cryoTUD/optobot/README.md

# optobot

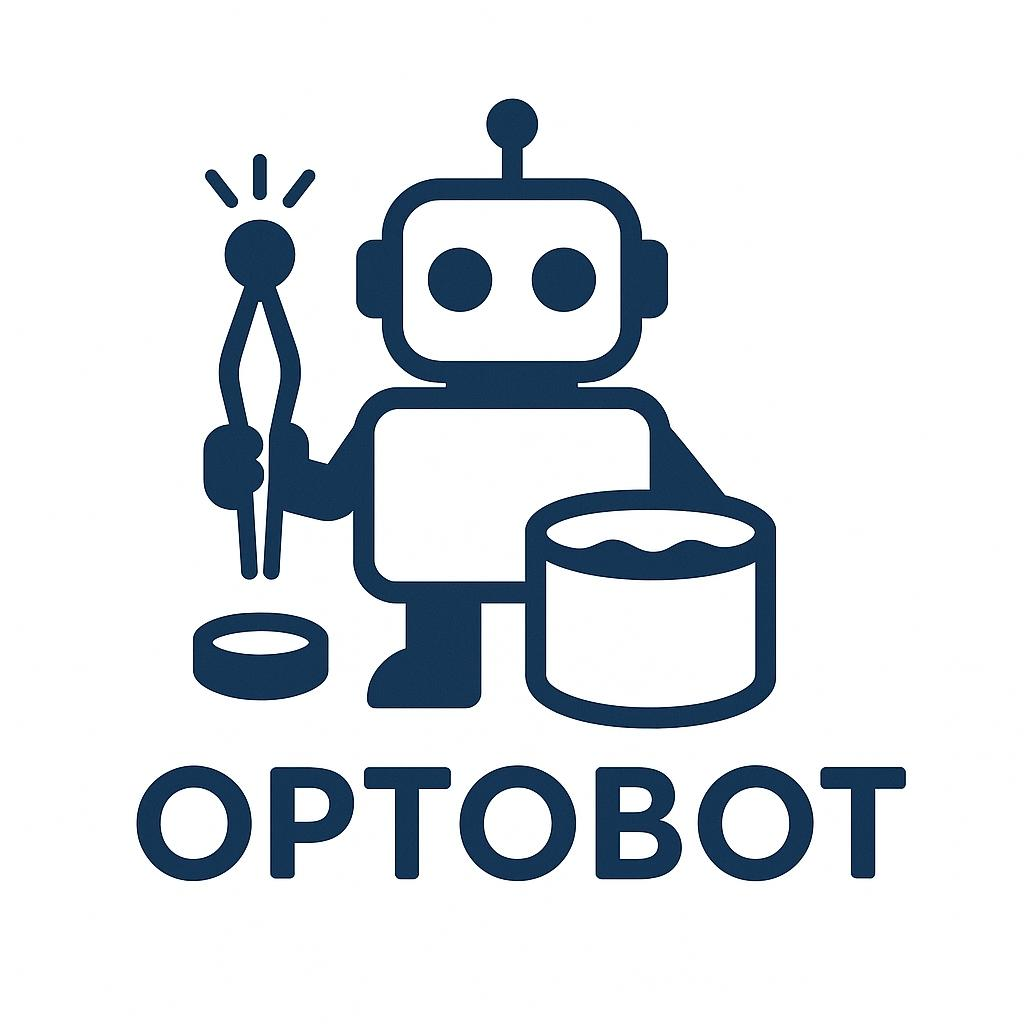
[picture p1: docs/optobot_logo.jpg]
