cryoTUD/optobot/modules/00_Electronics/images/Control Box/Control box Bottom lid with Electronics.png

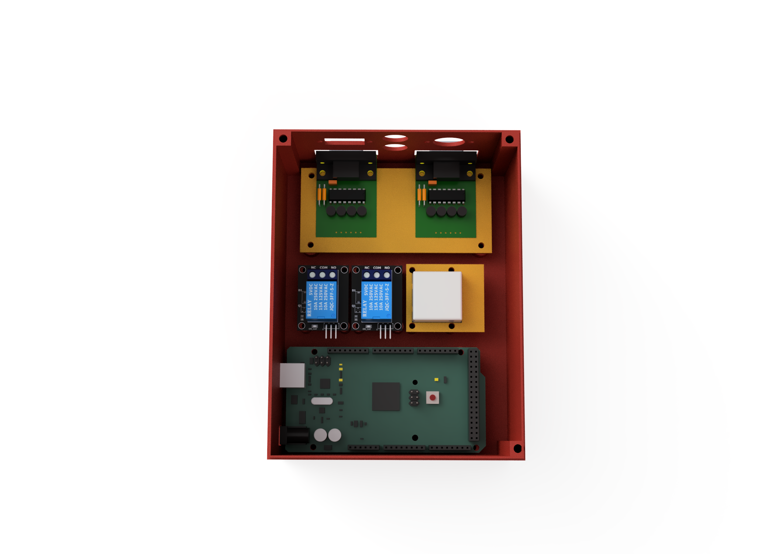
modules/00_Electronics/images/Control Box/Control box Bottom lid with Electronics.png
