cryoTUD/optobot/modules/00_Electronics/images/Control Box/Control Box Isometric Left.png

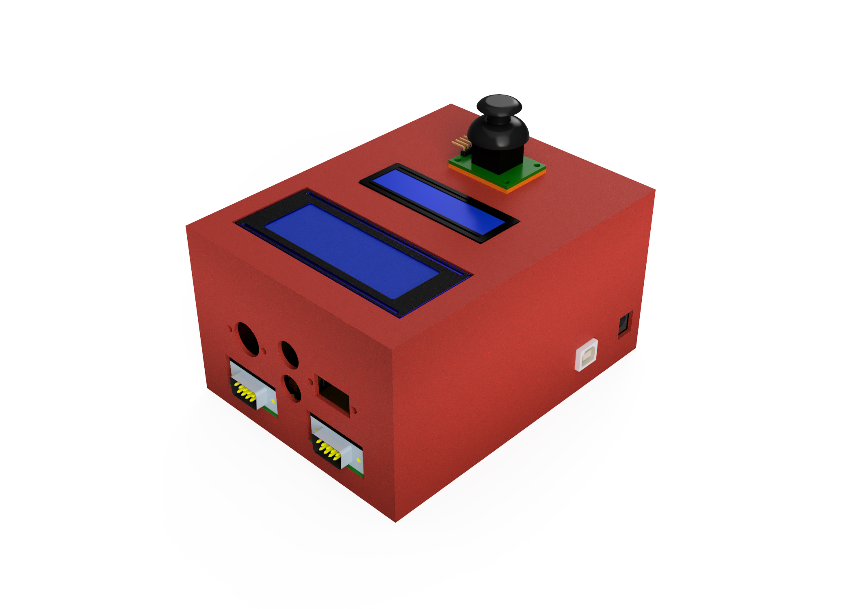
modules/00_Electronics/images/Control Box/Control Box Isometric Left.png
