cryoTUD/optobot/modules/00_Electronics/images/Control Box/Control Box Isometric right.png

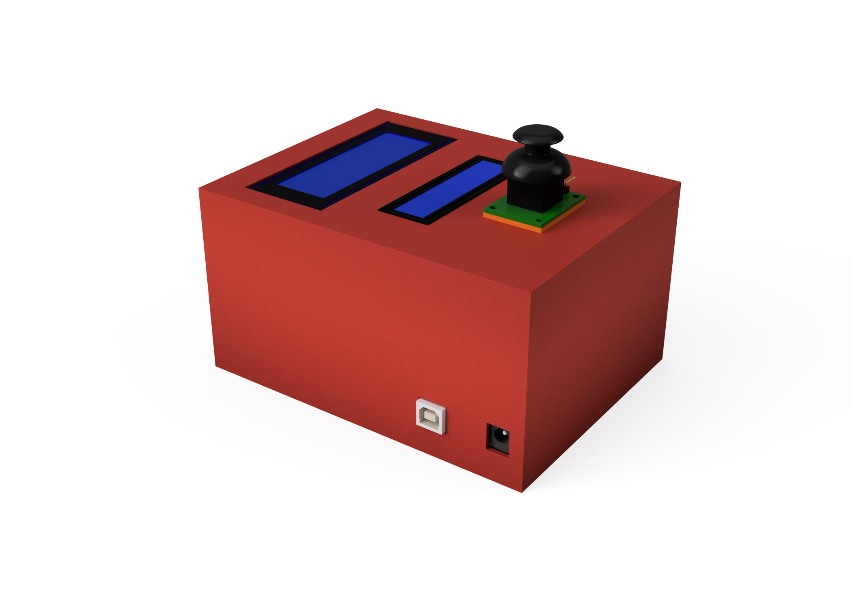
modules/00_Electronics/images/Control Box/Control Box Isometric right.png
