cryoTUD/optobot/modules/00_Electronics/images/Control Box/Control box Top lid with electronics.png

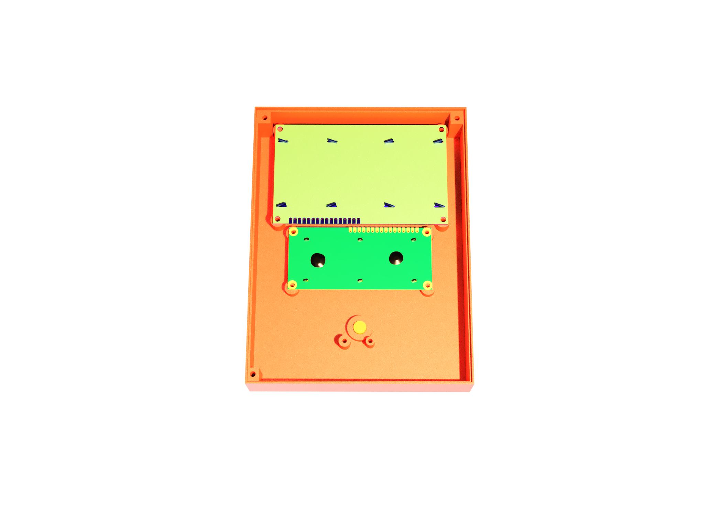
modules/00_Electronics/images/Control Box/Control box Top lid with electronics.png
