cryoTUD/optobot/modules/00_Electronics/images/PID Box/PID box bottom lid with electronics.png

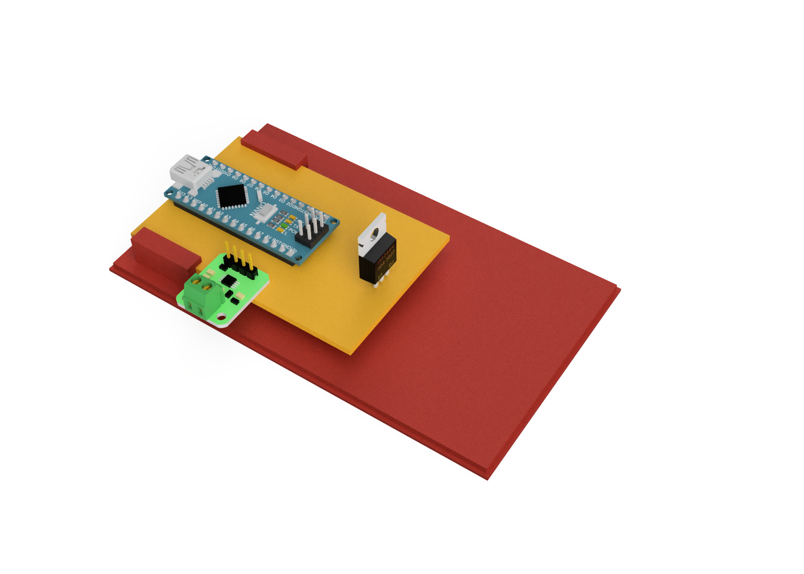
modules/00_Electronics/images/PID Box/PID box bottom lid with electronics.png
