cryoTUD/optobot/modules/00_Electronics/images/PID Box/PID Box Isometric Front.png

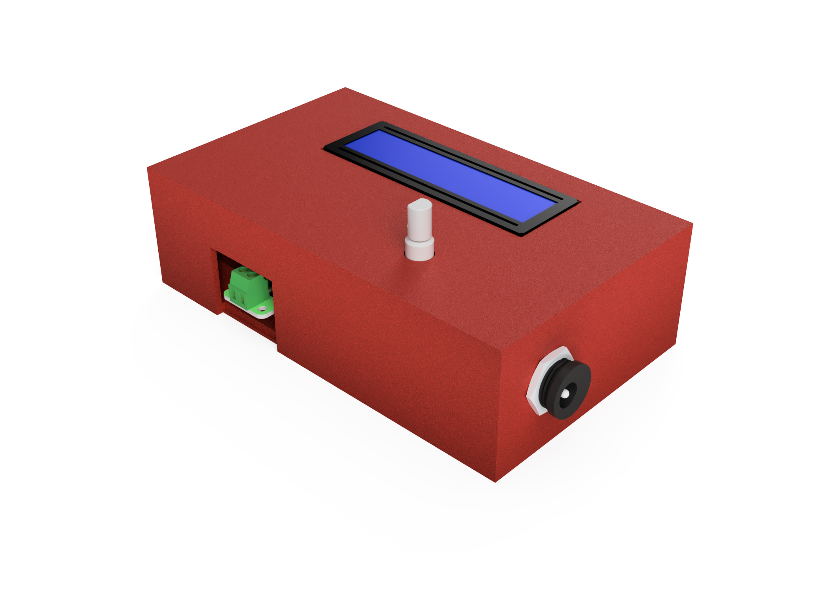
modules/00_Electronics/images/PID Box/PID Box Isometric Front.png
