cryoTUD/optobot/modules/00_Electronics/images/PID Box/PID box isometric rear.png

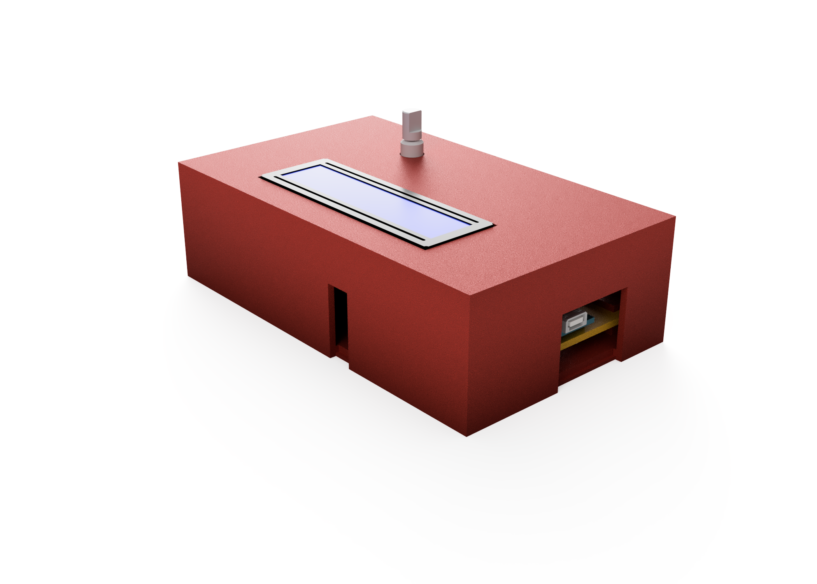
modules/00_Electronics/images/PID Box/PID box isometric rear.png
