cryoTUD/optobot/modules/02_Climate_chamber/images/02.1_Humidifier_Chamber/Humidifier chamber Isometric.png

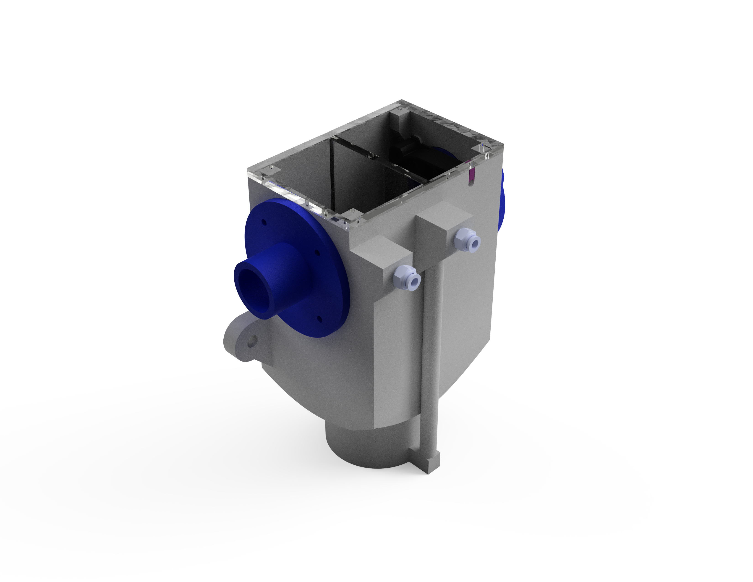
modules/02_Climate_chamber/images/02.1_Humidifier_Chamber/Humidifier chamber Isometric.png
