cryoTUD/optobot/modules/02_Climate_chamber/images/02.2_Reservoir/Reservoir Isometric Front left.png

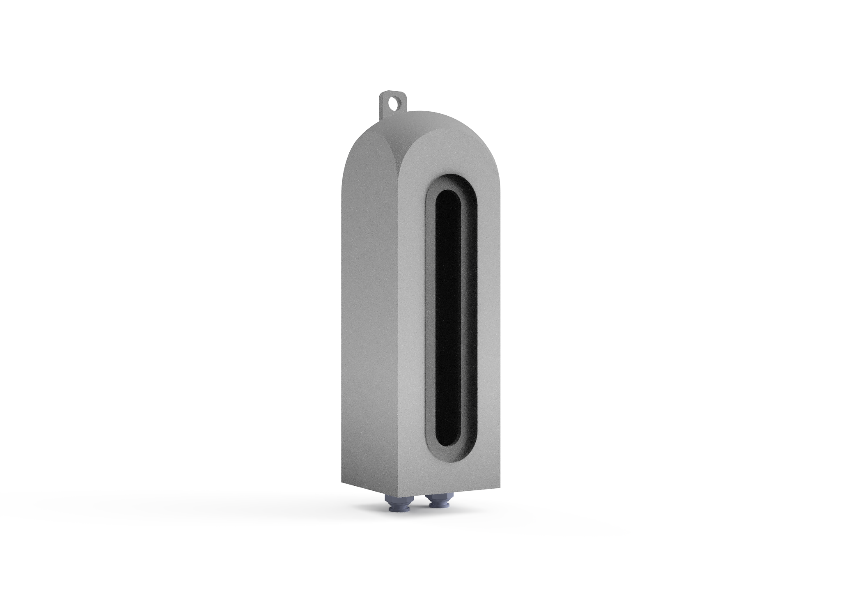
modules/02_Climate_chamber/images/02.2_Reservoir/Reservoir Isometric Front left.png
