cryoTUD/optobot/modules/02_Climate_chamber/images/02_Climate_Chamber/Left front Isometric.PNG

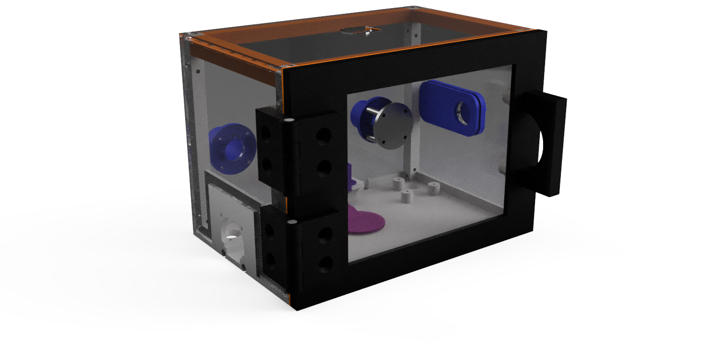
modules/02_Climate_chamber/images/02_Climate_Chamber/Left front Isometric.PNG
