cryoTUD/optobot/modules/02_Climate_chamber/images/02_Climate_Chamber/Left rear Isometric.png

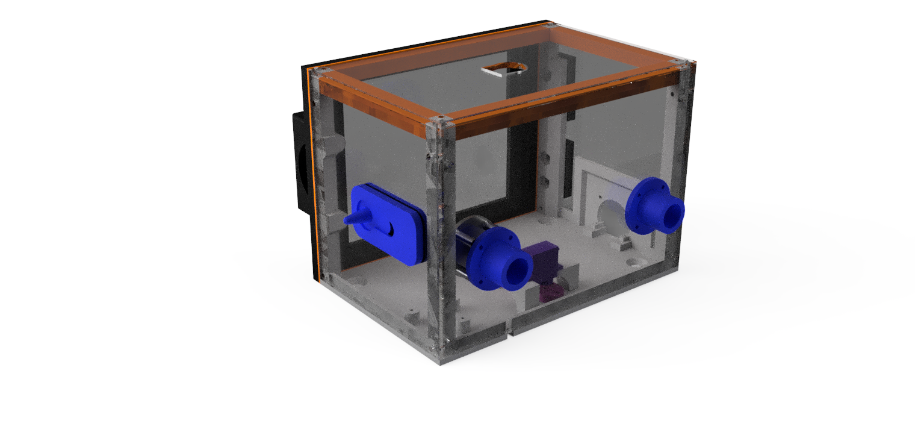
modules/02_Climate_chamber/images/02_Climate_Chamber/Left rear Isometric.png
