cryoTUD/optobot/modules/02_Climate_chamber/images/02_Climate_Chamber/Right front Isometric.png

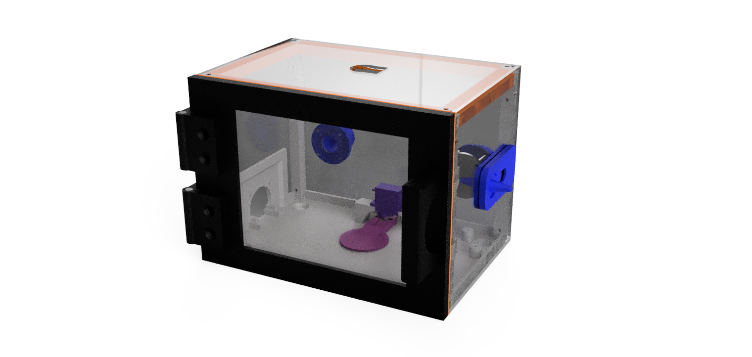
modules/02_Climate_chamber/images/02_Climate_Chamber/Right front Isometric.png
