cryoTUD/optobot/modules/02_Climate_chamber/images/02_Climate_Chamber/Right rear isometric Fine.png

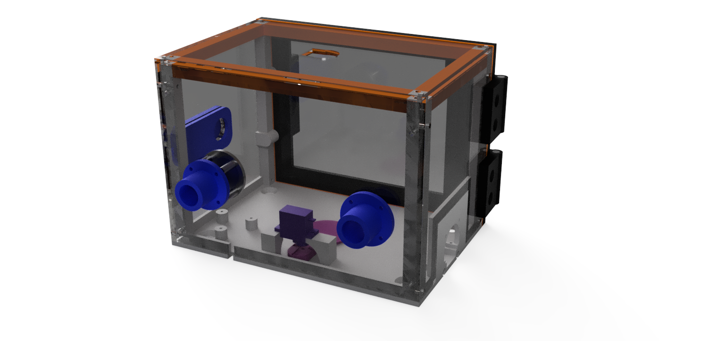
modules/02_Climate_chamber/images/02_Climate_Chamber/Right rear isometric Fine.png
