cryoTUD/optobot/modules/03_Led/images/Lens mount Isometric.png

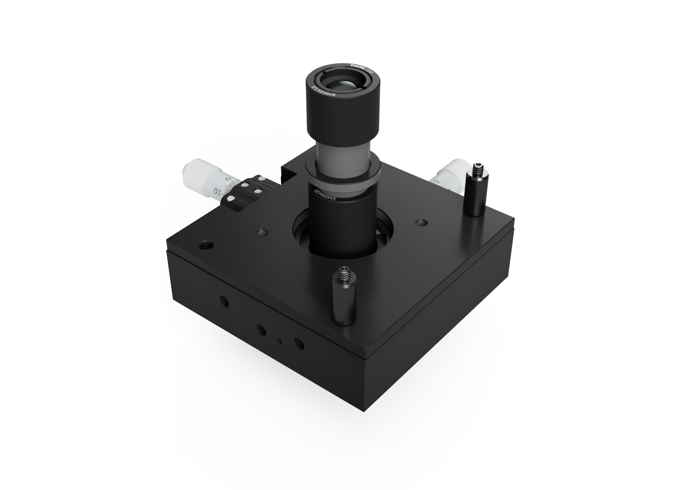
modules/03_Led/images/Lens mount Isometric.png
