cryoTUD/optobot/modules/03_Led/images/Lens mount top.png

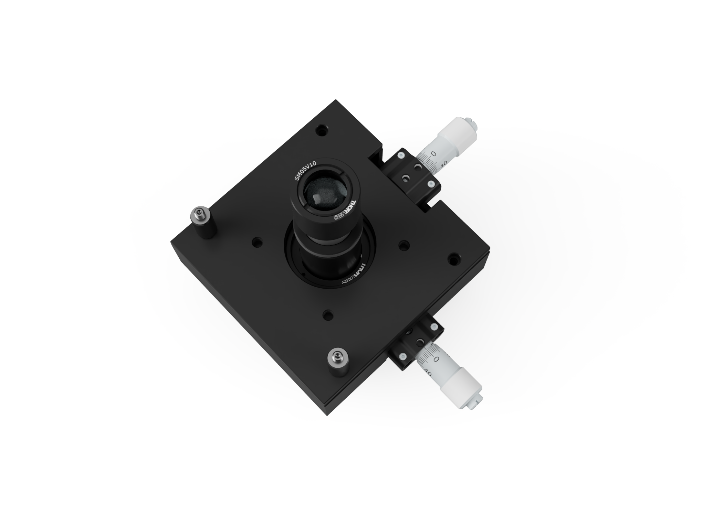
modules/03_Led/images/Lens mount top.png
