cryoTUD/optobot/modules/05_Temperature_controlled_cup/images/Isometric.png

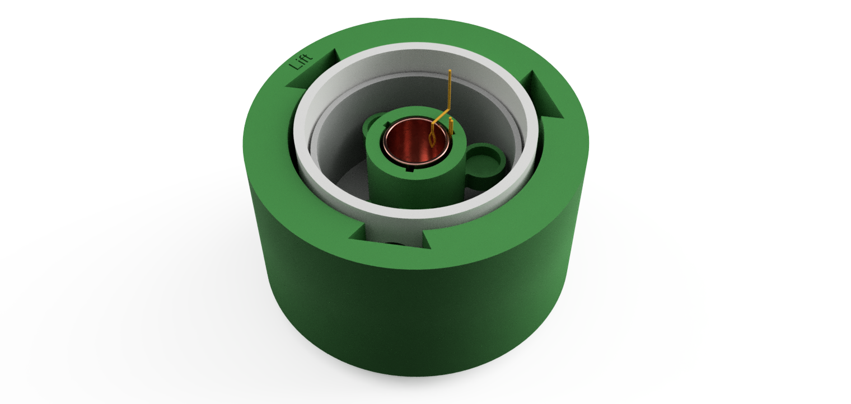
modules/05_Temperature_controlled_cup/images/Isometric.png
