cryoTUD/optobot/modules/05_Temperature_controlled_cup/images/Top.png

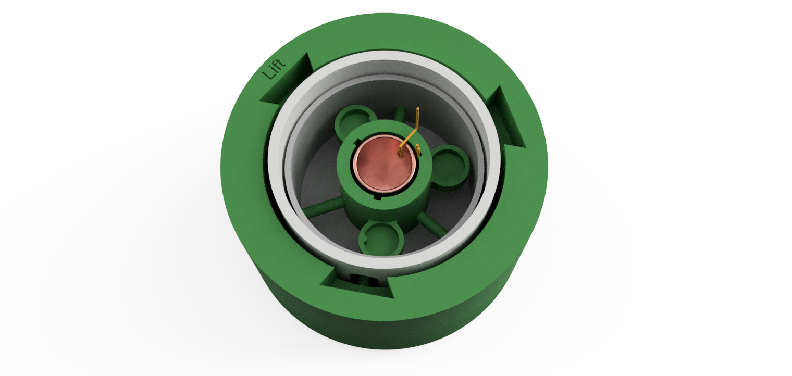
modules/05_Temperature_controlled_cup/images/Top.png
