cryoTUD/optobot/modules/02_Climate_chamber/CAD/Assembly/02.2 Reservoir assembly.step

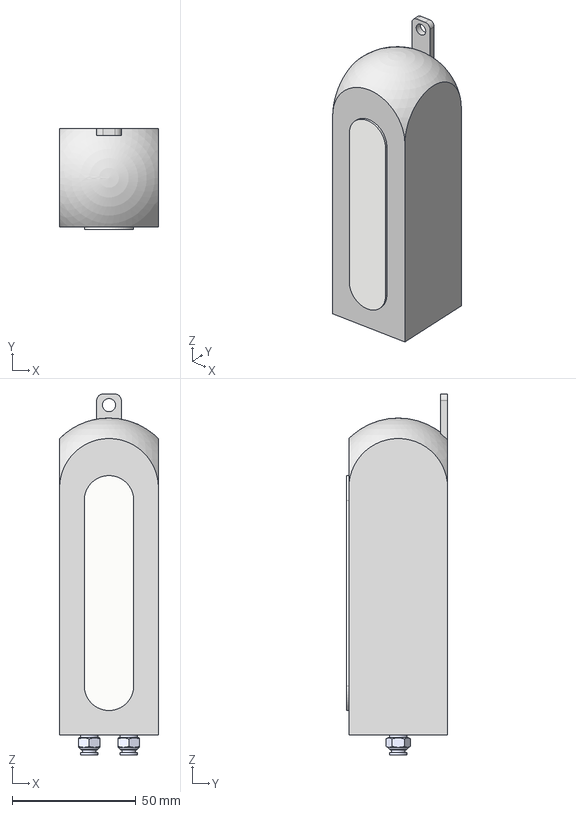
[picture p21: CAD file, 2026-11-11]
modules/02_Climate_chamber/CAD/Assembly/02.2 Reservoir assembly.step
40.0 x 41.0 x 146.0 mm
02-23 Reservoir
02-24 Reservoir window
02-34 Pneumatic fitting 6mm, M5, Placeholder x 2
