cryoTUD/optobot/modules/04_Plunger_motor/CAD/Assembly/04 - Plunger motor Assembly.step

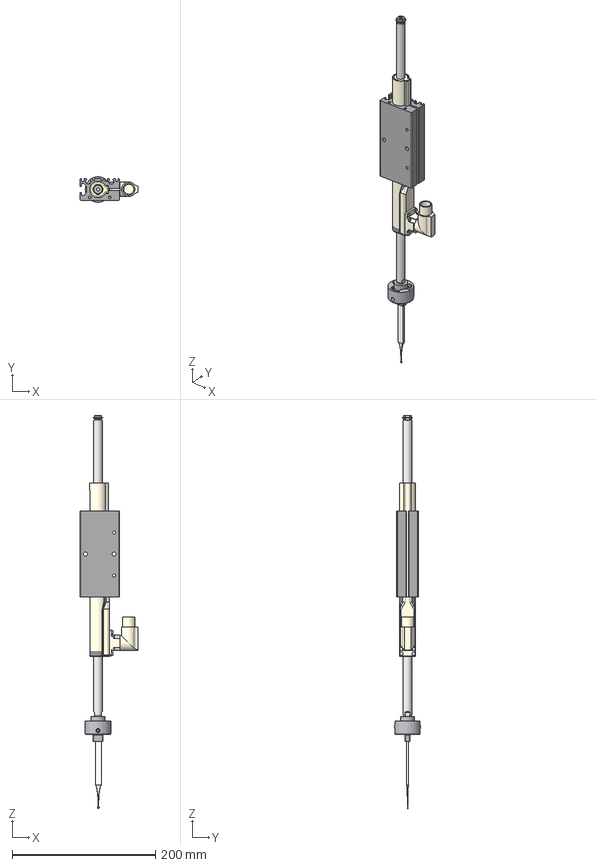
[picture p23: CAD file, 2026-11-11]
modules/04_Plunger_motor/CAD/Assembly/04 - Plunger motor Assembly.step
80.7 x 35.7 x 548.1 mm
04-03 Plunger motor linear slider
04-17 12mm Circlip Placeholder
04-15 Tweezer snaplock Male
04-16 Tweezer snaplock Female
Tweezer Placeholder
04-01 Plunger Connection Flange
PS01-23-R_PS01-23x160-R_Stator
PS01-23-R_PS01-23x160-R_Connector
