cryoTUD/optobot/modules/02_Climate_chamber/CAD/Assembly/02.3 Valve assembly.step

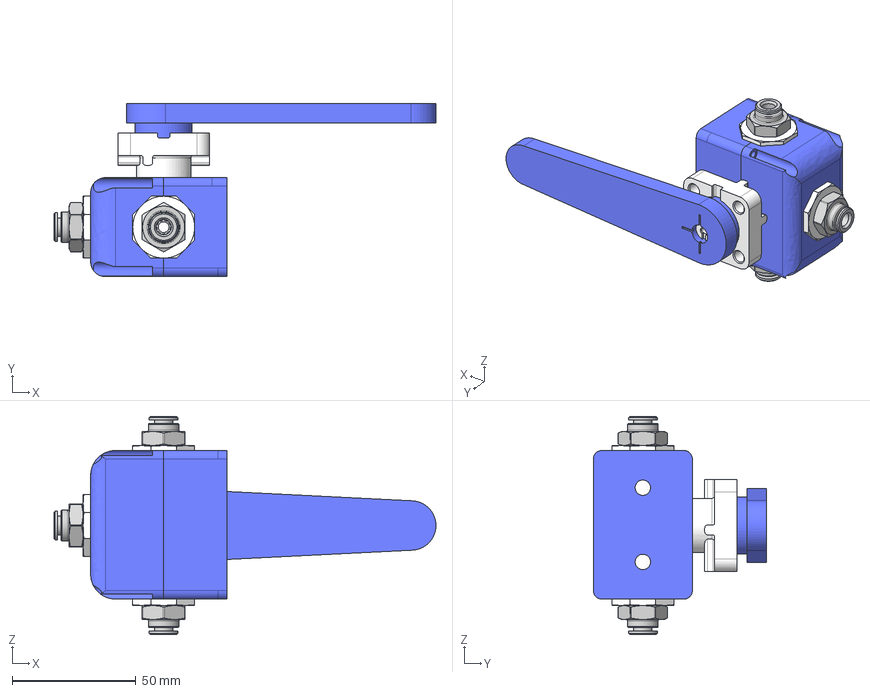
[picture p24: CAD file, 2026-11-11]
modules/02_Climate_chamber/CAD/Assembly/02.3 Valve assembly.step
154.3 x 70.0 x 88.1 mm
02-40 Valve support box
02-41 Valve support box lid
02-37 3-way Valve Placeholder
02-33 Pneumatic fitting 6mm, 1/4 In, Placeholder x 3
02-38 Valve lever
