cryoTUD/optobot/modules/00_Electronics/CAD/Assembly/00 - Control Box.step

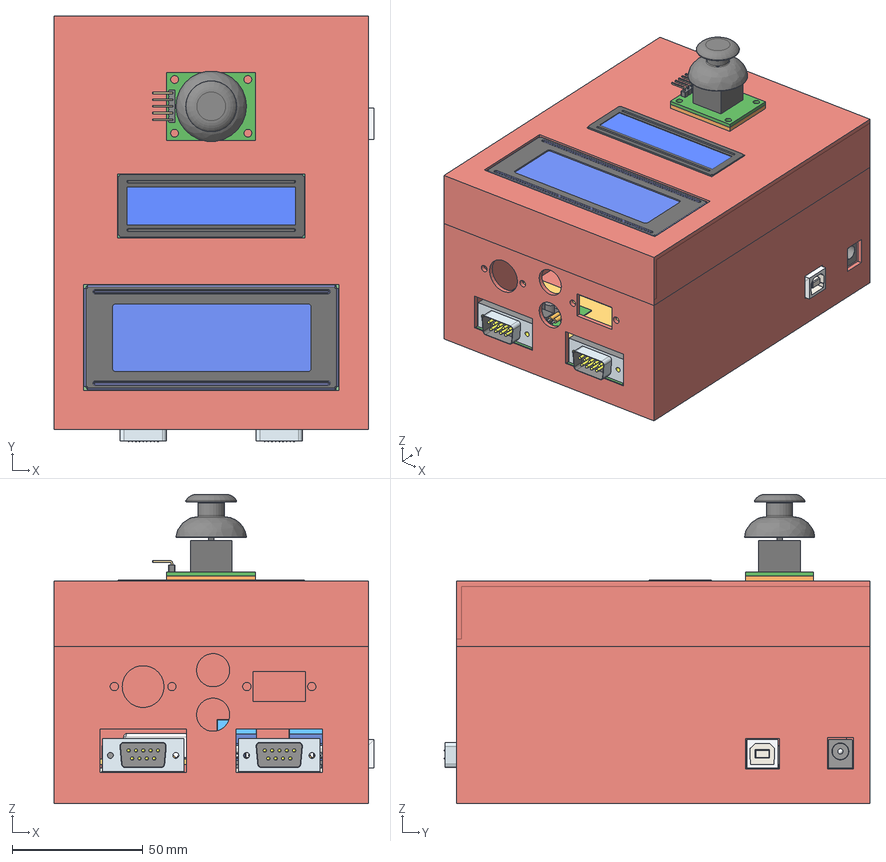
[picture p25: CAD file, 2026-11-11]
modules/00_Electronics/CAD/Assembly/00 - Control Box.step
122.1 x 162.7 x 118.2 mm
00-01 Control Box Bottom
00-02 Control Box Top
00-05 Arduino Mega Placeholder
00-06 Board relay Placeholder x 2
00-14 Perfboard Max232 support Placeholder
00-19 Perfboard DC/DC converter support Placeholder
00-10 DC/DC converter Placeholder
00-09 Joystick mount
00-12 LDC 16x2 Placeholder
00-11 LCD 20x4 Placeholder
