cryoTUD/optobot/modules/00_Electronics/CAD/STEP/00-19 Perfboard DC-DC converter support Placeholder.step

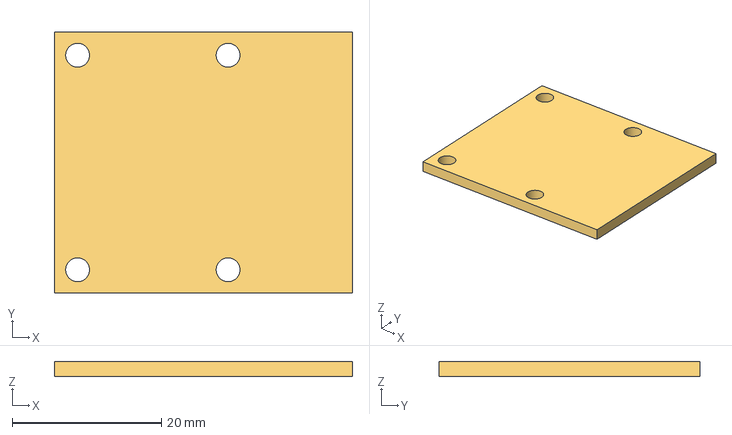
[picture p26: CAD file, 2026-11-11]
modules/00_Electronics/CAD/STEP/00-19 Perfboard DC-DC converter support Placeholder.step
40.0 x 35.0 x 2.00 mm
