cryoTUD/optobot/modules/00_Electronics/CAD/STL/00-01 Control Box Bottom.stl

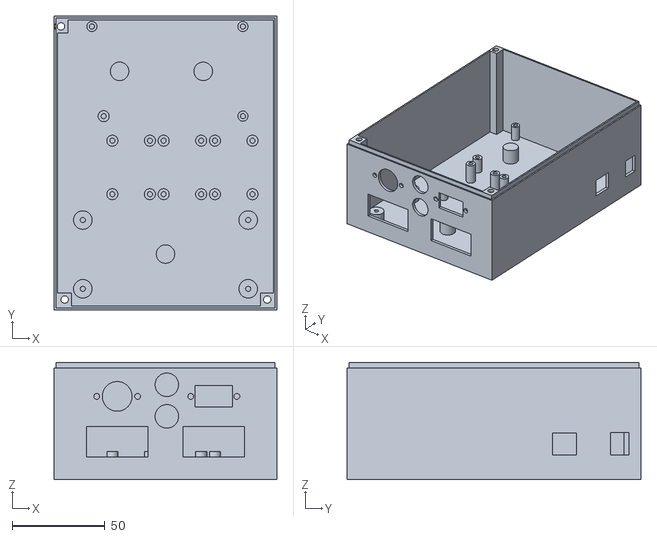
[picture p27: CAD file, 2026-11-11]
modules/00_Electronics/CAD/STL/00-01 Control Box Bottom.stl
120.0 x 158.0 x 63.0
