cryoTUD/optobot/modules/01_Blotting/CAD/Assembly/01 Blotting.step

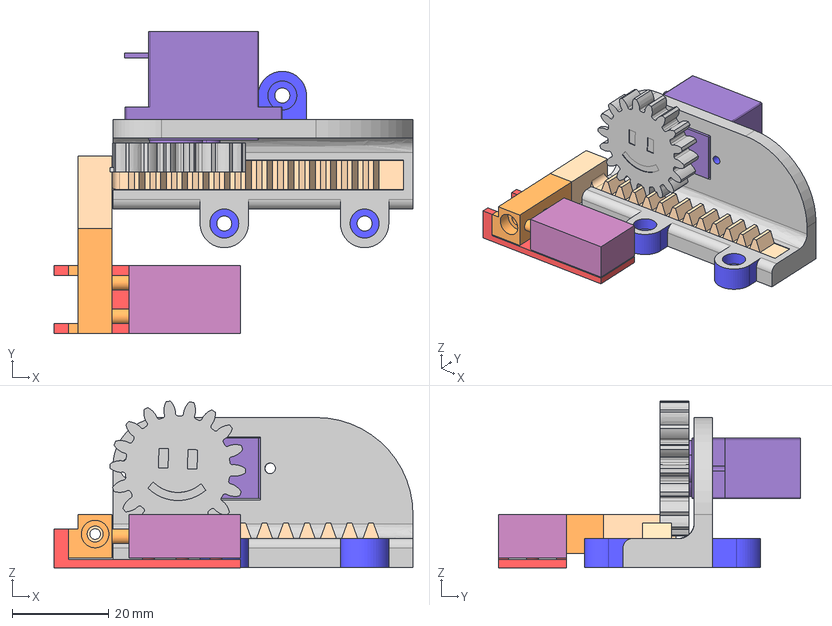
[picture p28: CAD file, 2026-11-11]
modules/01_Blotting/CAD/Assembly/01 Blotting.step
74.2 x 62.4 x 34.5 mm
01-01 Blotter Servo
01-02 Blotter mount
01-03 Gear rack
01-04 Slider connecter
01-06 Guide block
01-05 Slider
01-01 Blotter Servo add-on
01-07 Servo Gear
