cryoTUD/optobot/modules/01_Blotting/CAD/STEP/01-07 Servo Gear.step

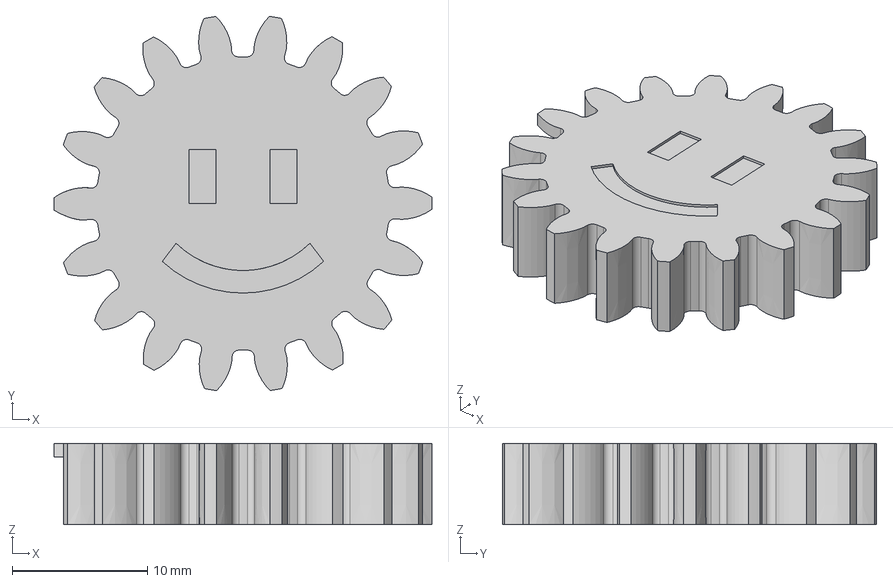
[picture p29: CAD file, 2026-11-11]
modules/01_Blotting/CAD/STEP/01-07 Servo Gear.step
28.0 x 27.7 x 6.00 mm
