cryoTUD/optobot/modules/02_Climate_chamber/CAD/DXF/02-20 Chamber divider horizontal.dxf

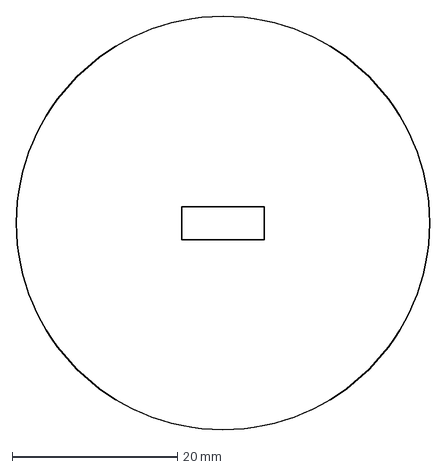
[picture p30: CAD file, 2026-11-11]
modules/02_Climate_chamber/CAD/DXF/02-20 Chamber divider horizontal.dxf
50.0 x 50.0 mm
