cryoTUD/optobot/modules/02_Climate_chamber/CAD/STEP/02-07 Door v2.step

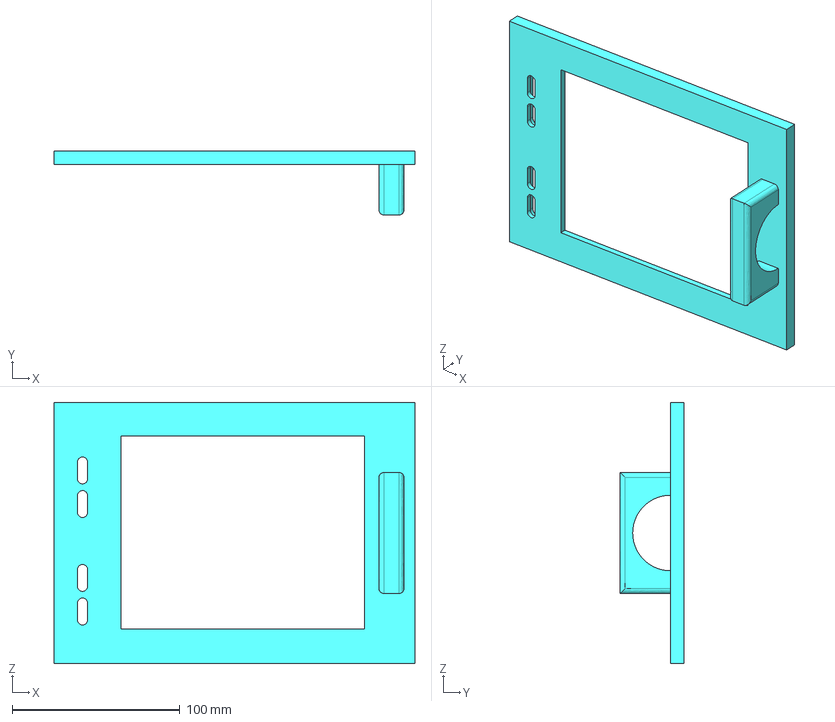
[picture p31: CAD file, 2026-11-11]
modules/02_Climate_chamber/CAD/STEP/02-07 Door v2.step
215.0 x 38.0 x 155.5 mm
