cryoTUD/optobot/modules/02_Climate_chamber/CAD/STL/02-08 Door hinge 1 side.stl

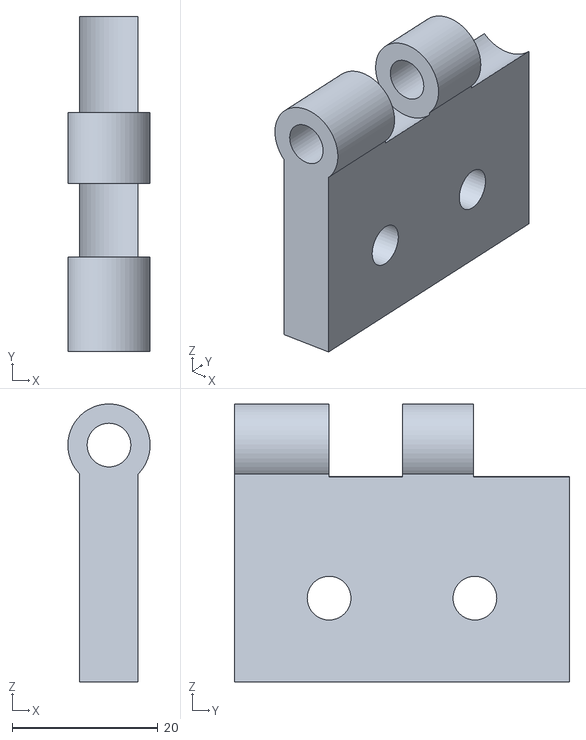
[picture p32: CAD file, 2026-11-11]
modules/02_Climate_chamber/CAD/STL/02-08 Door hinge 1 side.stl
11.3 x 46.0 x 38.1
