cryoTUD/optobot/modules/03_Led/CAD/Assembly/03 Lens Mount.step

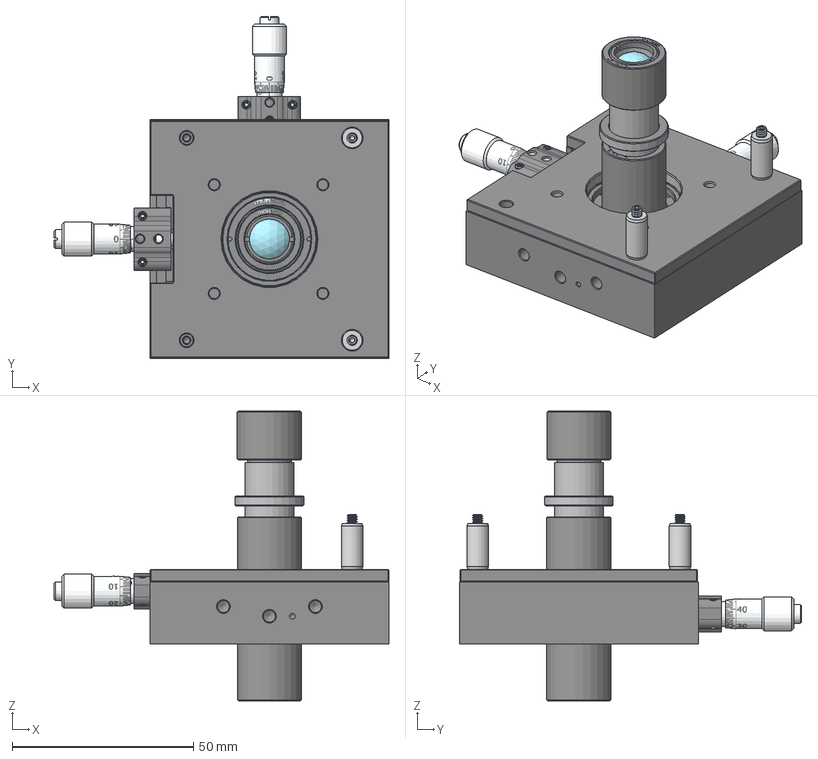
[picture p33: CAD file, 2026-11-11]
modules/03_Led/CAD/Assembly/03 Lens Mount.step
92.5 x 94.5 x 80.0 mm
SM05V10
SM1A60
ST1XY-S/M
ER05-P4 x 2
SM05M20
ACL25416U-A
LA1951-A
