cryoTUD/optobot/modules/03_Led/CAD/STEP/03-07 Green Fiber-Coupled LED.step

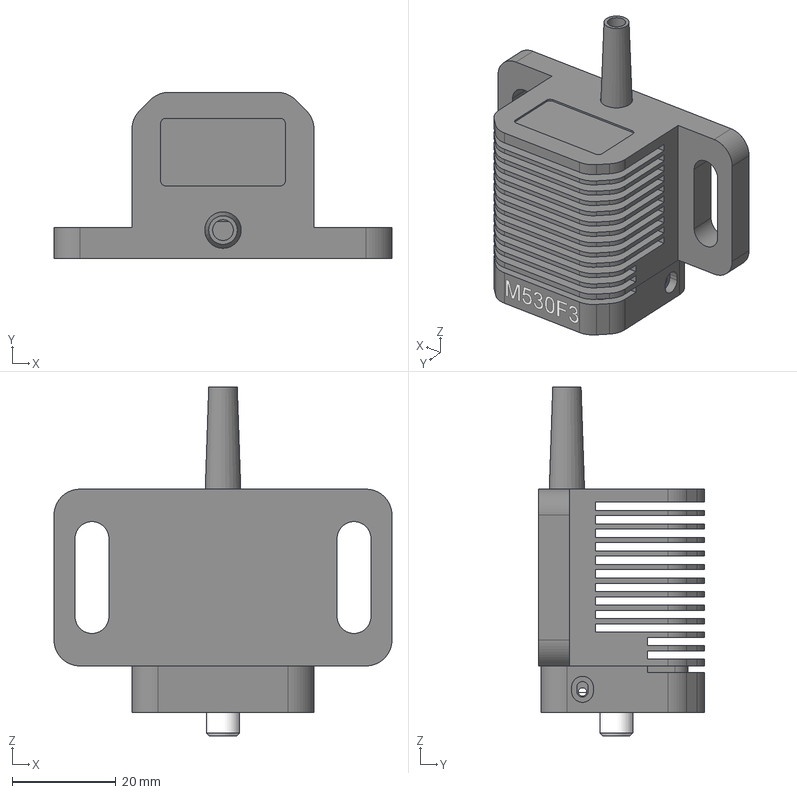
[picture p34: CAD file, 2026-11-11]
modules/03_Led/CAD/STEP/03-07 Green Fiber-Coupled LED.step
65.0 x 32.0 x 67.0 mm
