cryoTUD/optobot/modules/04_Plunger_motor/CAD/STEP/04-19 Lift unit clamping fixture.step

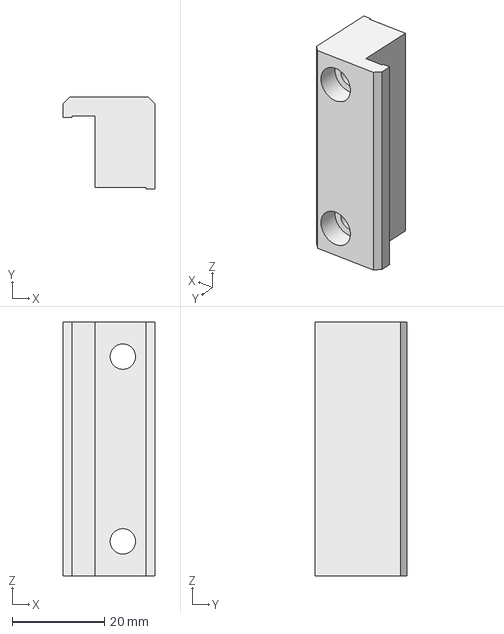
[picture p35: CAD file, 2026-11-11]
modules/04_Plunger_motor/CAD/STEP/04-19 Lift unit clamping fixture.step
20.0 x 20.0 x 55.0 mm
