cryoTUD/optobot/modules/05_Temperature_controlled_cup/CAD/Assembly/05 Temperature-controlled cup.step

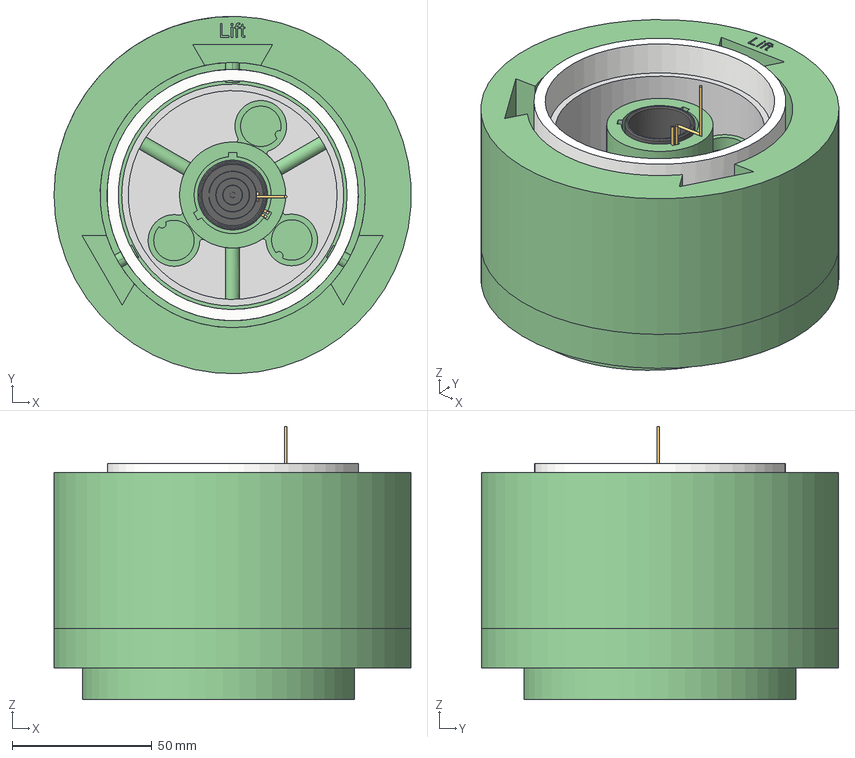
[picture p36: CAD file, 2026-11-11]
modules/05_Temperature_controlled_cup/CAD/Assembly/05 Temperature-controlled cup.step
127.9 x 128.0 x 97.9 mm
05-03 Middle cup
05-02 Base cup top
05-04 Holder Ethane cup & Sample
05-01 Base cup bottom
05-06 Floating ring
05-05 Brass cup Placeholder
05-07 Heater element Placeholder
05-08 Thermocouple Placeholder
