cryoTUD/optobot/modules/05_Temperature_controlled_cup/CAD/STEP/05-02 Base cup top v3.step

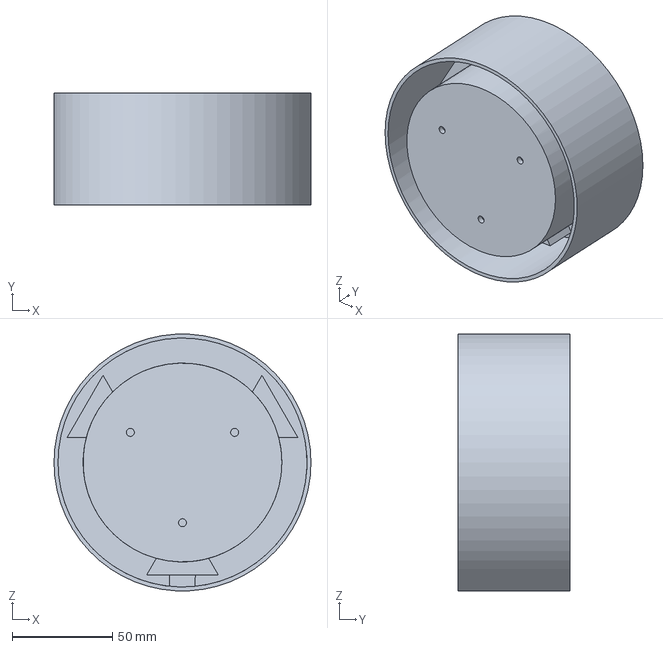
[picture p37: CAD file, 2026-11-11]
modules/05_Temperature_controlled_cup/CAD/STEP/05-02 Base cup top v3.step
128.0 x 56.0 x 127.8 mm
