cryoTUD/optobot/modules/06_Support_structure/CAD/Assembly/06 Support structure.step

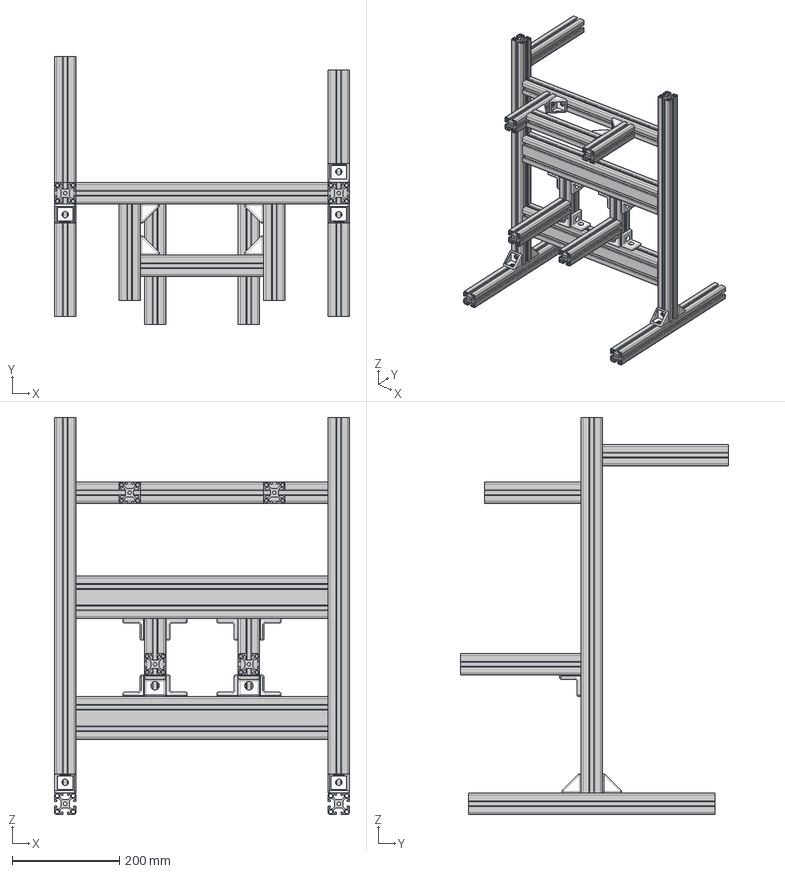
[picture p38: CAD file, 2026-11-11]
modules/06_Support_structure/CAD/Assembly/06 Support structure.step
550.0 x 500.0 x 740.0 mm
06-04 Alu Profile 40x40 L225 x 2
06-03 Alu Profile 40x40 L700 x 2
06-08 Alu Profile 80x40 L470 x 2
06-06 Alu Profile 40x40 L145 x 2
06-05 Alu Profile 40x40 L225 x 2
06-02 Alu Profile 40x40 L470
06-08 Alu Profile 40x40 L235
06-01 Alu Profile 40x40 L180 x 2
06-07 Alu Profile 40x40 L230
Angle bracket Placeholder x 10
Angle Bracket set placeholder x 8
