cryoTUD/optobot/modules/06_Support_structure/CAD/STEP/06-01 Alu Profile 40x40 L180.step

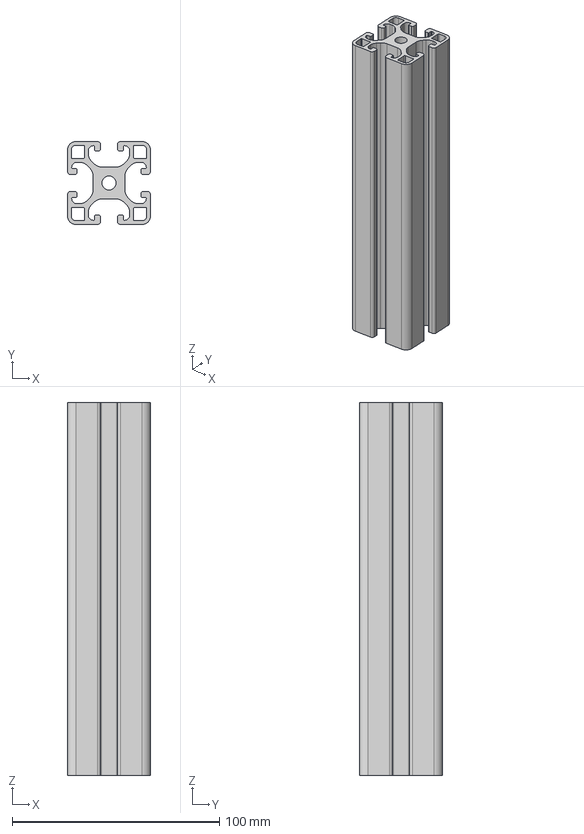
[picture p39: CAD file, 2026-11-11]
modules/06_Support_structure/CAD/STEP/06-01 Alu Profile 40x40 L180.step
40.0 x 40.0 x 180.0 mm
