cryoTUD/optobot/modules/00_Electronics/CAD/Assembly/00.1 PID Box.step

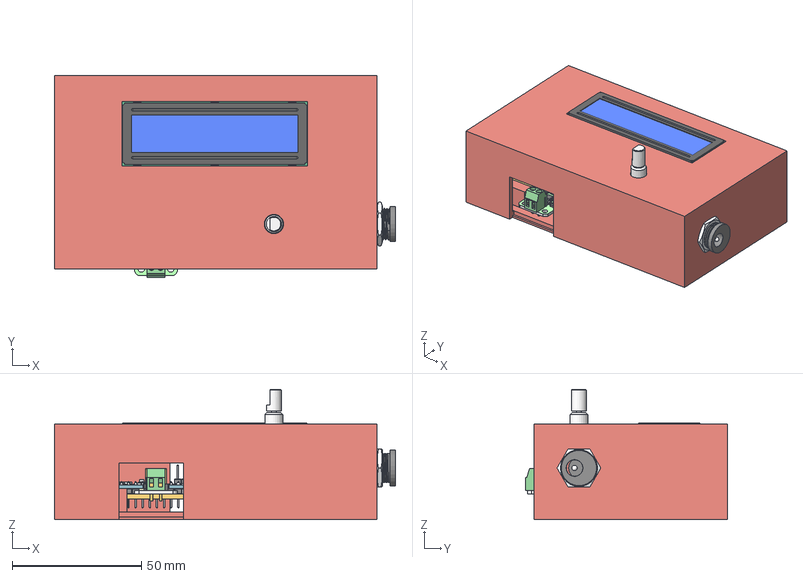
[picture p40: CAD file, 2026-11-11]
modules/00_Electronics/CAD/Assembly/00.1 PID Box.step
132.1 x 78.2 x 50.5 mm
00-03 PID Box top
00-04 PID Box bottom
00-27 Perfboard Arduino Nano support Placeholder
00-22 N-Channel Mosfet Placeholder
00-21 Thermocouple amplifier Placeholder
00-12 LDC 16x2 Placeholder
