cryoTUD/optobot/modules/00_Electronics/CAD/STEP/00-10 DC-DC converter Placeholder.step

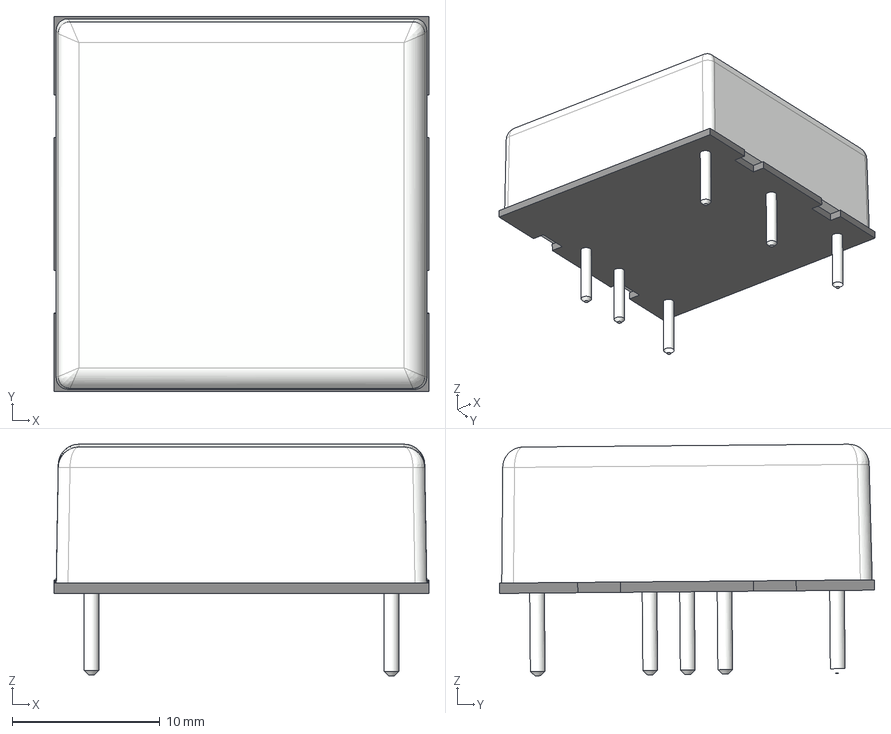
[picture p41: CAD file, 2026-11-11]
modules/00_Electronics/CAD/STEP/00-10 DC-DC converter Placeholder.step
25.4 x 25.4 x 15.7 mm
