cryoTUD/optobot/modules/01_Blotting/CAD/STEP/01-05 Slider v2.step

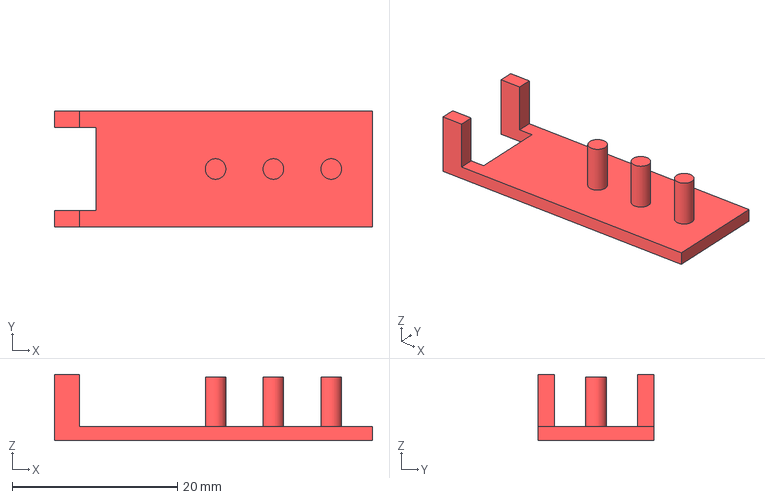
[picture p42: CAD file, 2026-11-11]
modules/01_Blotting/CAD/STEP/01-05 Slider v2.step
38.5 x 14.0 x 8.00 mm
