cryoTUD/optobot/modules/02_Climate_chamber/CAD/Assembly/02 Climate Chamber.step

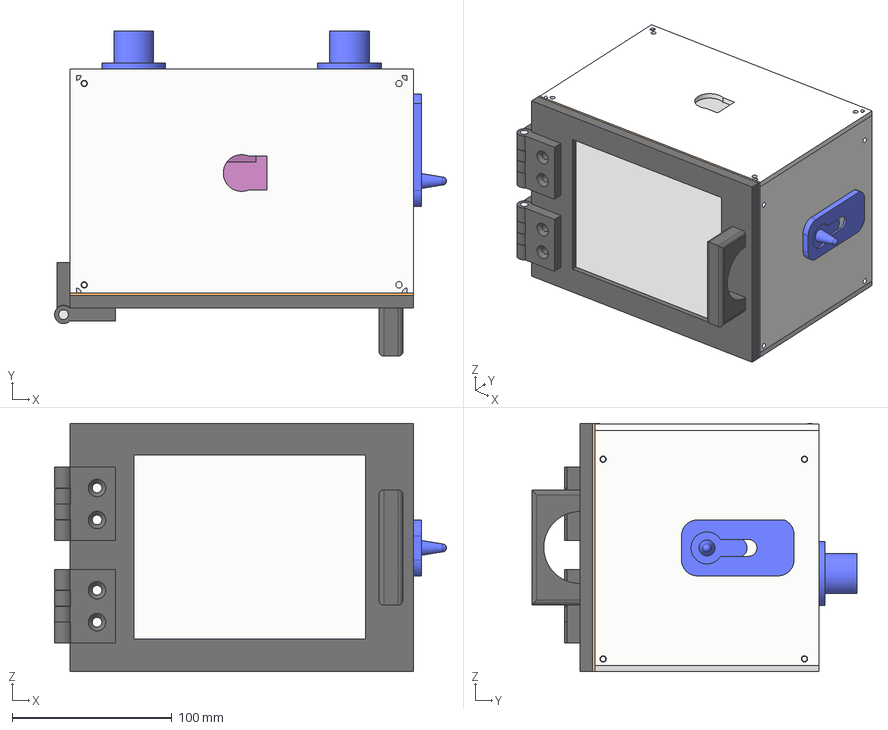
[picture p43: CAD file, 2026-11-11]
modules/02_Climate_chamber/CAD/Assembly/02 Climate Chamber.step
245.4 x 203.7 x 155.5 mm
02-02 Right Wall
02-01 Base Plate
02-03 Left Wall
02-04 Back Wall
02-06 Door Lid
02-07 Door
02-08/1 Door Hinge Side 1 x 2
02-08/2 Door Hinge Side 2 x 2
02-28 Door Hinge Pin x 2
02-05 Top Plate
02-09 Humidity Tube Inlet x 2
02-10 Sample Inlet Housing Inside
02-11 Sample Inlet Housing Outside
02-12 Sample Inlet Slider
02-13 Shutter Servo
02-14 Shutter Plate
02-15 Roof Beam X x 2
02-16 Roof Beam Y x 2
02-17 Door Window
02-29 Door magnet x 2
02-31 Humidity inlet cap
