cryoTUD/optobot/modules/02_Climate_chamber/CAD/DXF/02-05 Top Plate.dxf

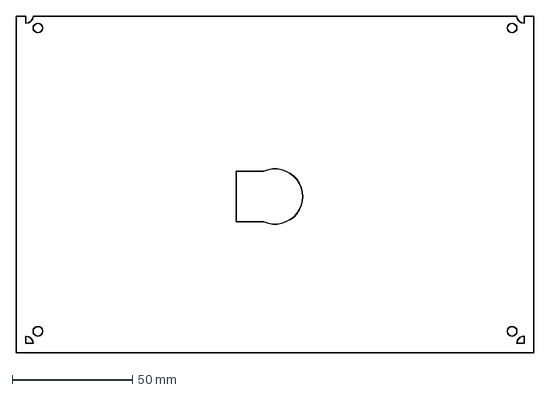
[picture p44: CAD file, 2026-11-11]
modules/02_Climate_chamber/CAD/DXF/02-05 Top Plate.dxf
215.0 x 140.0 mm
