cryoTUD/optobot/modules/02_Climate_chamber/CAD/STEP/02-22 Humidifier cable clamp v2.step

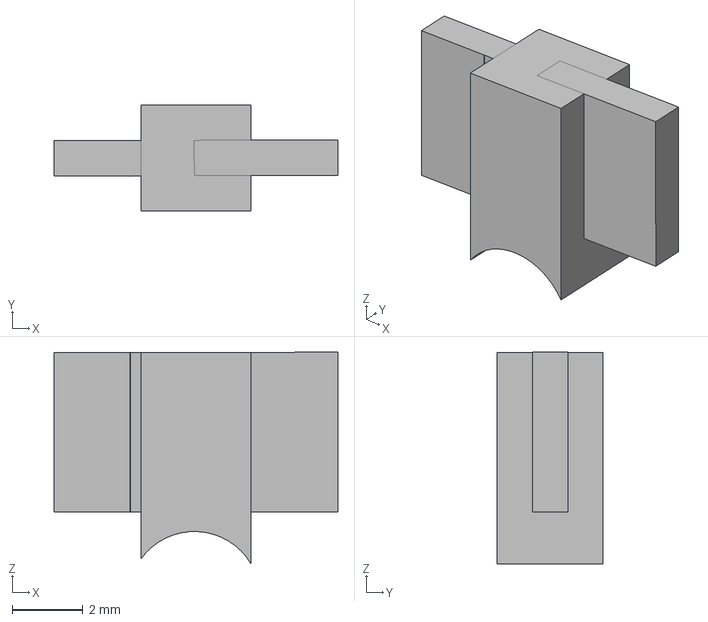
[picture p45: CAD file, 2026-11-11]
modules/02_Climate_chamber/CAD/STEP/02-22 Humidifier cable clamp v2.step
8.00 x 3.00 x 5.96 mm
