cryoTUD/optobot/modules/03_Led/CAD/STEP/03-09 Lens tube adapter mount.step

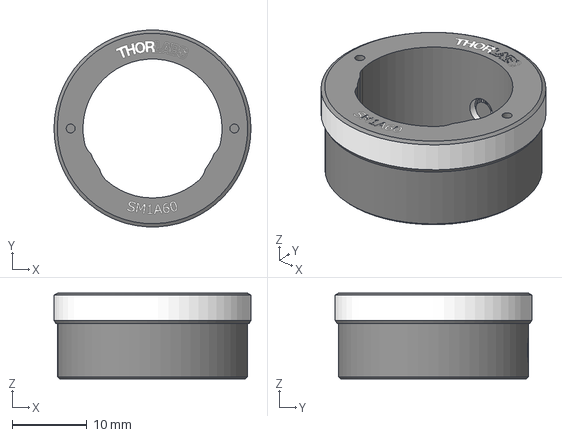
[picture p46: CAD file, 2026-11-11]
modules/03_Led/CAD/STEP/03-09 Lens tube adapter mount.step
26.3 x 26.3 x 11.4 mm
