cryoTUD/optobot/modules/04_Plunger_motor/CAD/STEP/04-02 Plunger linear motor Stator.step

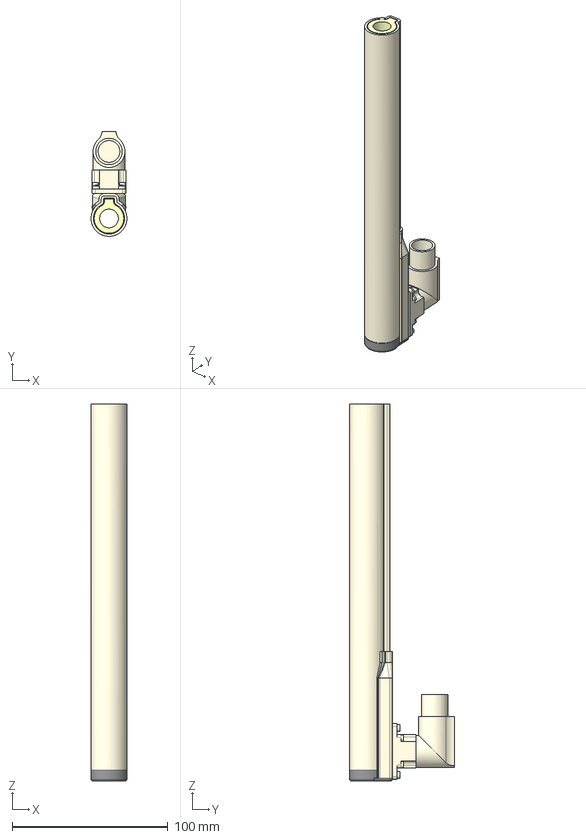
[picture p47: CAD file, 2026-11-11]
modules/04_Plunger_motor/CAD/STEP/04-02 Plunger linear motor Stator.step
23.0 x 67.2 x 242.0 mm
PS01-23-R_PS01-23x160-R_Stator
PS01-23-R_PS01-23x160-R_Connector
