cryoTUD/optobot/modules/05_Temperature_controlled_cup/CAD/STEP/05-06 Floating ring.step

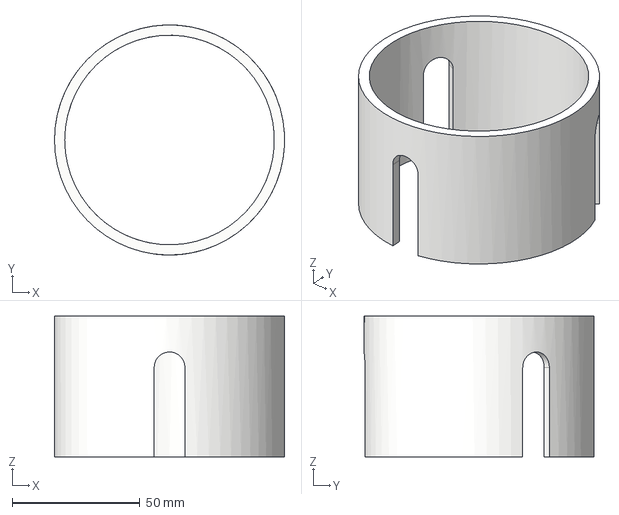
[picture p48: CAD file, 2026-11-11]
modules/05_Temperature_controlled_cup/CAD/STEP/05-06 Floating ring.step
90.0 x 90.0 x 55.0 mm
