cryoTUD/optobot/modules/06_Support_structure/CAD/STEP/06-12 Angle bracket Placeholder.step

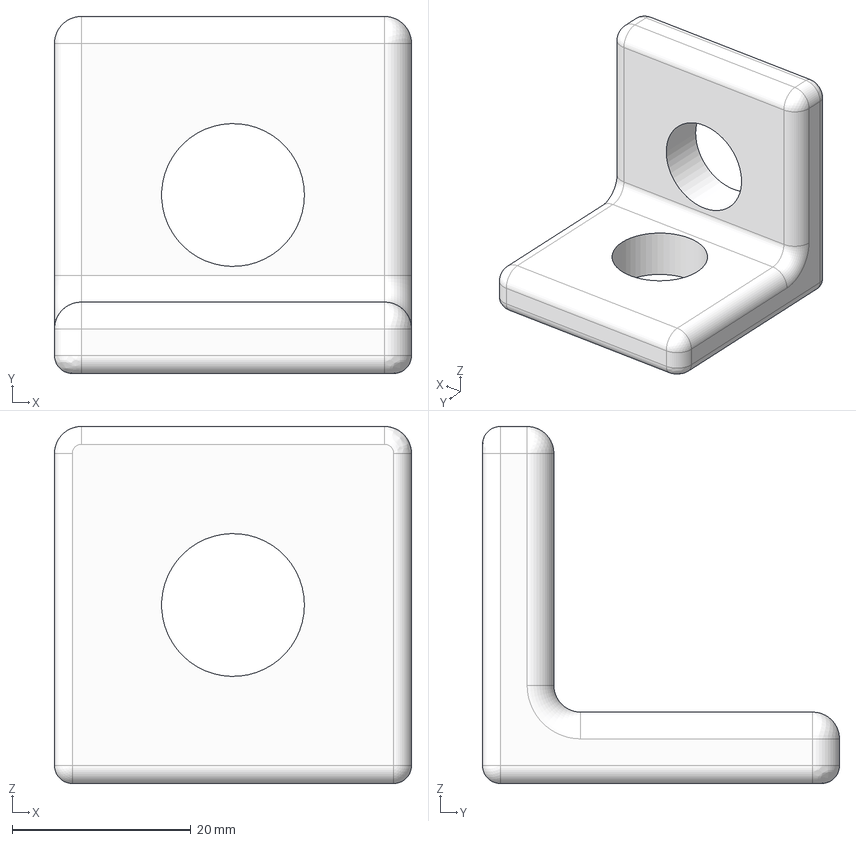
[picture p49: CAD file, 2026-11-11]
modules/06_Support_structure/CAD/STEP/06-12 Angle bracket Placeholder.step
40.0 x 40.0 x 40.0 mm
