cryoTUD/optobot/modules/00_Electronics/CAD/STEP/00-25 DC Jack Female Placehodler.step

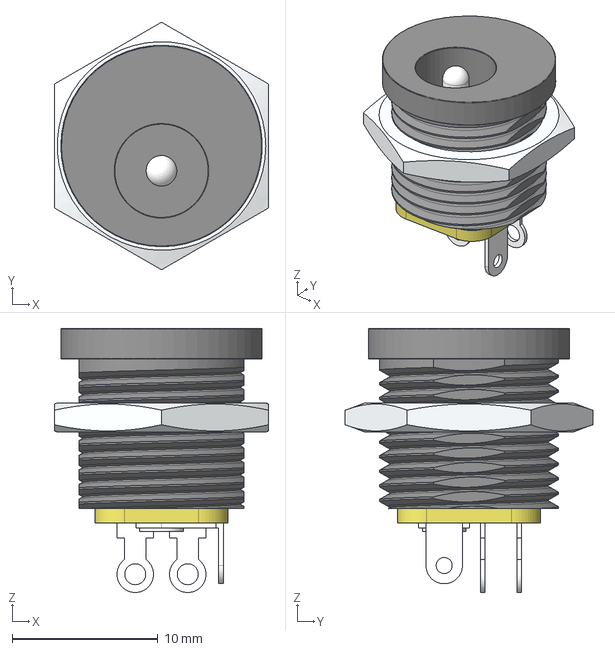
[picture p50: CAD file, 2026-11-11]
modules/00_Electronics/CAD/STEP/00-25 DC Jack Female Placehodler.step
14.7 x 17.0 x 18.1 mm
