cryoTUD/optobot/modules/01_Blotting/CAD/STEP/01-02 Blotter mount v4.step

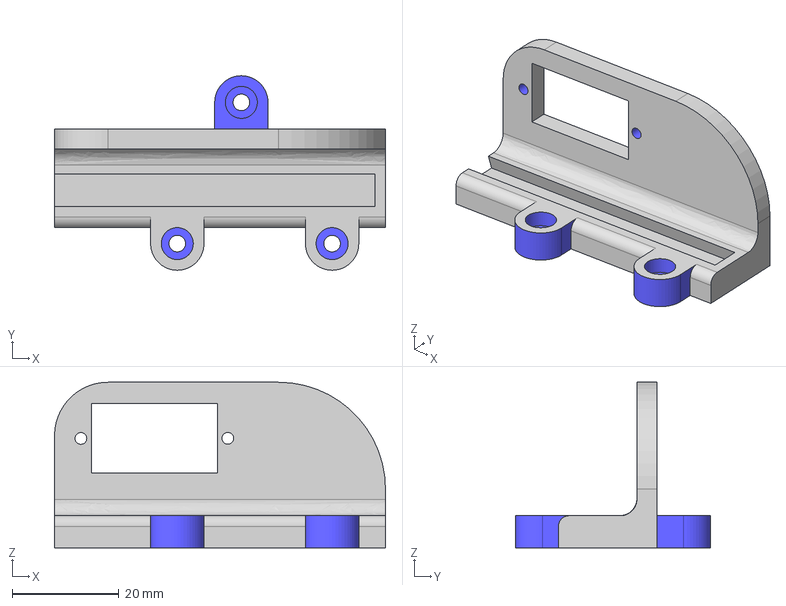
[picture p51: CAD file, 2026-11-11]
modules/01_Blotting/CAD/STEP/01-02 Blotter mount v4.step
62.0 x 36.4 x 31.0 mm
