cryoTUD/optobot/modules/02_Climate_chamber/CAD/Assembly/02.1 Humidifier.step

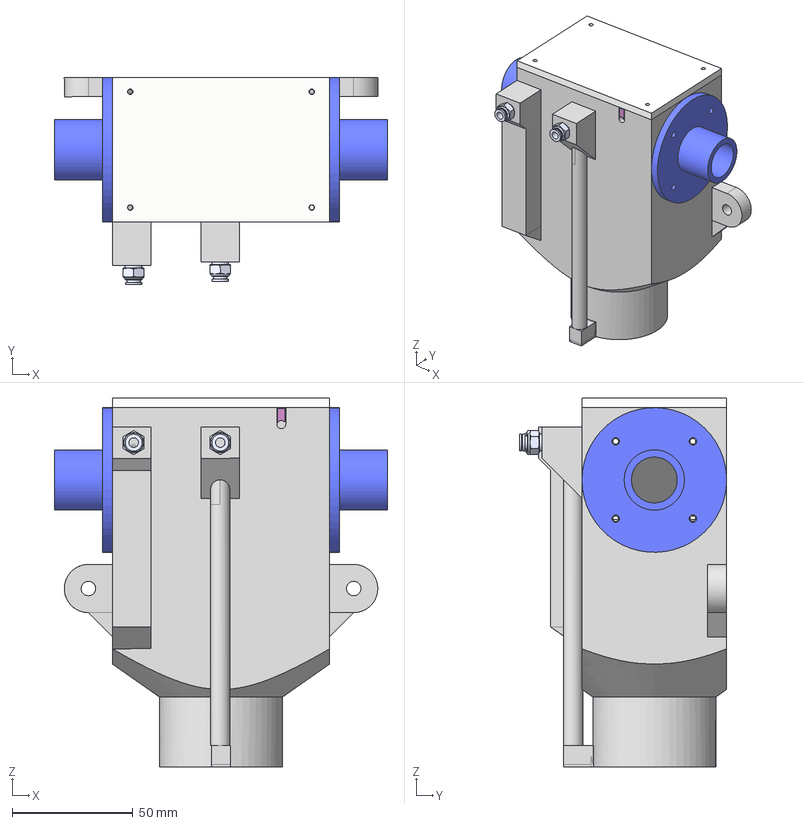
[picture p52: CAD file, 2026-11-11]
modules/02_Climate_chamber/CAD/Assembly/02.1 Humidifier.step
138.1 x 86.0 x 153.0 mm
02-18 Humidifier Chamber
02-19 Chamber divider vertical
02-20 Chamber divider horizontal
02-21 Humidifier chamber Inlet x 2
02-22 Humidifier cable clamp
02-25 Humidifier chamber top lid
02-26 Humidifier Placeholder
02-27 Humidifier Fan placeholder
02-34 Pneumatic fitting 6mm, M5, Placeholder x 2
