cryoTUD/optobot/modules/02_Climate_chamber/CAD/DXF/02-17 Door Window.dxf

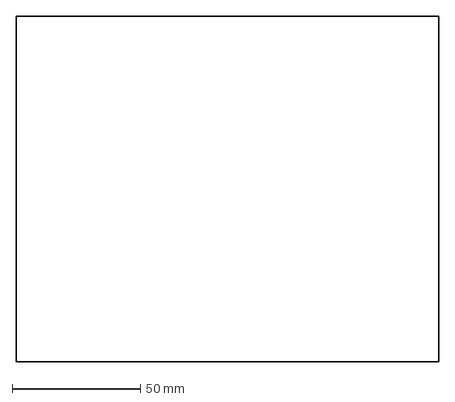
[picture p53: CAD file, 2026-11-11]
modules/02_Climate_chamber/CAD/DXF/02-17 Door Window.dxf
164.8 x 134.8 mm
