cryoTUD/optobot/modules/02_Climate_chamber/CAD/STEP/02-31 Humidity inlet cap.step

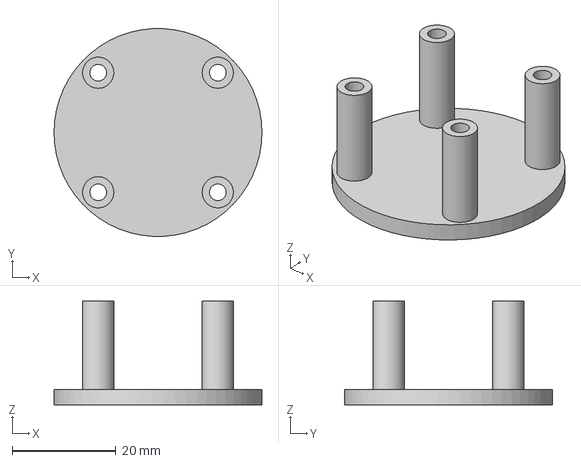
[picture p54: CAD file, 2026-11-11]
modules/02_Climate_chamber/CAD/STEP/02-31 Humidity inlet cap.step
40.0 x 39.9 x 20.0 mm
