cryoTUD/optobot/modules/03_Led/CAD/STEP/03-03 Adjustable Lens tube.step

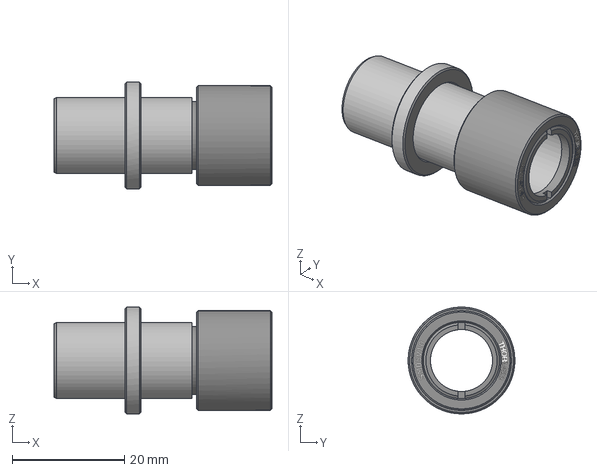
[picture p55: CAD file, 2026-11-11]
modules/03_Led/CAD/STEP/03-03 Adjustable Lens tube.step
38.9 x 19.1 x 19.1 mm
