cryoTUD/optobot/modules/04_Plunger_motor/CAD/STEP/04-03 Plunger motor linear slider.step

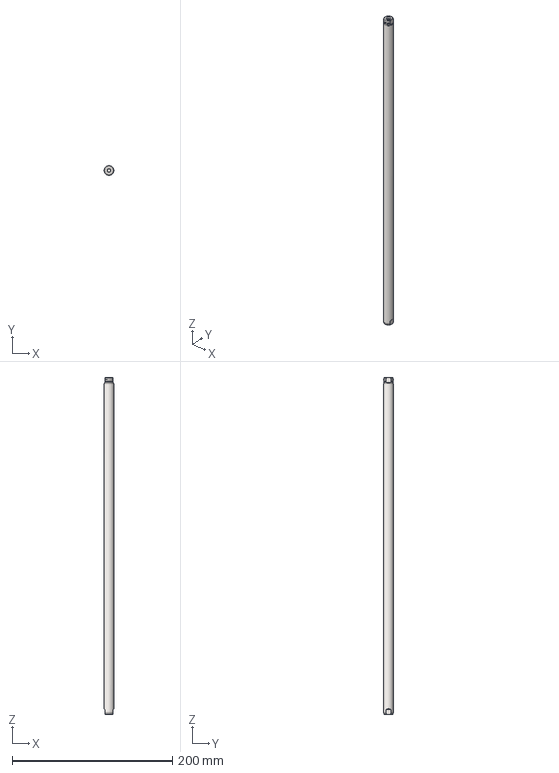
[picture p56: CAD file, 2026-11-11]
modules/04_Plunger_motor/CAD/STEP/04-03 Plunger motor linear slider.step
12.0 x 12.0 x 420.0 mm
