cryoTUD/optobot/modules/05_Temperature_controlled_cup/CAD/STEP/05-07 Heater element Placeholder.step

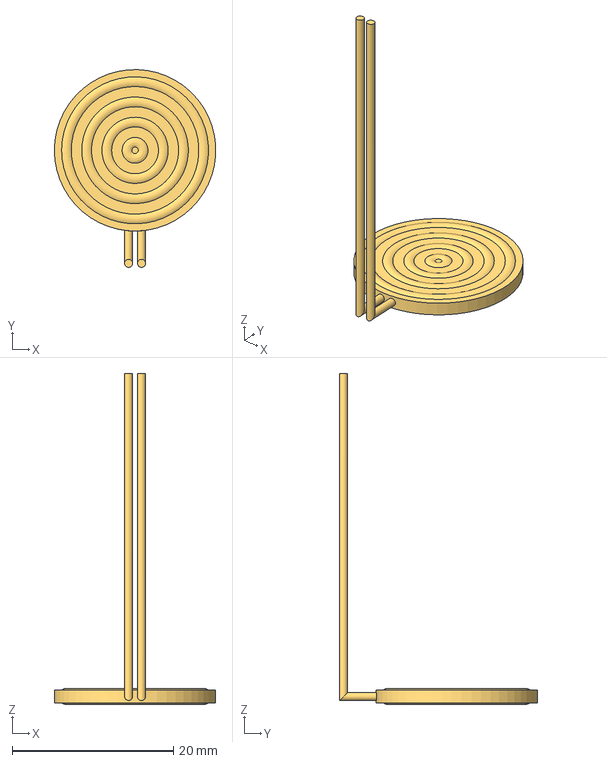
[picture p57: CAD file, 2026-11-11]
modules/05_Temperature_controlled_cup/CAD/STEP/05-07 Heater element Placeholder.step
20.0 x 24.5 x 41.0 mm
