cryoTUD/optobot/modules/06_Support_structure/CAD/STEP/06-02 Alu Profile 40x40 L470.step

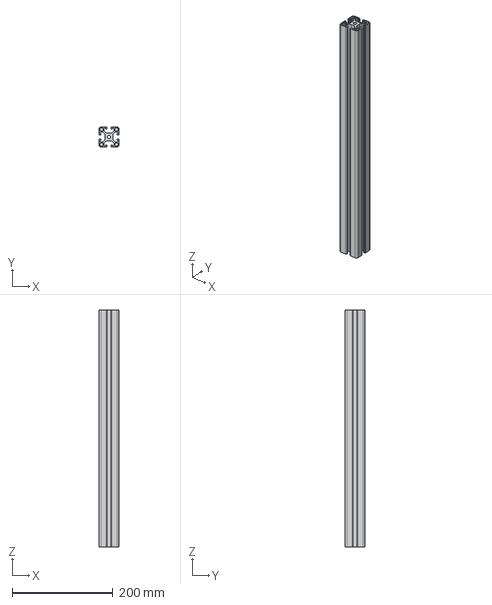
[picture p58: CAD file, 2026-11-11]
modules/06_Support_structure/CAD/STEP/06-02 Alu Profile 40x40 L470.step
40.0 x 40.0 x 470.0 mm
