cryoTUD/optobot/modules/00_Electronics/CAD/STEP/00-14 Perfboard Max232 support Placeholder.step

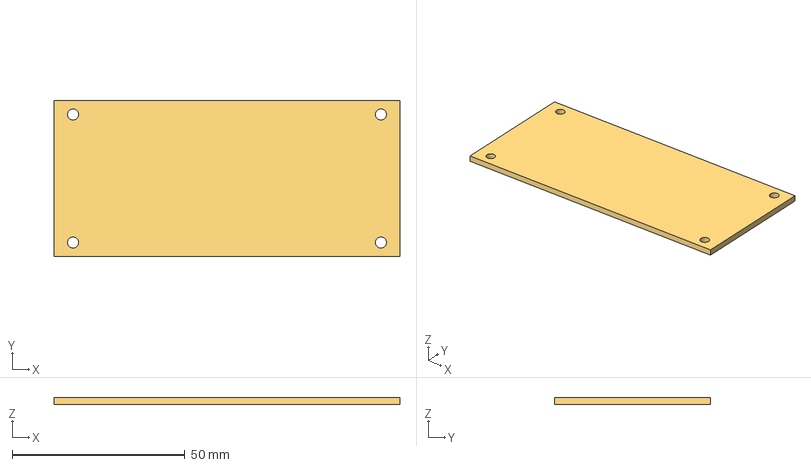
[picture p59: CAD file, 2026-11-11]
modules/00_Electronics/CAD/STEP/00-14 Perfboard Max232 support Placeholder.step
100.0 x 45.0 x 2.00 mm
