cryoTUD/optobot/modules/01_Blotting/CAD/STEP/01-01 Blotter Servo.step

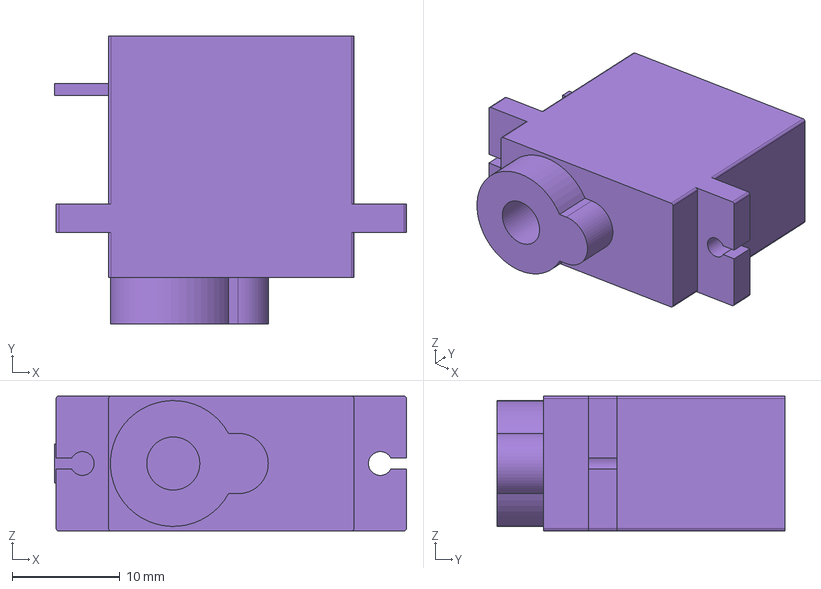
[picture p60: CAD file, 2026-11-11]
modules/01_Blotting/CAD/STEP/01-01 Blotter Servo.step
32.6 x 26.6 x 12.5 mm
