cryoTUD/optobot/modules/02_Climate_chamber/CAD/DXF/02-19 Chamber divider vertical.dxf

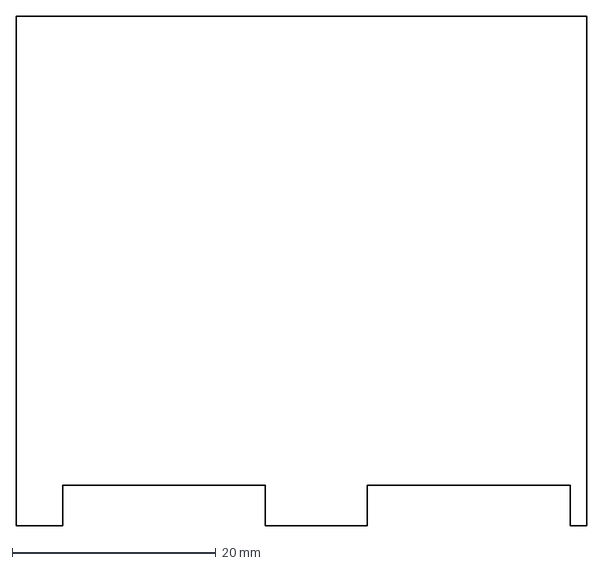
[picture p61: CAD file, 2026-11-11]
modules/02_Climate_chamber/CAD/DXF/02-19 Chamber divider vertical.dxf
56.0 x 50.0 mm
