cryoTUD/optobot/modules/02_Climate_chamber/CAD/STEP/02-17 Door Window v2.step

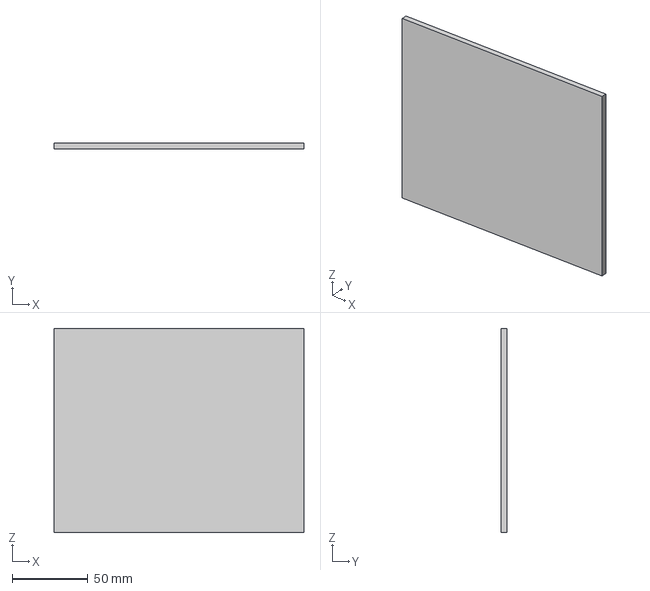
[picture p62: CAD file, 2026-11-11]
modules/02_Climate_chamber/CAD/STEP/02-17 Door Window v2.step
164.8 x 4.00 x 134.8 mm
