cryoTUD/optobot/modules/03_Led/CAD/STEP/03-01 LED driver.step

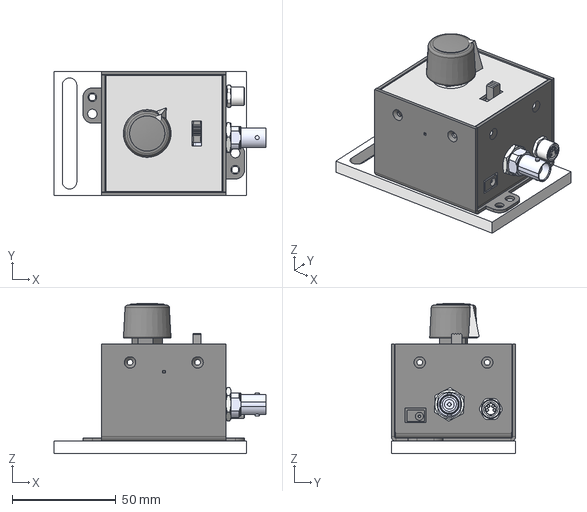
[picture p63: CAD file, 2026-11-11]
modules/03_Led/CAD/STEP/03-01 LED driver.step
102.3 x 60.0 x 72.5 mm
