cryoTUD/optobot/modules/04_Plunger_motor/CAD/STEP/04-12 Din Rail power supply.step

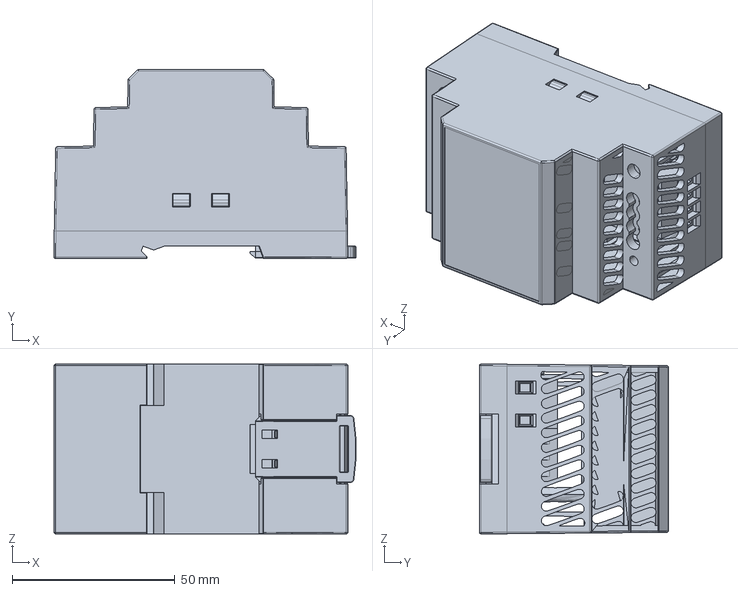
[picture p64: CAD file, 2026-11-11]
modules/04_Plunger_motor/CAD/STEP/04-12 Din Rail power supply.step
92.6 x 58.0 x 52.1 mm
