cryoTUD/optobot/modules/05_Temperature_controlled_cup/CAD/STEP/05-03 Middle cup v2.step

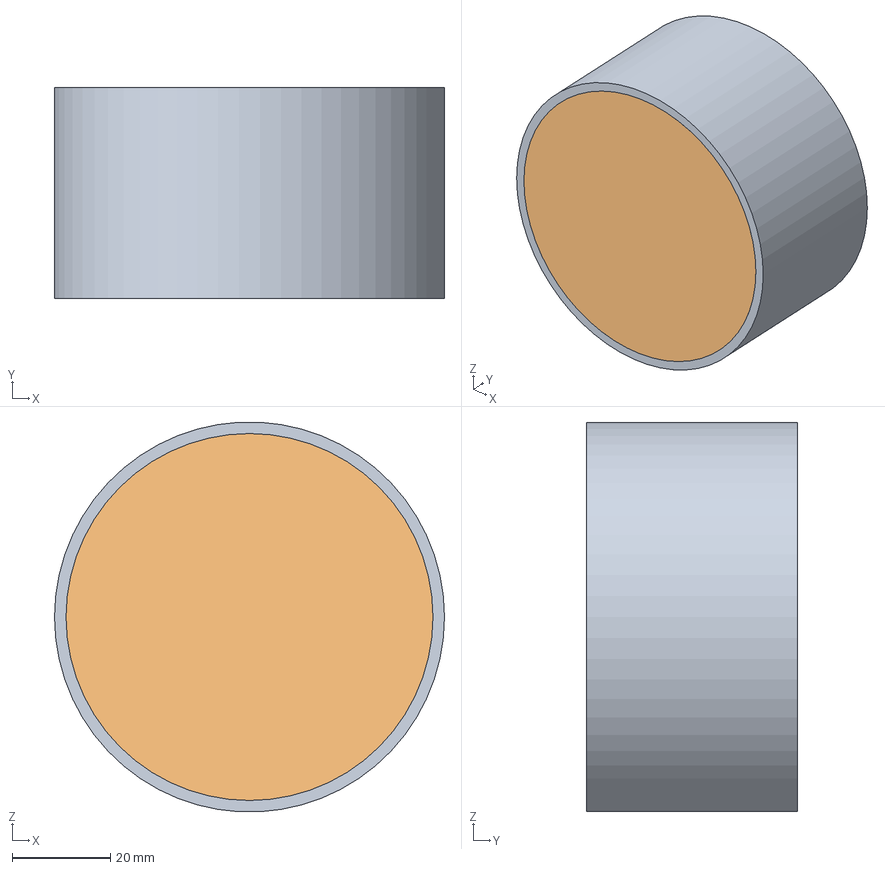
[picture p65: CAD file, 2026-11-11]
modules/05_Temperature_controlled_cup/CAD/STEP/05-03 Middle cup v2.step
79.5 x 43.0 x 79.4 mm
