cryoTUD/optobot/modules/06_Support_structure/CAD/STEP/06-11 Angle Bracket set placeholder.step

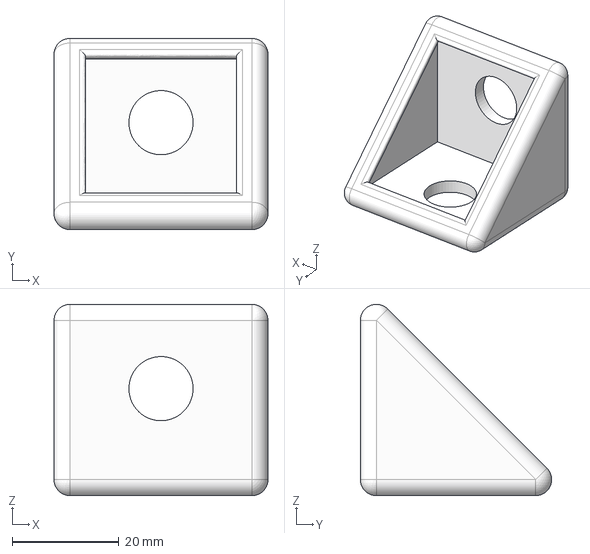
[picture p66: CAD file, 2026-11-11]
modules/06_Support_structure/CAD/STEP/06-11 Angle Bracket set placeholder.step
40.0 x 35.8 x 35.8 mm
