cryoTUD/optobot/modules/00_Electronics/CAD/STEP/00-09 Joystick mount.step

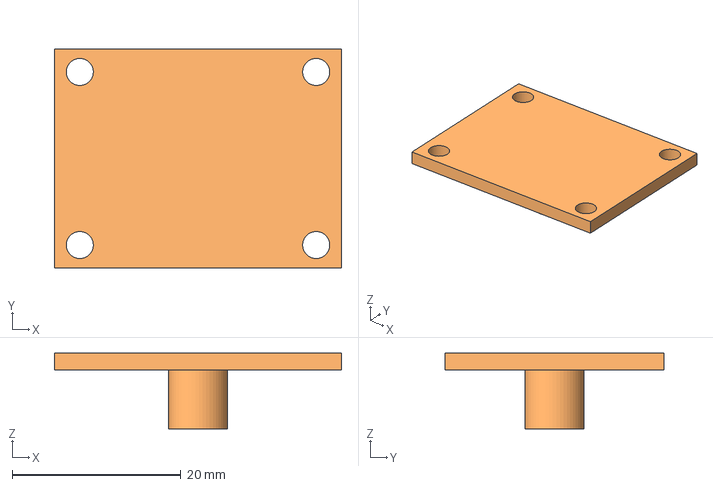
[picture p67: CAD file, 2026-11-11]
modules/00_Electronics/CAD/STEP/00-09 Joystick mount.step
34.0 x 26.0 x 9.00 mm
