cryoTUD/optobot/modules/01_Blotting/CAD/STEP/01-03 Gear rack v2.step

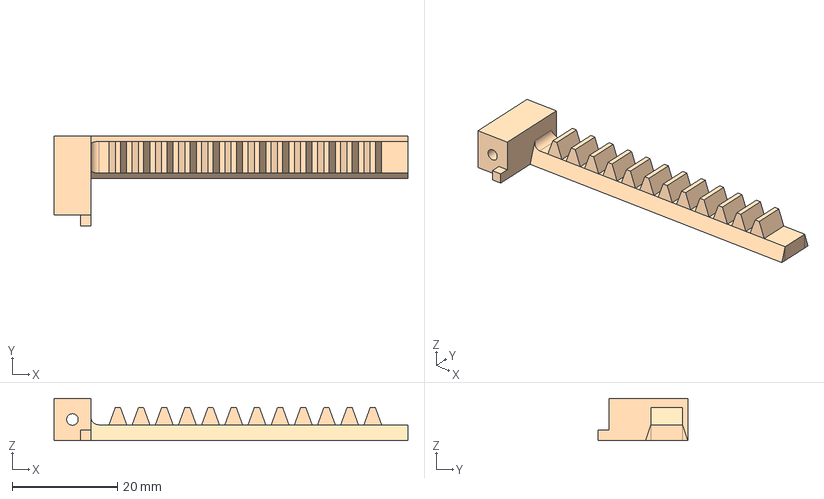
[picture p68: CAD file, 2026-11-11]
modules/01_Blotting/CAD/STEP/01-03 Gear rack v2.step
67.2 x 17.0 x 8.00 mm
