cryoTUD/optobot/modules/02_Climate_chamber/CAD/DXF/02-03 Left Wall.dxf

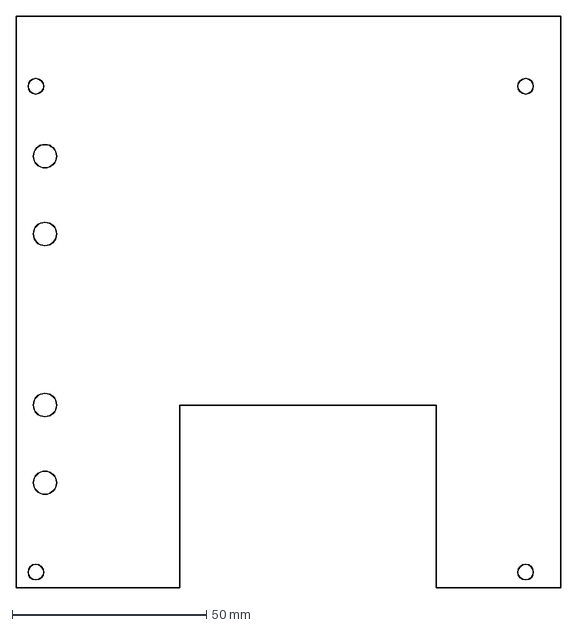
[picture p69: CAD file, 2026-11-11]
modules/02_Climate_chamber/CAD/DXF/02-03 Left Wall.dxf
140.0 x 147.0 mm
