cryoTUD/optobot/modules/02_Climate_chamber/CAD/STEP/02-25 Humidifier chamber top lid v2.step

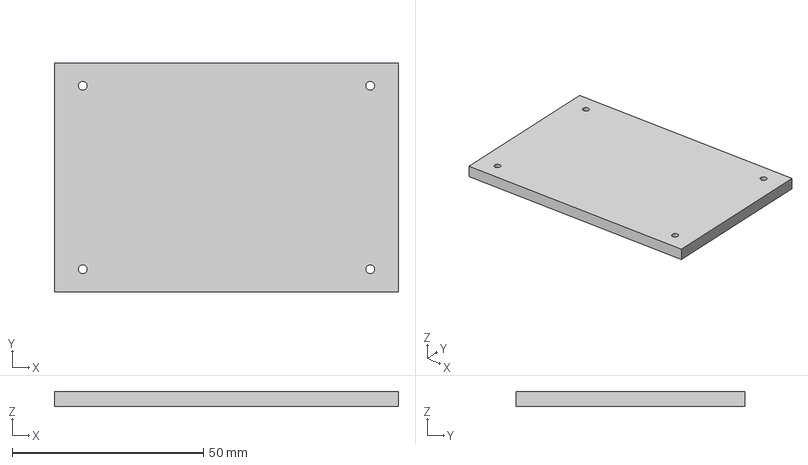
[picture p70: CAD file, 2026-11-11]
modules/02_Climate_chamber/CAD/STEP/02-25 Humidifier chamber top lid v2.step
90.0 x 60.0 x 4.00 mm
