cryoTUD/optobot/modules/03_Led/CAD/STEP/03-12 Long Lens tube.step

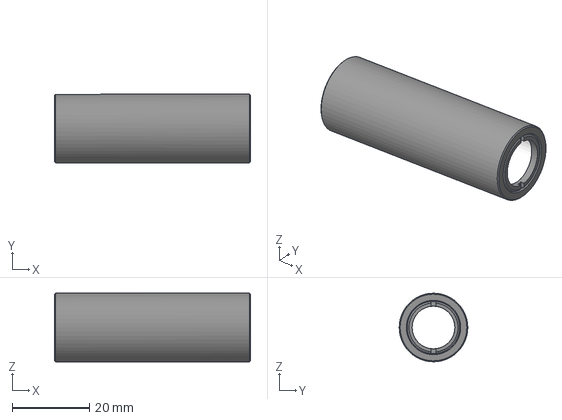
[picture p71: CAD file, 2026-11-11]
modules/03_Led/CAD/STEP/03-12 Long Lens tube.step
50.8 x 17.8 x 17.8 mm
