cryoTUD/optobot/modules/04_Plunger_motor/CAD/STEP/04-08 Motor driver.step

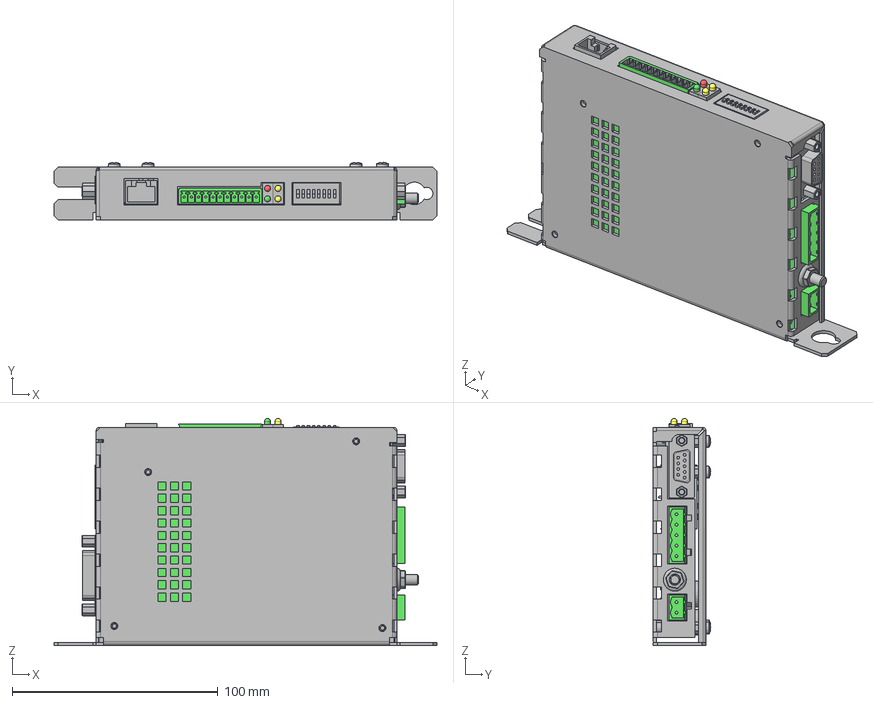
[picture p72: CAD file, 2026-11-11]
modules/04_Plunger_motor/CAD/STEP/04-08 Motor driver.step
186.0 x 27.9 x 110.3 mm
