cryoTUD/optobot/modules/05_Temperature_controlled_cup/CAD/STEP/05-01 Base cup bottom.step

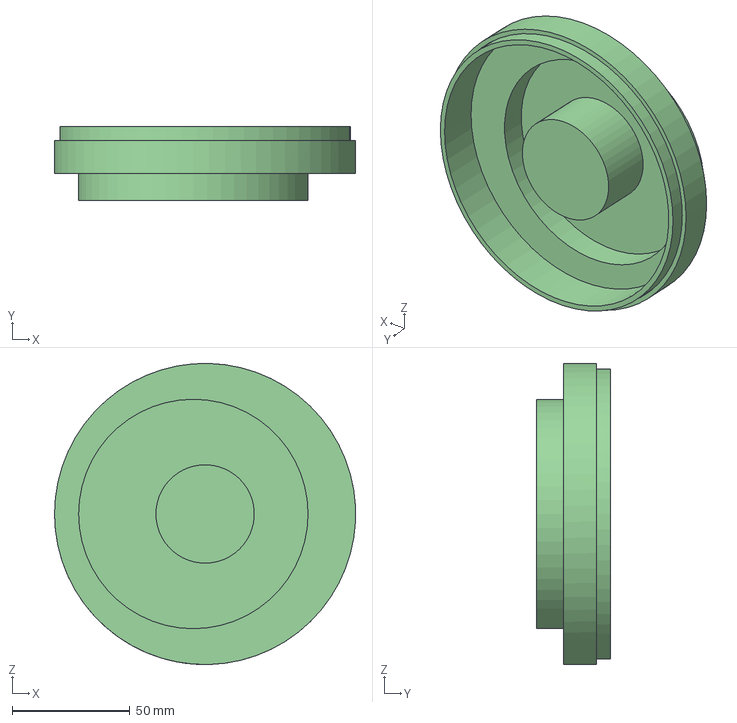
[picture p73: CAD file, 2026-11-11]
modules/05_Temperature_controlled_cup/CAD/STEP/05-01 Base cup bottom.step
127.9 x 31.4 x 128.0 mm
