cryoTUD/optobot/modules/06_Support_structure/CAD/STEP/06-05 Alu Profile 40x40 L225.step

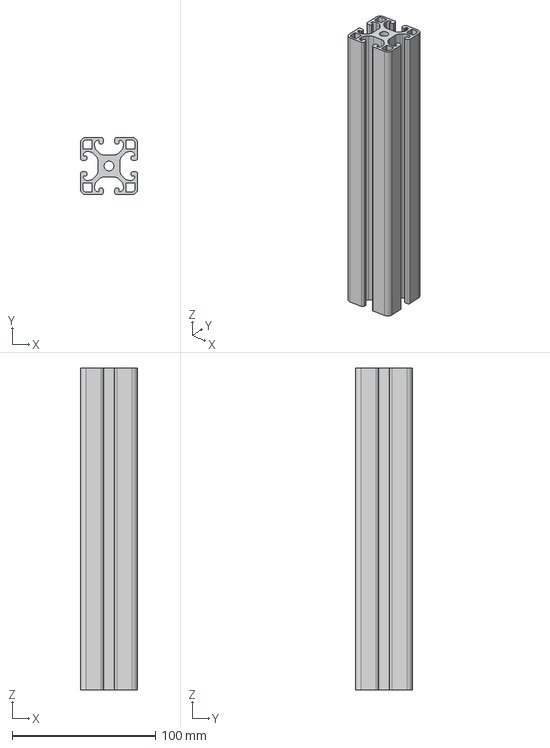
[picture p74: CAD file, 2026-11-11]
modules/06_Support_structure/CAD/STEP/06-05 Alu Profile 40x40 L225.step
40.0 x 40.0 x 225.0 mm
