cryoTUD/optobot/modules/00_Electronics/CAD/STEP/00-06 Board relay Placeholder.step

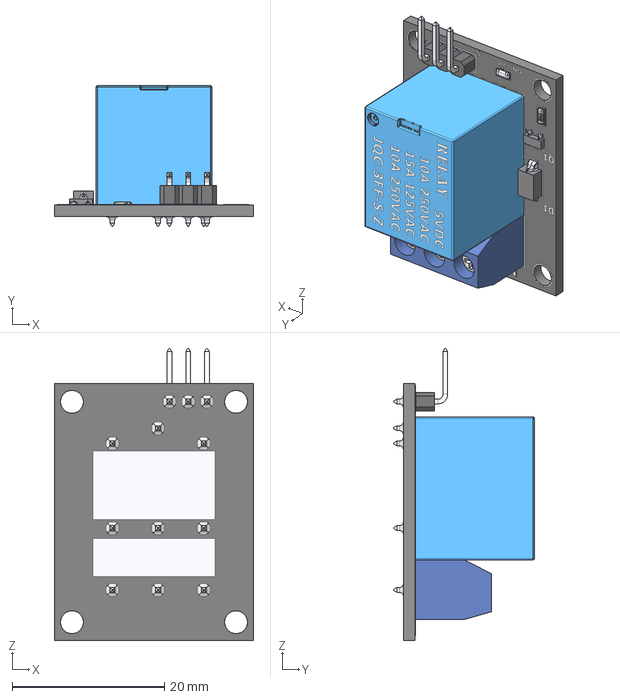
[picture p75: CAD file, 2026-11-11]
modules/00_Electronics/CAD/STEP/00-06 Board relay Placeholder.step
26.1 x 18.5 x 38.3 mm
