cryoTUD/optobot/modules/01_Blotting/CAD/STEP/01-06 Guide block v2.step

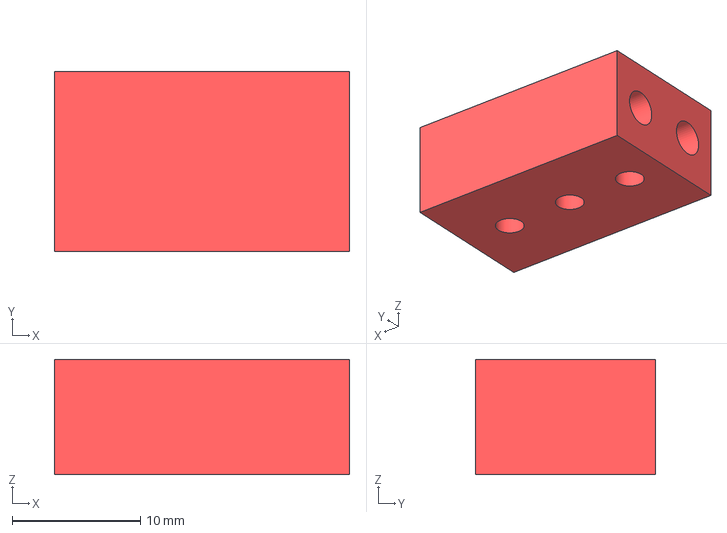
[picture p76: CAD file, 2026-11-11]
modules/01_Blotting/CAD/STEP/01-06 Guide block v2.step
23.0 x 14.0 x 9.00 mm
