cryoTUD/optobot/modules/02_Climate_chamber/CAD/DXF/02-02 Right Wall.dxf

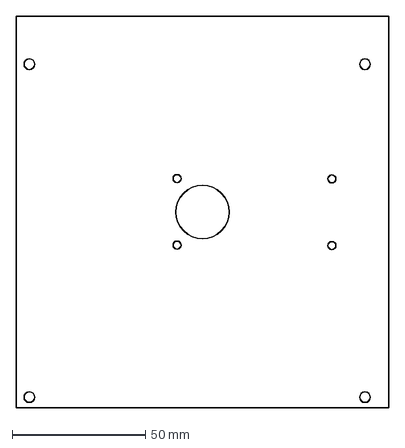
[picture p77: CAD file, 2026-11-11]
modules/02_Climate_chamber/CAD/DXF/02-02 Right Wall.dxf
140.0 x 147.0 mm
