cryoTUD/optobot/modules/02_Climate_chamber/CAD/STEP/02-05 Top Plate v2.step

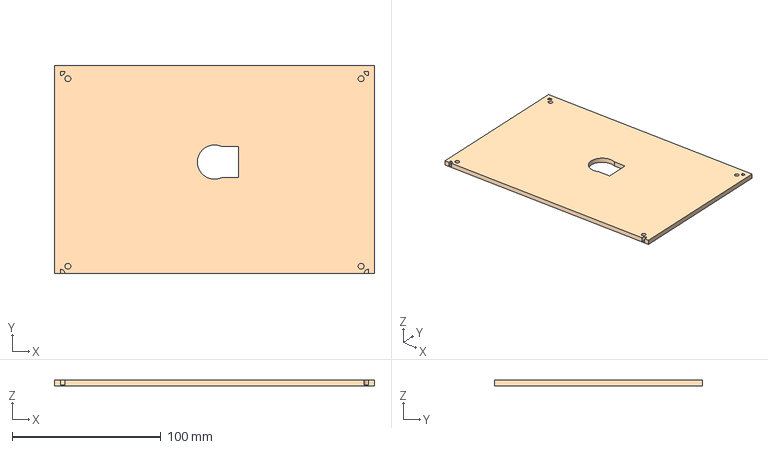
[picture p78: CAD file, 2026-11-11]
modules/02_Climate_chamber/CAD/STEP/02-05 Top Plate v2.step
215.0 x 140.0 x 4.00 mm
