cryoTUD/optobot/modules/03_Led/CAD/STEP/03-10 Lens XY translational stage.step

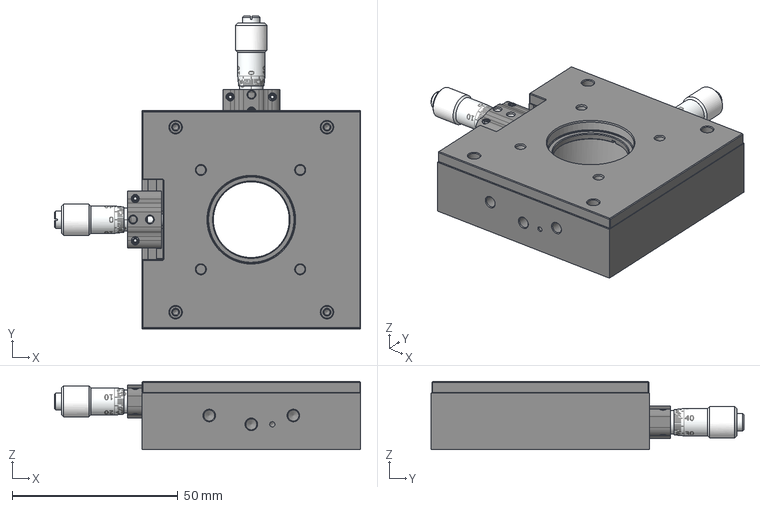
[picture p79: CAD file, 2026-11-11]
modules/03_Led/CAD/STEP/03-10 Lens XY translational stage.step
92.5 x 94.5 x 20.6 mm
