cryoTUD/optobot/modules/04_Plunger_motor/CAD/STEP/04-15 Tweezer snaplock Male v2.step

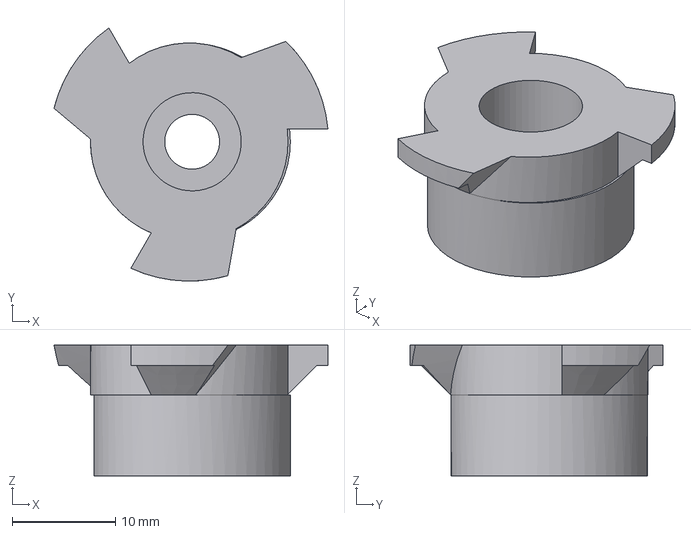
[picture p80: CAD file, 2026-11-11]
modules/04_Plunger_motor/CAD/STEP/04-15 Tweezer snaplock Male v2.step
26.5 x 24.5 x 12.6 mm
