cryoTUD/optobot/modules/05_Temperature_controlled_cup/CAD/STEP/05-08 Thermocouple Placeholder.step

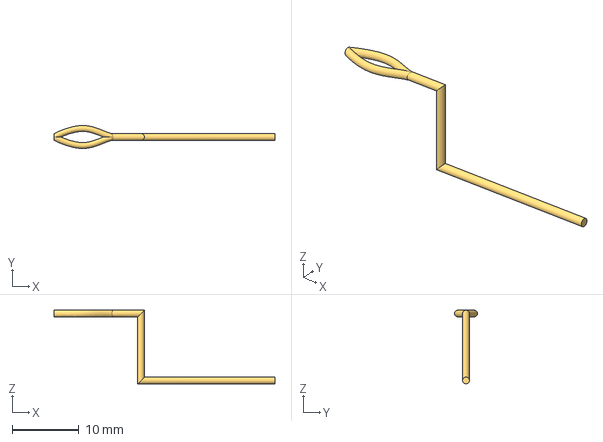
[picture p81: CAD file, 2026-11-11]
modules/05_Temperature_controlled_cup/CAD/STEP/05-08 Thermocouple Placeholder.step
33.0 x 3.43 x 11.0 mm
