cryoTUD/optobot/modules/06_Support_structure/CAD/STEP/06-07 Alu Profile 40x40 L230.step

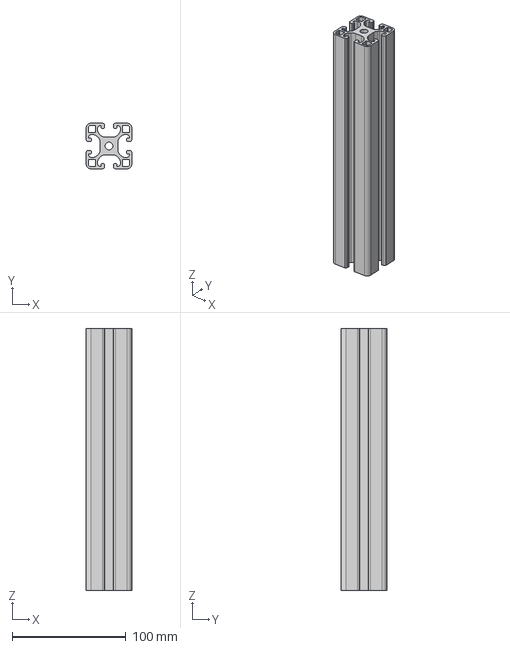
[picture p82: CAD file, 2026-11-11]
modules/06_Support_structure/CAD/STEP/06-07 Alu Profile 40x40 L230.step
40.0 x 40.0 x 230.0 mm
