cryoTUD/optobot/modules/00_Electronics/CAD/STEP/00-08 Joystick Placeholder.step

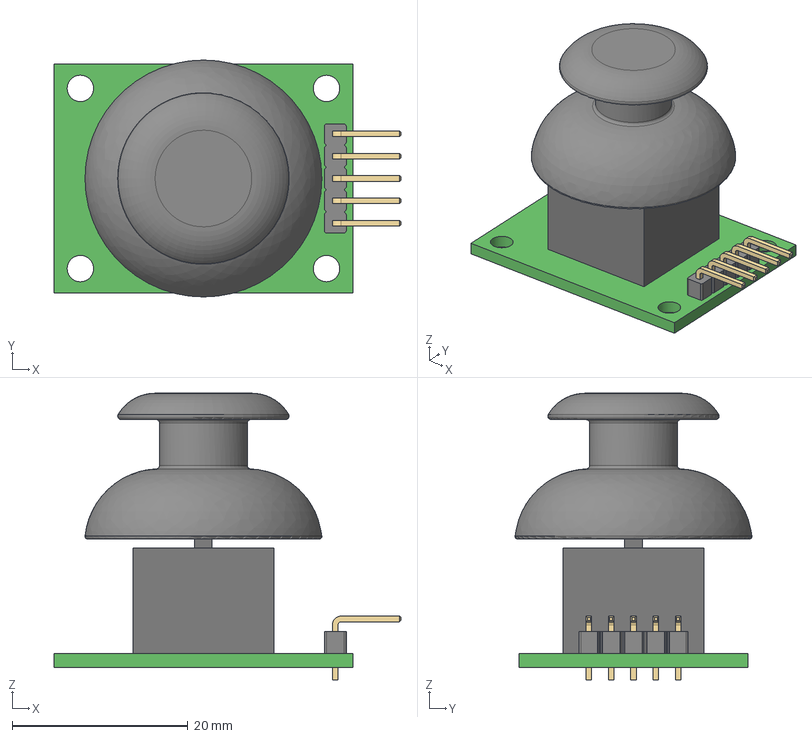
[picture p83: CAD file, 2026-11-11]
modules/00_Electronics/CAD/STEP/00-08 Joystick Placeholder.step
39.5 x 26.9 x 32.6 mm
