cryoTUD/optobot/modules/01_Blotting/CAD/STEP/01-04 Slider connecter v2.step

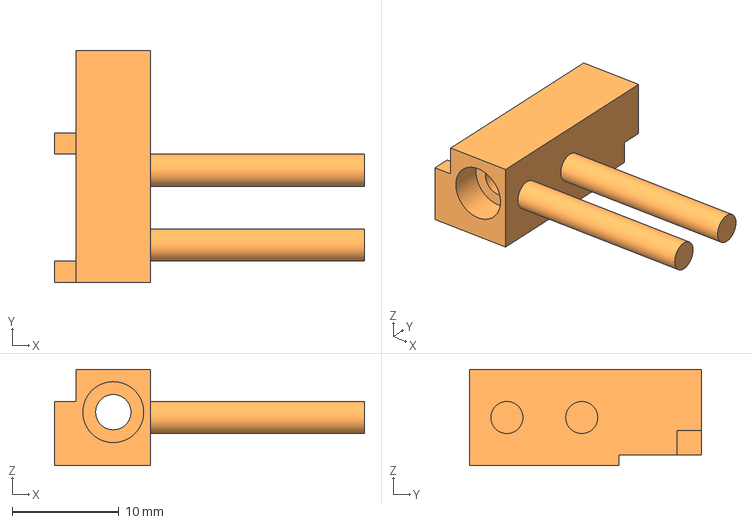
[picture p84: CAD file, 2026-11-11]
modules/01_Blotting/CAD/STEP/01-04 Slider connecter v2.step
29.0 x 21.7 x 9.00 mm
