cryoTUD/optobot/modules/02_Climate_chamber/CAD/DXF/02-25 Humidifier chamber top lid.dxf

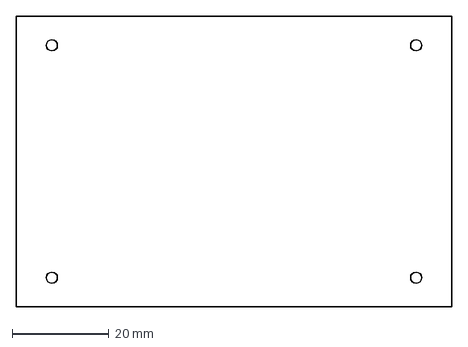
[picture p85: CAD file, 2026-11-11]
modules/02_Climate_chamber/CAD/DXF/02-25 Humidifier chamber top lid.dxf
90.0 x 60.0 mm
