cryoTUD/optobot/modules/02_Climate_chamber/CAD/STEP/02-37 3-way Valve Placeholder.step

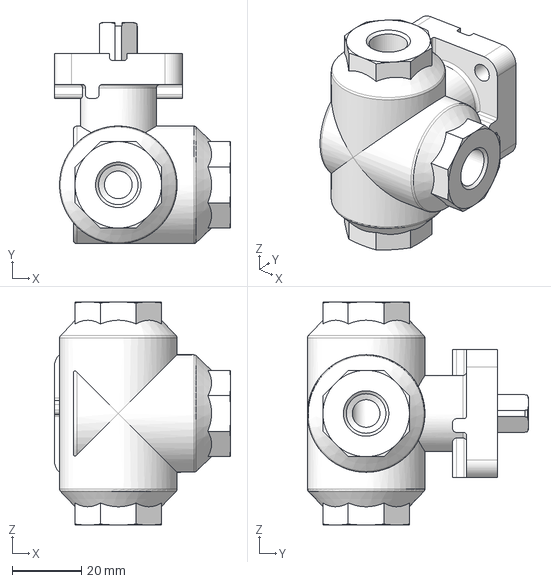
[picture p86: CAD file, 2026-11-11]
modules/02_Climate_chamber/CAD/STEP/02-37 3-way Valve Placeholder.step
51.0 x 64.0 x 64.5 mm
