cryoTUD/optobot/modules/03_Led/CAD/STEP/03-13 Aspheric condensor.step

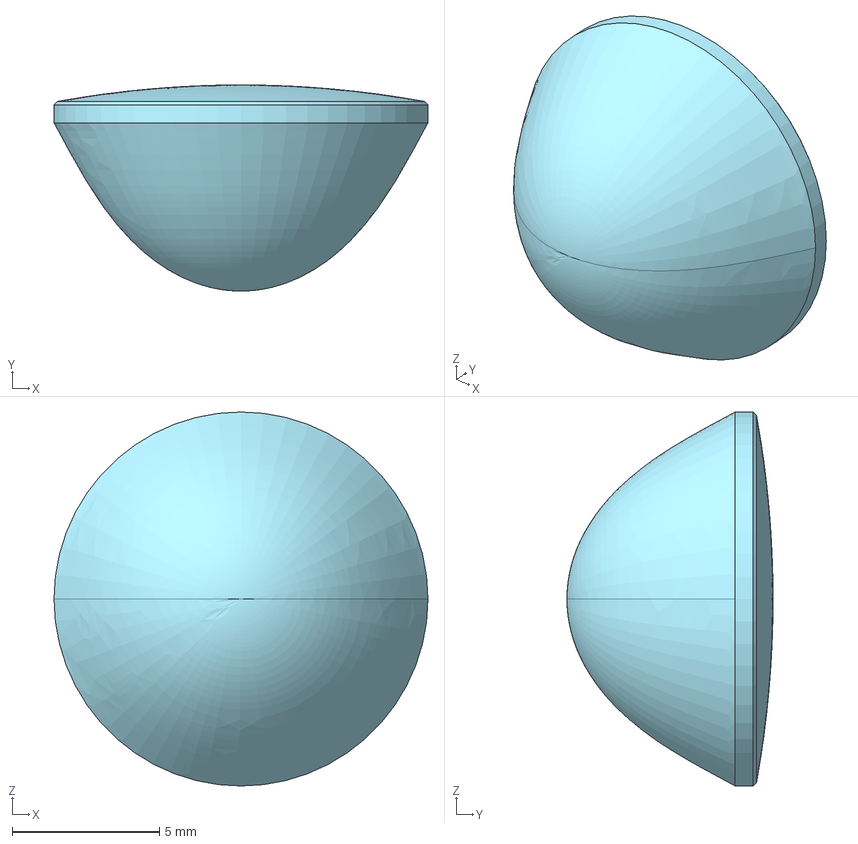
[picture p87: CAD file, 2026-11-11]
modules/03_Led/CAD/STEP/03-13 Aspheric condensor.step
12.7 x 7.00 x 12.7 mm
