cryoTUD/optobot/modules/04_Plunger_motor/CAD/STEP/04-16 Tweezer snaplock Female v1.step

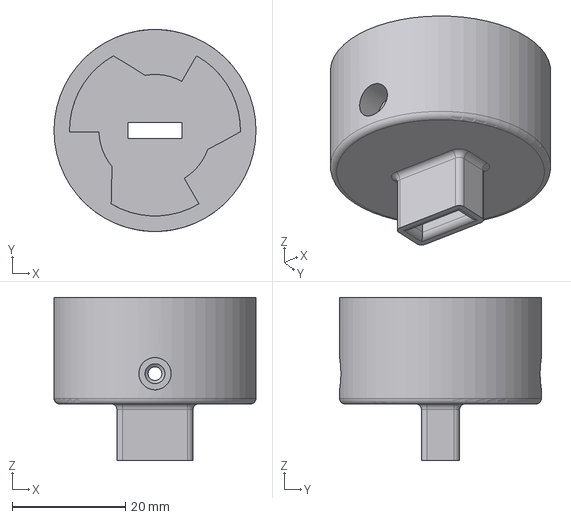
[picture p88: CAD file, 2026-11-11]
modules/04_Plunger_motor/CAD/STEP/04-16 Tweezer snaplock Female v1.step
35.7 x 35.7 x 28.8 mm
