cryoTUD/optobot/modules/05_Temperature_controlled_cup/CAD/STEP/05-05 Brass cup Placeholder.step

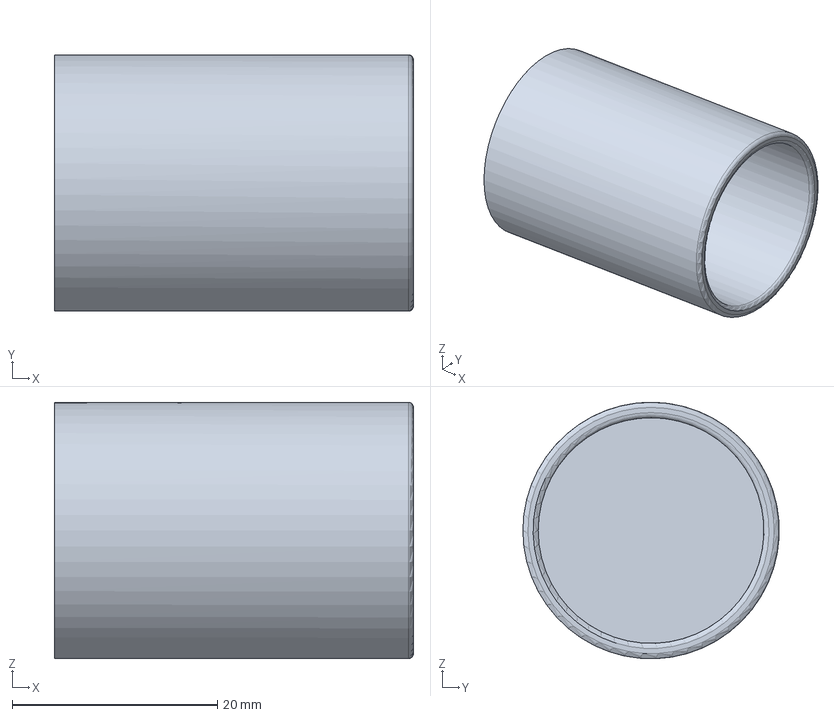
[picture p89: CAD file, 2026-11-11]
modules/05_Temperature_controlled_cup/CAD/STEP/05-05 Brass cup Placeholder.step
35.0 x 25.0 x 25.0 mm
