cryoTUD/optobot/modules/06_Support_structure/CAD/STEP/06-08 Alu Profile 40x40 L235.step

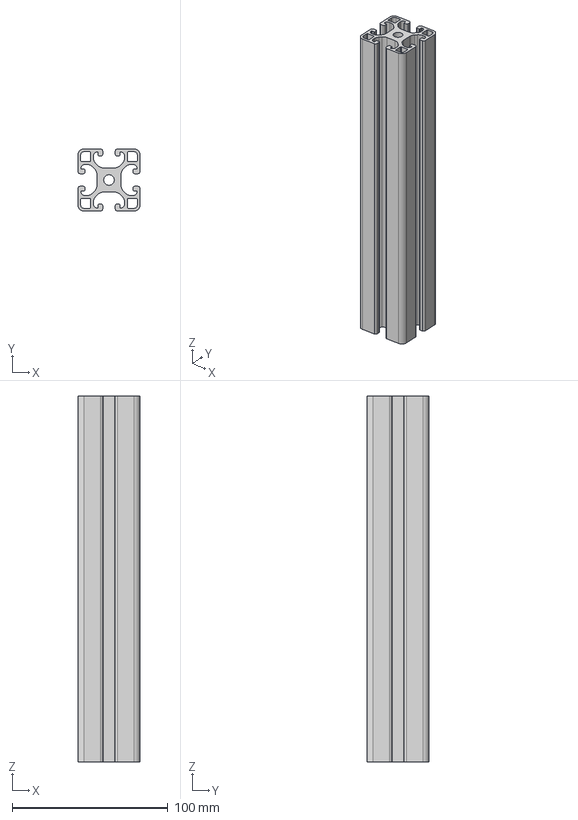
[picture p90: CAD file, 2026-11-11]
modules/06_Support_structure/CAD/STEP/06-08 Alu Profile 40x40 L235.step
40.0 x 40.0 x 235.0 mm
