cryoTUD/optobot/modules/00_Electronics/CAD/STEP/00-11 LCD 20x4 Placeholder.step

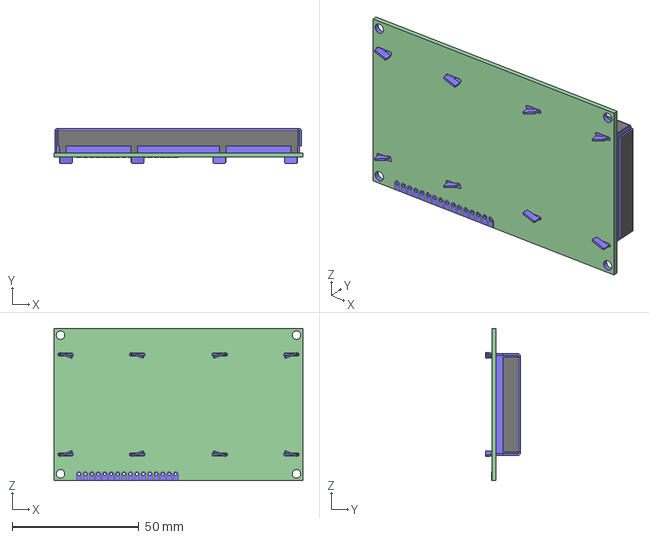
[picture p91: CAD file, 2026-11-11]
modules/00_Electronics/CAD/STEP/00-11 LCD 20x4 Placeholder.step
98.1 x 13.7 x 59.9 mm
