cryoTUD/optobot/modules/02_Climate_chamber/CAD/DXF/02-24 Reservoir Window.dxf

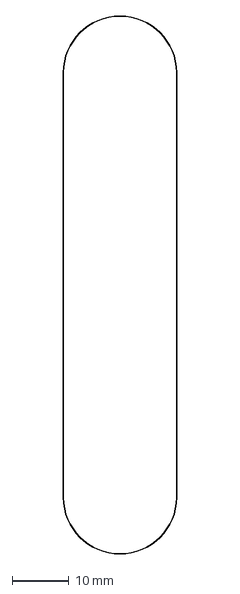
[picture p92: CAD file, 2026-11-11]
modules/02_Climate_chamber/CAD/DXF/02-24 Reservoir Window.dxf
20.0 x 95.0 mm
