cryoTUD/optobot/modules/02_Climate_chamber/CAD/STEP/02-11 Sample Inlet Housing Outside v7.step

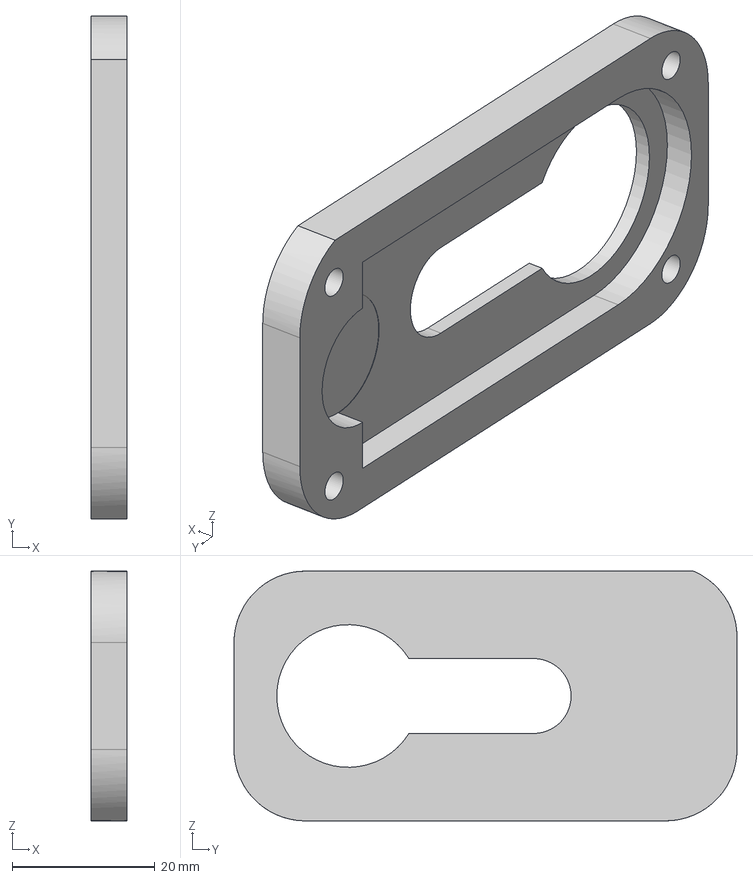
[picture p93: CAD file, 2026-11-11]
modules/02_Climate_chamber/CAD/STEP/02-11 Sample Inlet Housing Outside v7.step
5.00 x 70.5 x 35.0 mm
