cryoTUD/optobot/modules/03_Led/CAD/STEP/03-06 UV Fiber-Couled LED.step

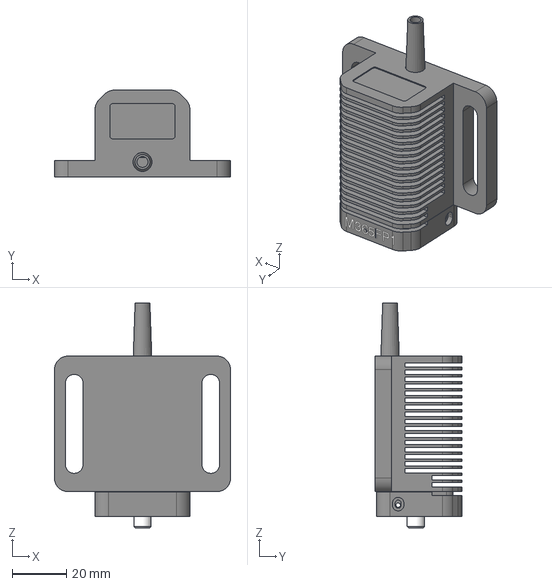
[picture p94: CAD file, 2026-11-11]
modules/03_Led/CAD/STEP/03-06 UV Fiber-Couled LED.step
65.0 x 32.0 x 83.0 mm
