cryoTUD/optobot/modules/04_Plunger_motor/CAD/STEP/04-18 Lift motor coupling.step

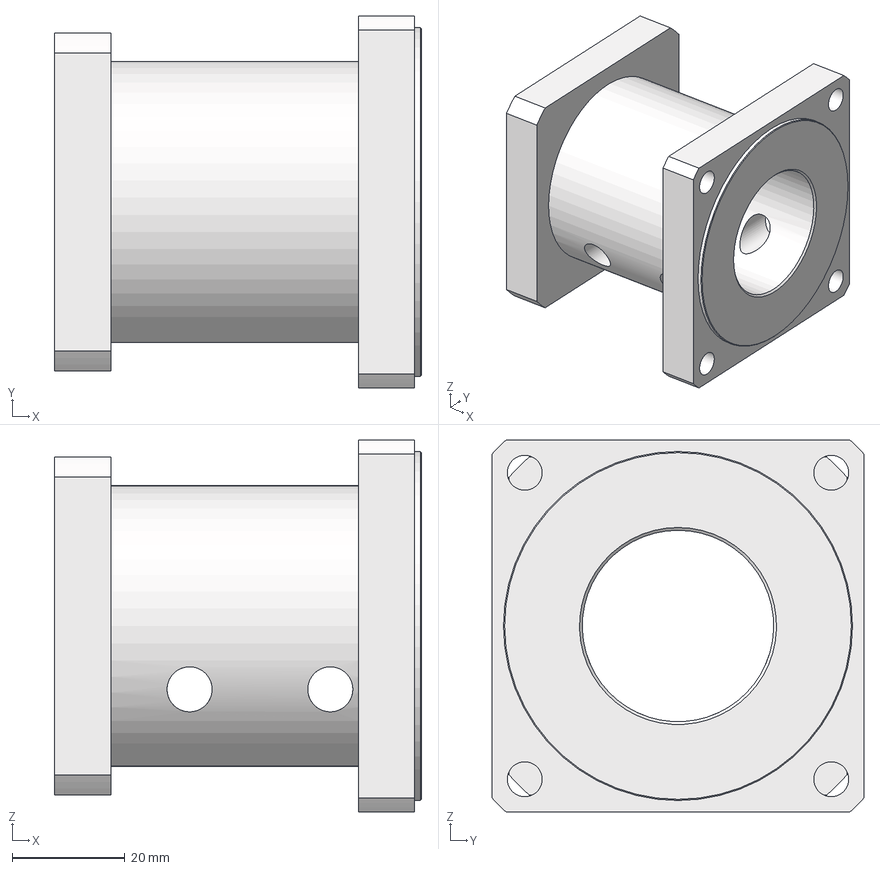
[picture p95: CAD file, 2026-11-11]
modules/04_Plunger_motor/CAD/STEP/04-18 Lift motor coupling.step
65.2 x 66.0 x 66.0 mm
