cryoTUD/optobot/modules/05_Temperature_controlled_cup/CAD/STEP/05-04 Holder Ethane cup & Sample v1.step

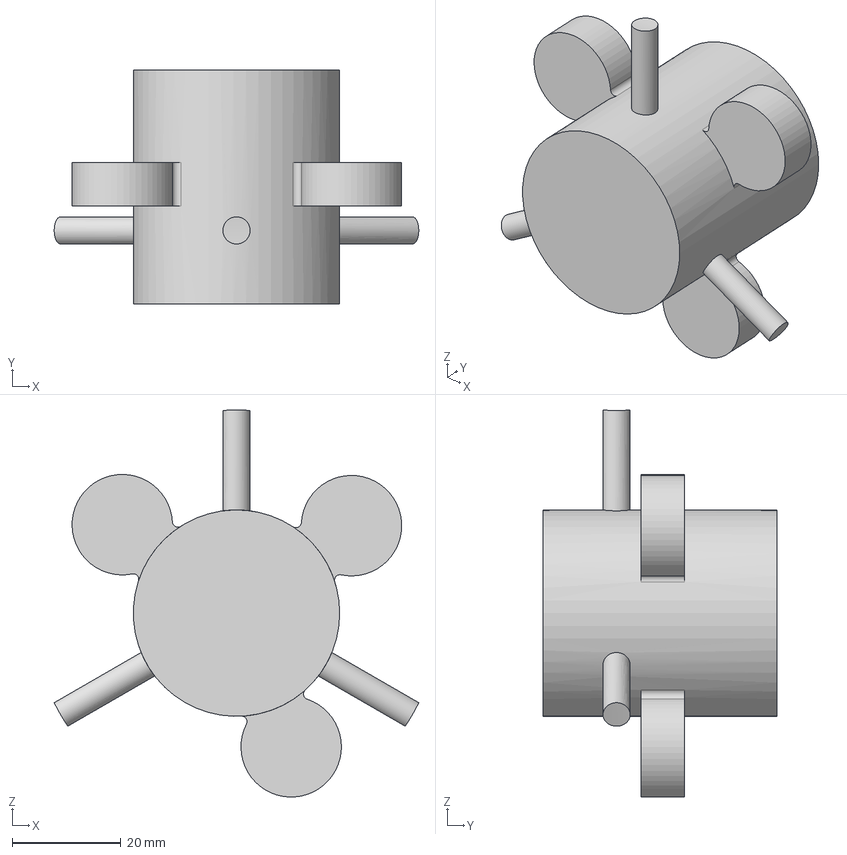
[picture p96: CAD file, 2026-11-11]
modules/05_Temperature_controlled_cup/CAD/STEP/05-04 Holder Ethane cup & Sample v1.step
67.1 x 43.0 x 71.3 mm
