cryoTUD/optobot/modules/06_Support_structure/CAD/STEP/06-03 Alu Profile 40x40 L700.step

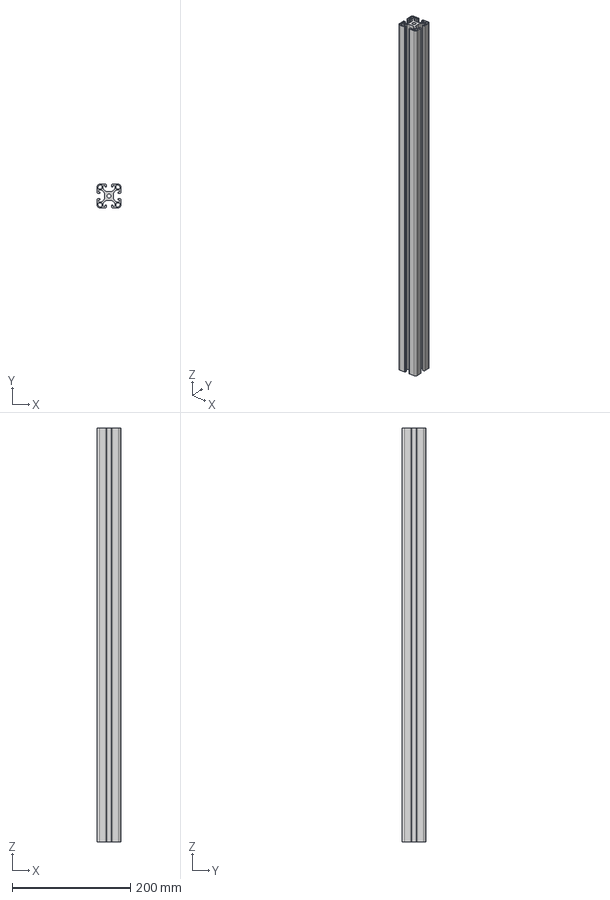
[picture p97: CAD file, 2026-11-11]
modules/06_Support_structure/CAD/STEP/06-03 Alu Profile 40x40 L700.step
40.0 x 40.0 x 700.0 mm
