cryoTUD/optobot/modules/00_Electronics/CAD/STEP/00-03 PID Box top v2.step

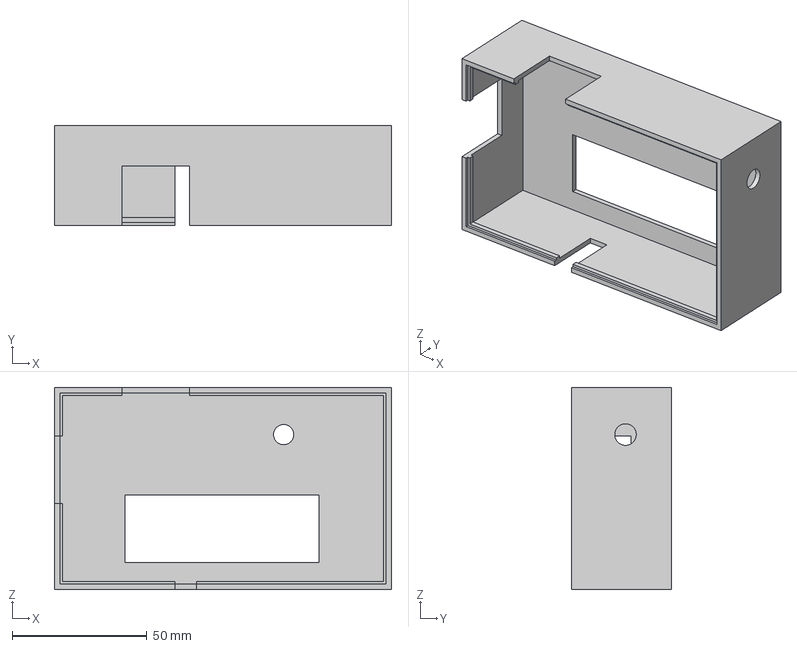
[picture p98: CAD file, 2026-11-11]
modules/00_Electronics/CAD/STEP/00-03 PID Box top v2.step
125.0 x 37.0 x 75.0 mm
