cryoTUD/optobot/modules/02_Climate_chamber/CAD/DXF/Back Wall.dxf

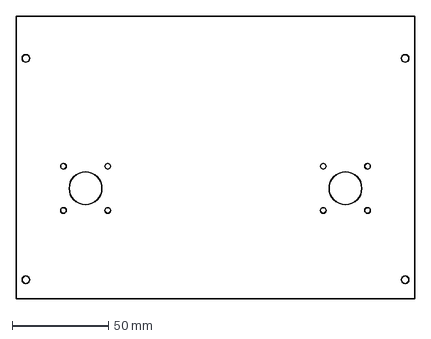
[picture p99: CAD file, 2026-11-11]
modules/02_Climate_chamber/CAD/DXF/Back Wall.dxf
207.0 x 147.0 mm
