cryoTUD/optobot/modules/02_Climate_chamber/CAD/STEP/02-23 Reservoir v2.step

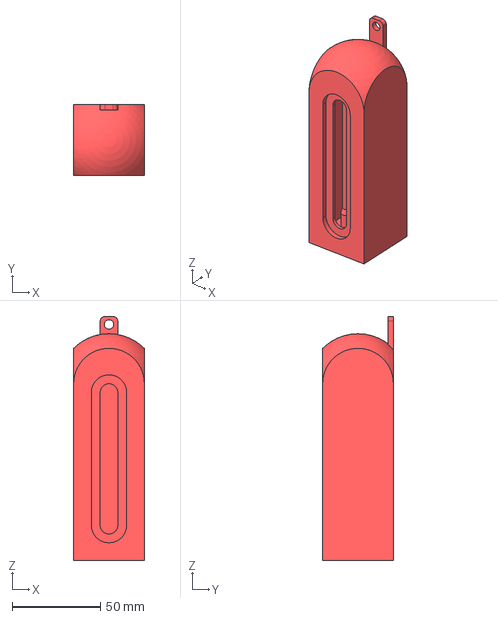
[picture p100: CAD file, 2026-11-11]
modules/02_Climate_chamber/CAD/STEP/02-23 Reservoir v2.step
40.0 x 40.0 x 138.0 mm
