cryoTUD/optobot/modules/03_Led/CAD/STEP/03-11 Locating pin.step

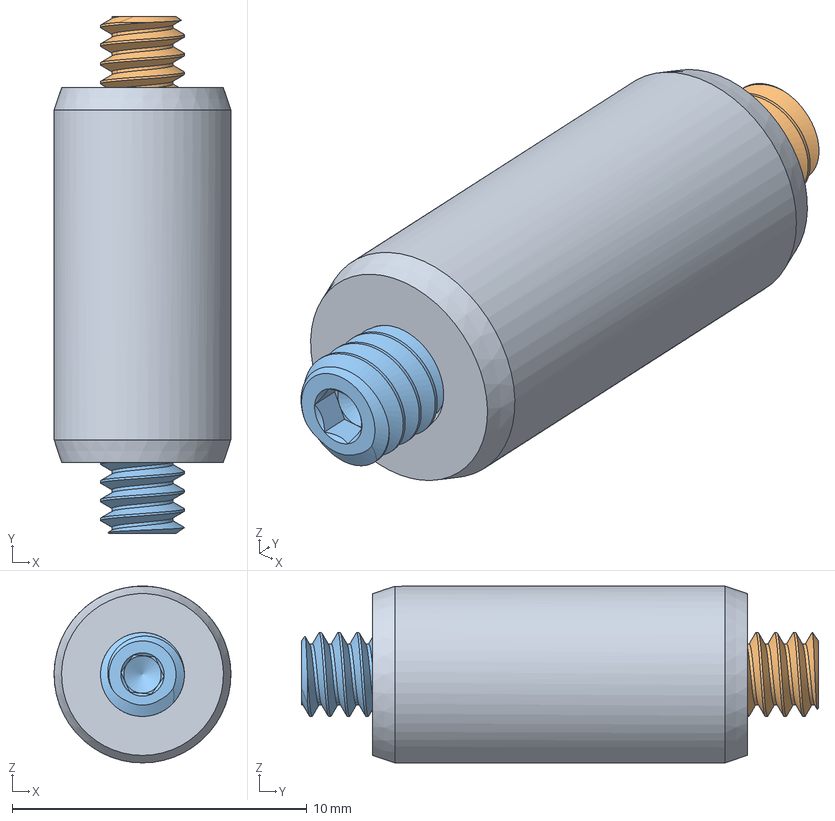
[picture p101: CAD file, 2026-11-11]
modules/03_Led/CAD/STEP/03-11 Locating pin.step
5.99 x 17.5 x 5.99 mm
