cryoTUD/optobot/modules/04_Plunger_motor/CAD/STEP/04-09 Motor power supply.step

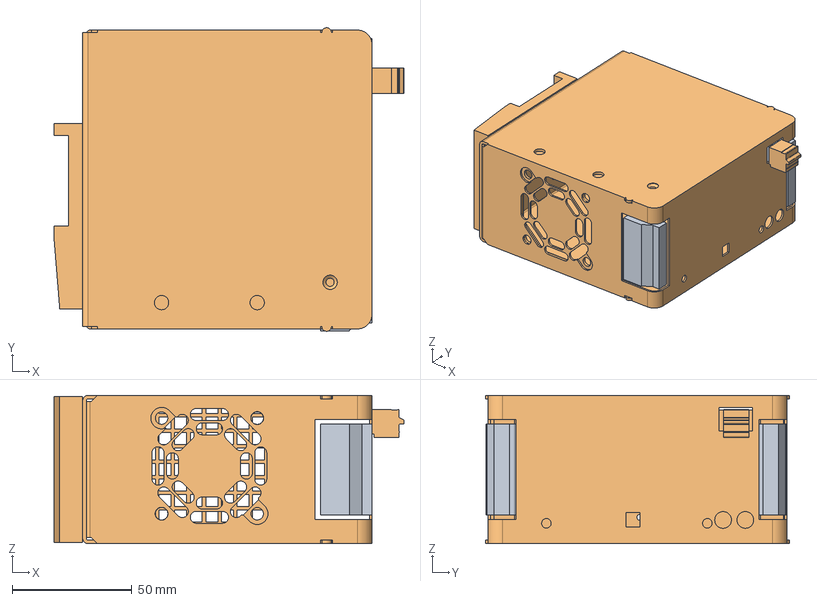
[picture p102: CAD file, 2026-11-11]
modules/04_Plunger_motor/CAD/STEP/04-09 Motor power supply.step
146.4 x 127.0 x 62.0 mm
