cryoTUD/optobot/modules/06_Support_structure/CAD/STEP/06-06 Alu Profile 40x40 L145.step

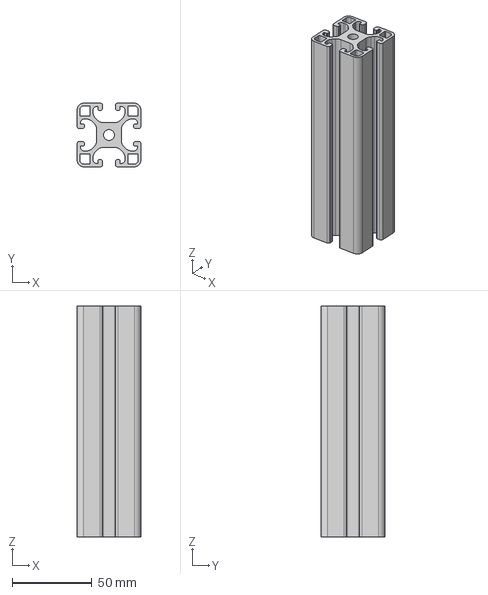
[picture p103: CAD file, 2026-11-11]
modules/06_Support_structure/CAD/STEP/06-06 Alu Profile 40x40 L145.step
40.0 x 40.0 x 145.0 mm
