cryoTUD/optobot/modules/02_Climate_chamber/CAD/STEP/02-15 Roof Beam X v2.step

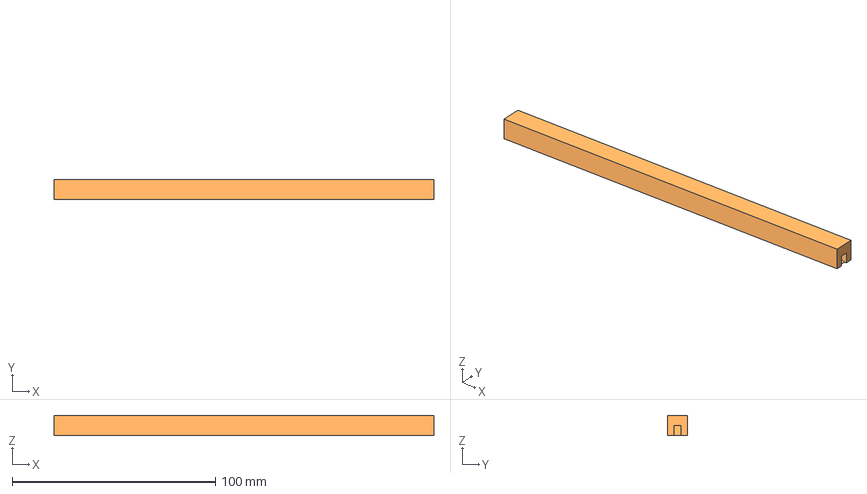
[picture p104: CAD file, 2026-11-11]
modules/02_Climate_chamber/CAD/STEP/02-15 Roof Beam X v2.step
187.0 x 10.0 x 10.0 mm
