cryoTUD/optobot/modules/03_Led/CAD/STEP/03-14 Convex Lens.step

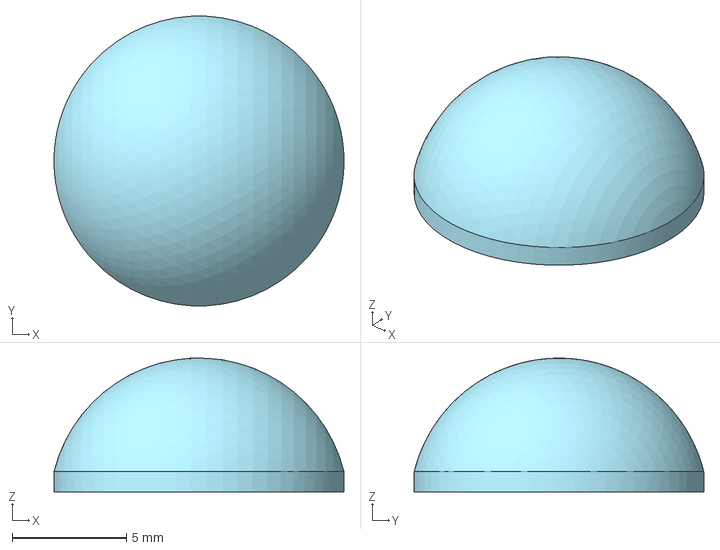
[picture p105: CAD file, 2026-11-11]
modules/03_Led/CAD/STEP/03-14 Convex Lens.step
12.7 x 12.7 x 5.86 mm
