cryoTUD/optobot/modules/06_Support_structure/CAD/STEP/06-04 Alu Profile 40x40 L460.step

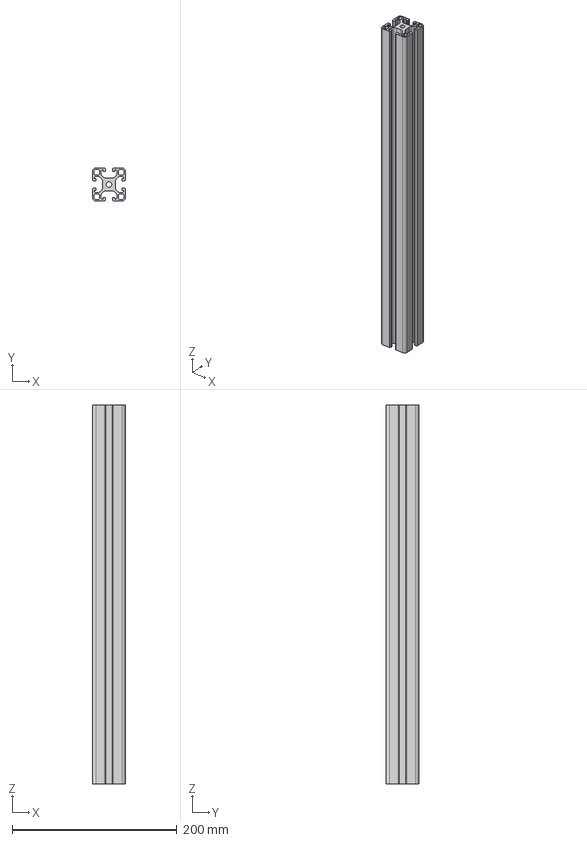
[picture p107: CAD file, 2026-11-11]
modules/06_Support_structure/CAD/STEP/06-04 Alu Profile 40x40 L460.step
40.0 x 40.0 x 460.0 mm
