cryoTUD/optobot/modules/00_Electronics/CAD/STEP/00-04 PID Box bottom v4.step

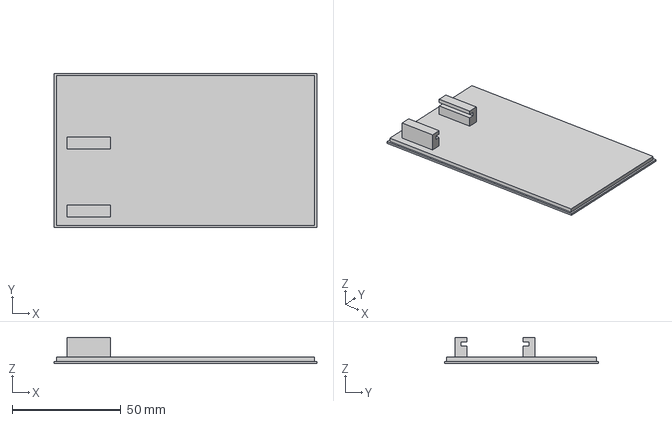
[picture p108: CAD file, 2026-11-11]
modules/00_Electronics/CAD/STEP/00-04 PID Box bottom v4.step
121.0 x 71.0 x 12.0 mm
