cryoTUD/optobot/modules/02_Climate_chamber/CAD/STEP/02-06 Door Lid v2.step

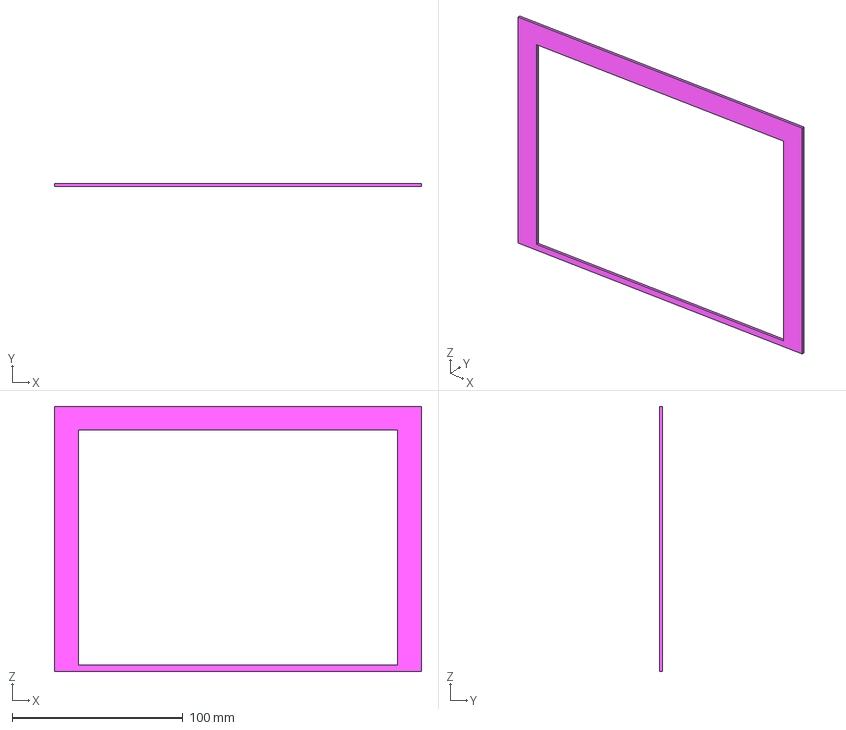
[picture p109: CAD file, 2026-11-11]
modules/02_Climate_chamber/CAD/STEP/02-06 Door Lid v2.step
215.0 x 1.65 x 155.5 mm
