cryoTUD/optobot/modules/04_Plunger_motor/CAD/STEP/04-05 Lift linear unit.step

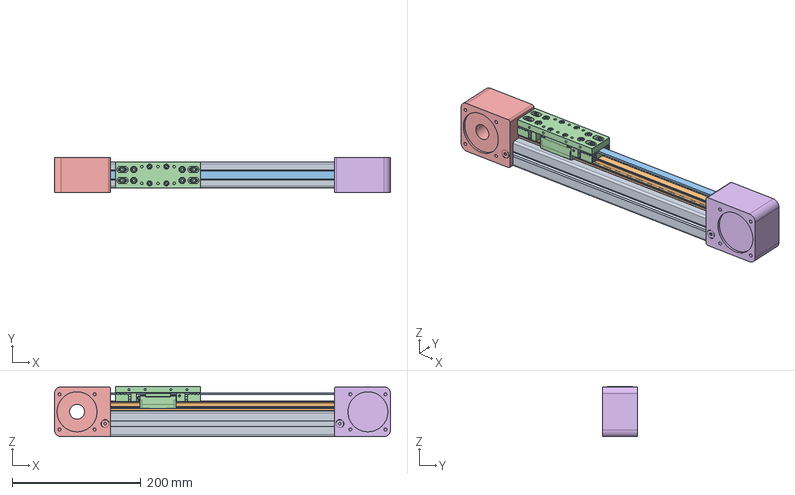
[picture p110: CAD file, 2026-11-11]
modules/04_Plunger_motor/CAD/STEP/04-05 Lift linear unit.step
521.0 x 54.0 x 78.0 mm
MTJ ECO 40 Profile
MTJ ECO 40 Rail
MTJ ECO 40 Belt
MTJ ECO 40 Carriage Short
MTJ ECO 40 Drive Block
MTJ ECO 40 End Block
