cryoTUD/optobot/modules/06_Support_structure/CAD/STEP/06-08 Alu Profile 80x40 L470.step

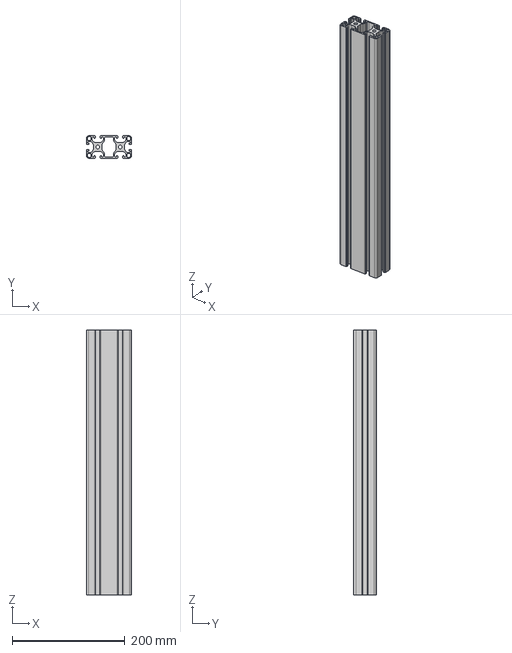
[picture p111: CAD file, 2026-11-11]
modules/06_Support_structure/CAD/STEP/06-08 Alu Profile 80x40 L470.step
80.0 x 40.0 x 470.0 mm
