cryoTUD/optobot/modules/00_Electronics/CAD/STEP/00-12 LDC 16x2 Placeholder.step

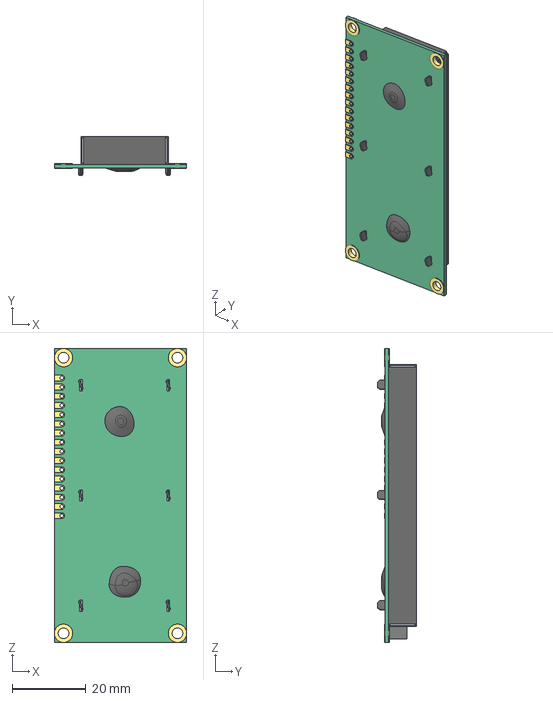
[picture p112: CAD file, 2026-11-11]
modules/00_Electronics/CAD/STEP/00-12 LDC 16x2 Placeholder.step
36.0 x 10.5 x 80.0 mm
