cryoTUD/optobot/modules/02_Climate_chamber/CAD/STEP/02-08.3 Door Hinge Pin.step

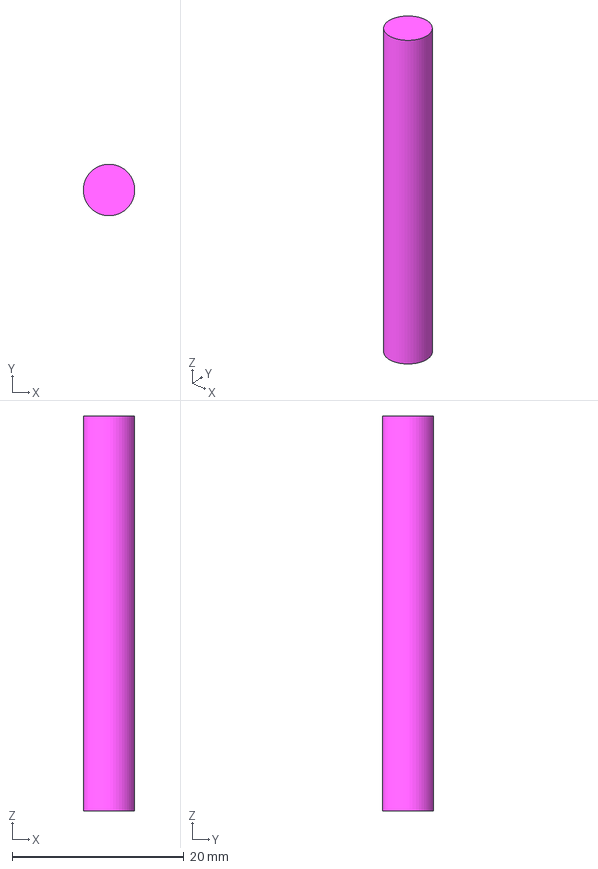
[picture p113: CAD file, 2026-11-11]
modules/02_Climate_chamber/CAD/STEP/02-08.3 Door Hinge Pin.step
5.99 x 6.00 x 46.0 mm
