cryoTUD/optobot/modules/00_Electronics/CAD/STEP/00-20 Arduino Nano Placeholder.step

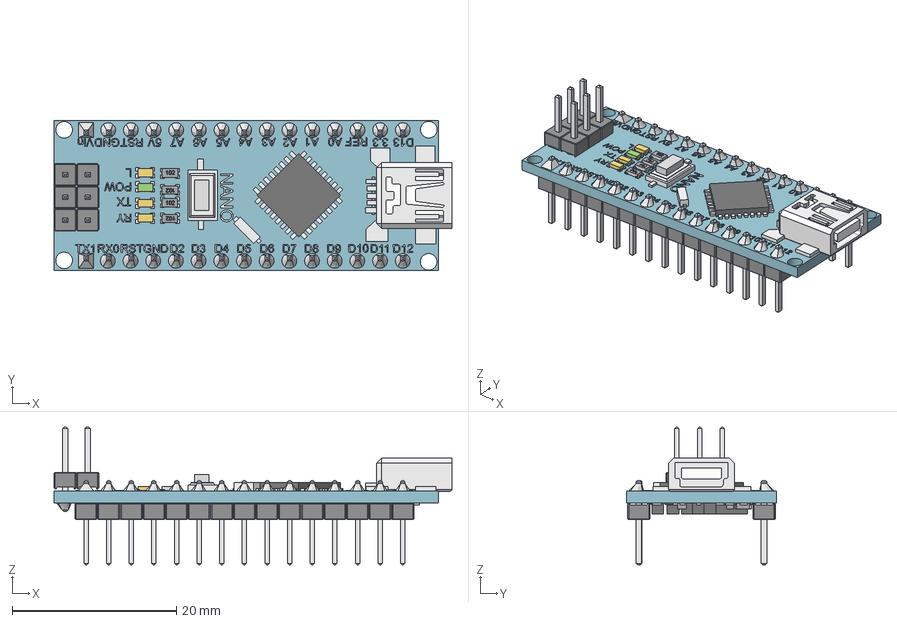
[picture p115: CAD file, 2026-11-11]
modules/00_Electronics/CAD/STEP/00-20 Arduino Nano Placeholder.step
48.4 x 18.2 x 16.7 mm
