cryoTUD/optobot/modules/04_Plunger_motor/CAD/STEP/04-01 Plunger Connection Flange.step

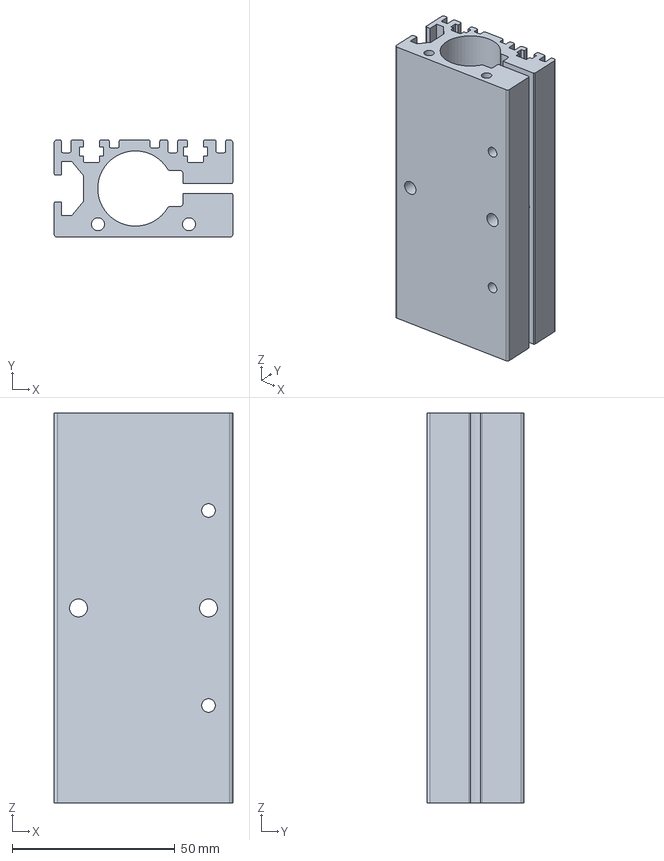
[picture p116: CAD file, 2026-11-11]
modules/04_Plunger_motor/CAD/STEP/04-01 Plunger Connection Flange.step
55.0 x 30.0 x 120.0 mm
