cryoTUD/optobot/modules/00_Electronics/CAD/STEP/00-02 Control Box Top.step

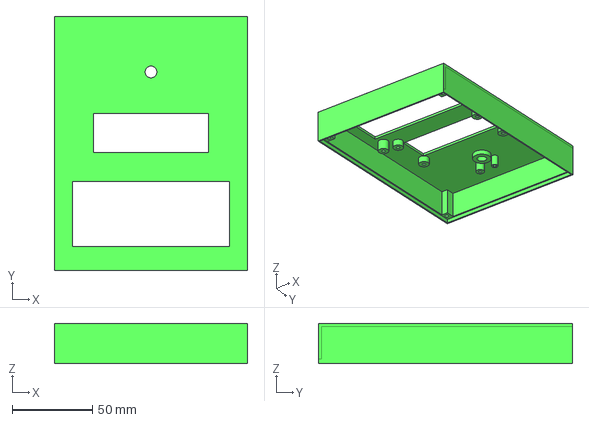
[picture p117: CAD file, 2026-11-11]
modules/00_Electronics/CAD/STEP/00-02 Control Box Top.step
120.0 x 158.0 x 25.0 mm
