cryoTUD/optobot/modules/02_Climate_chamber/CAD/STEP/02-20 Chamber divider horizontal v2.step

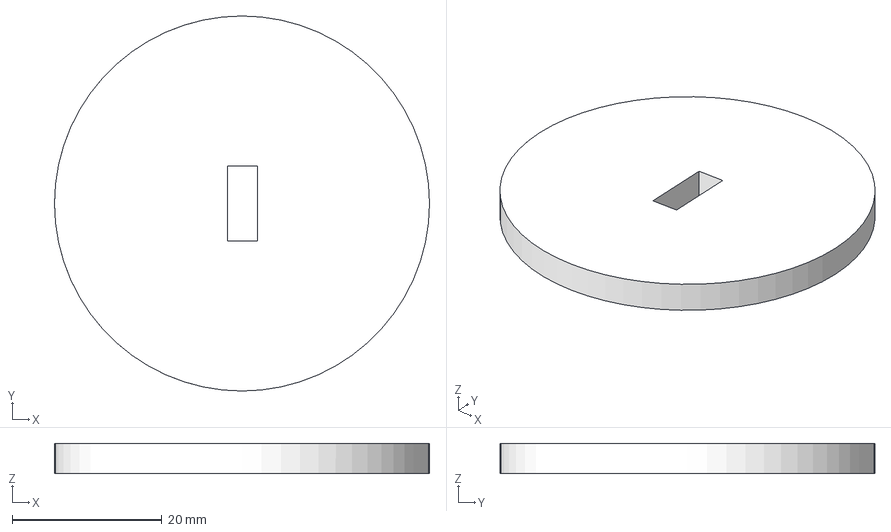
[picture p118: CAD file, 2026-11-11]
modules/02_Climate_chamber/CAD/STEP/02-20 Chamber divider horizontal v2.step
50.0 x 50.0 x 4.01 mm
