cryoTUD/optobot/modules/04_Plunger_motor/CAD/STEP/04-17 12mm Circlip Placeholder.step

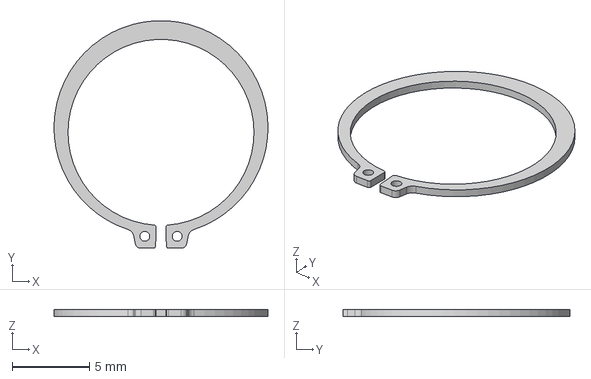
[picture p119: CAD file, 2026-11-11]
modules/04_Plunger_motor/CAD/STEP/04-17 12mm Circlip Placeholder.step
13.8 x 14.7 x 0.458 mm
