cryoTUD/optobot/modules/00_Electronics/CAD/STEP/00-27 Perfboard Arduino Nano support Placeholder.step

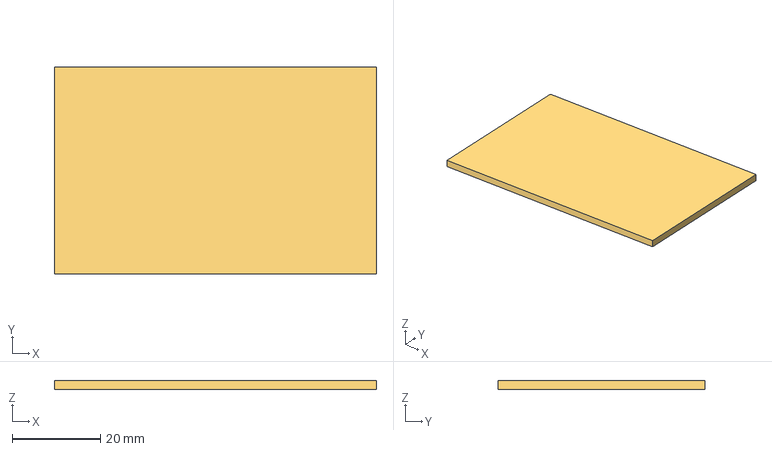
[picture p120: CAD file, 2026-11-11]
modules/00_Electronics/CAD/STEP/00-27 Perfboard Arduino Nano support Placeholder.step
73.0 x 47.0 x 2.00 mm
