cryoTUD/optobot/modules/02_Climate_chamber/CAD/STEP/02-14 Shutter Plate v6.step

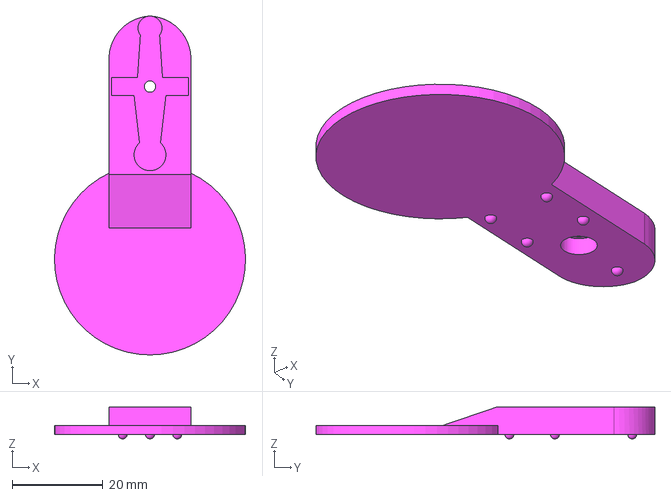
[picture p121: CAD file, 2026-11-11]
modules/02_Climate_chamber/CAD/STEP/02-14 Shutter Plate v6.step
42.0 x 74.5 x 7.00 mm
