cryoTUD/optobot/modules/04_Plunger_motor/CAD/STEP/04-06 Lift Servo motor.step

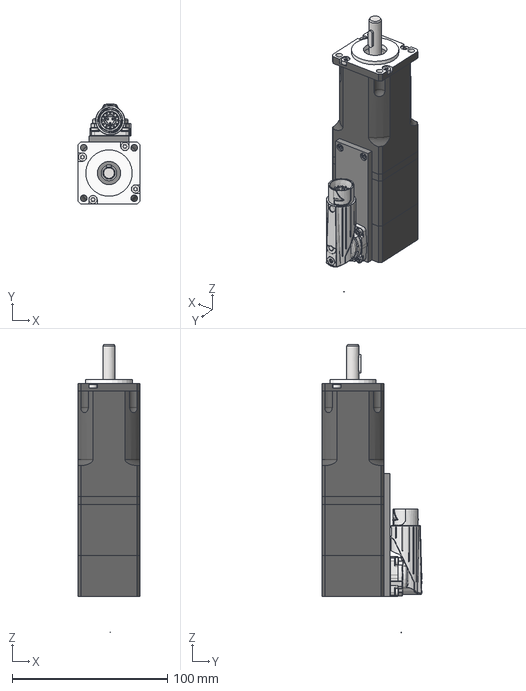
[picture p122: CAD file, 2026-11-11]
modules/04_Plunger_motor/CAD/STEP/04-06 Lift Servo motor.step
40.0 x 64.6 x 185.7 mm
EC02h-40!140-B
Stecker_EC02
