cryoTUD/optobot/modules/00_Electronics/CAD/STEP/00-05 Arduino Mega Placeholder.step

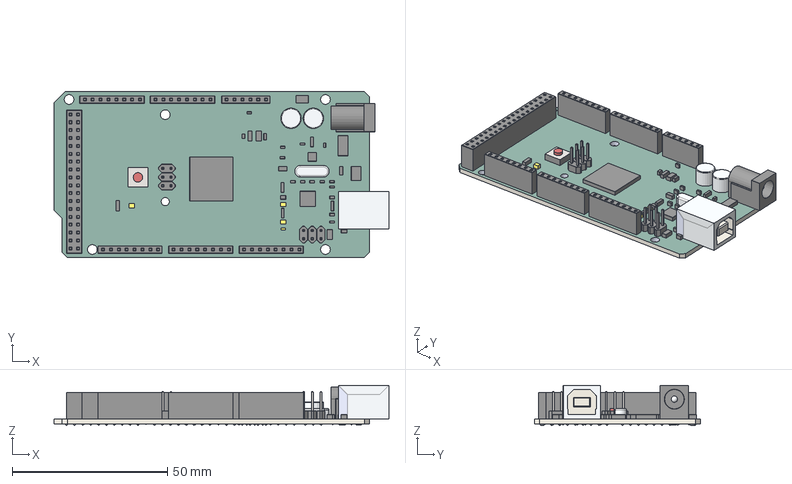
[picture p123: CAD file, 2026-11-11]
modules/00_Electronics/CAD/STEP/00-05 Arduino Mega Placeholder.step
107.9 x 53.4 x 13.0 mm
