cryoTUD/optobot/modules/02_Climate_chamber/CAD/STEP/02-26 Humidifier Placeholder.step

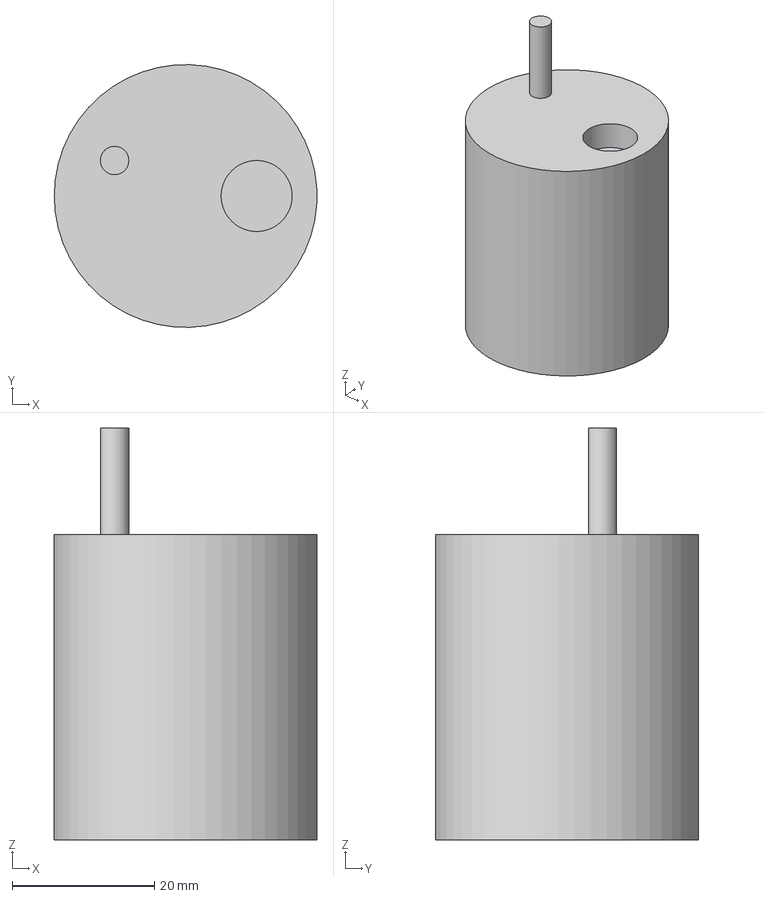
[picture p124: CAD file, 2026-11-11]
modules/02_Climate_chamber/CAD/STEP/02-26 Humidifier Placeholder.step
37.0 x 37.0 x 58.0 mm
