cryoTUD/optobot/modules/00_Electronics/CAD/STEP/00-07 Max 232 Board Placeholder.step

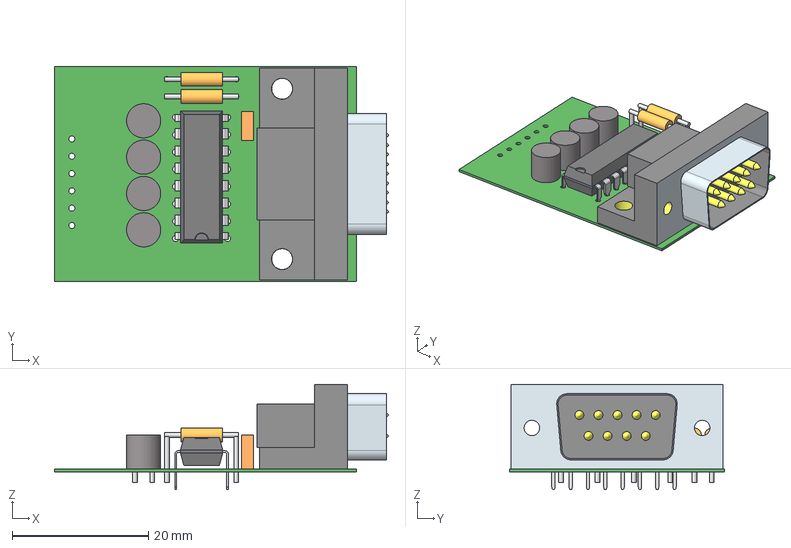
[picture p125: CAD file, 2026-11-11]
modules/00_Electronics/CAD/STEP/00-07 Max 232 Board Placeholder.step
49.0 x 31.6 x 15.4 mm
