cryoTUD/optobot/modules/02_Climate_chamber/CAD/STEP/02-02 Right Wall v4.step

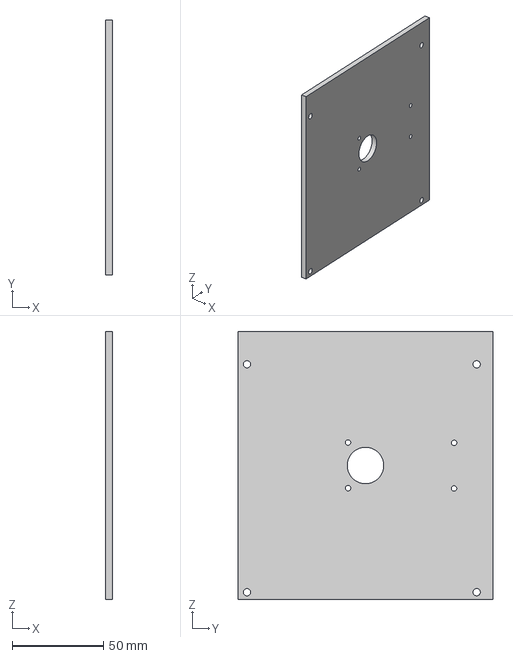
[picture p126: CAD file, 2026-11-11]
modules/02_Climate_chamber/CAD/STEP/02-02 Right Wall v4.step
4.00 x 140.0 x 147.0 mm
