cryoTUD/optobot/modules/00_Electronics/CAD/STEP/00-23 Rotary Encoder Placeholder.step

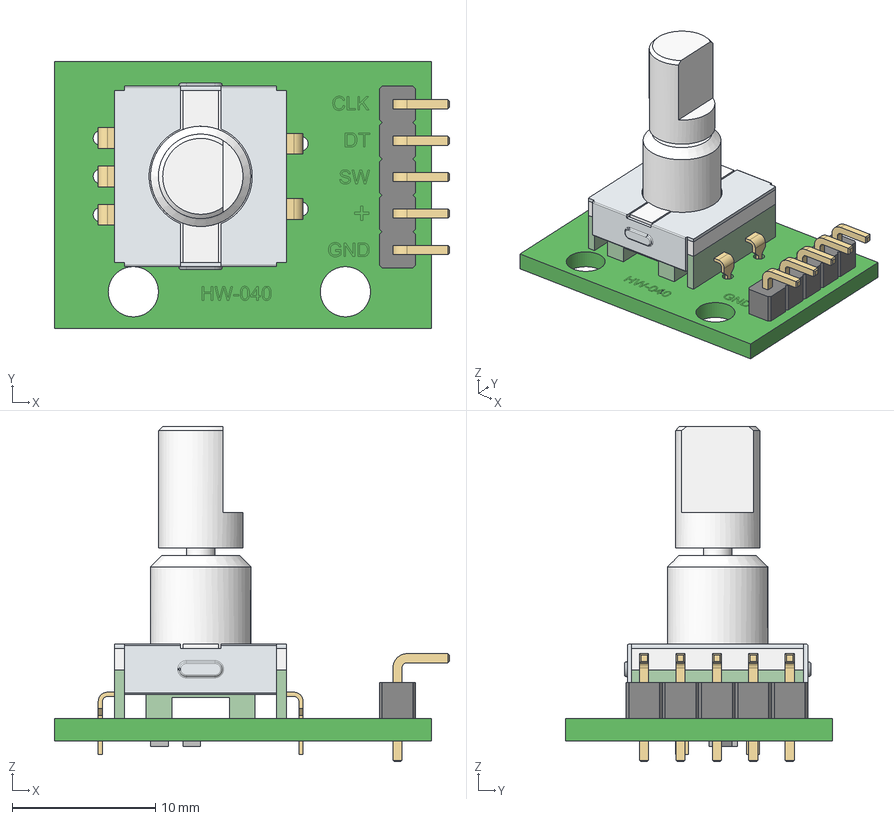
[picture p127: CAD file, 2026-11-11]
modules/00_Electronics/CAD/STEP/00-23 Rotary Encoder Placeholder.step
27.6 x 18.6 x 23.4 mm
