cryoTUD/optobot/modules/02_Climate_chamber/CAD/STEP/02-04 Back Wall v2.step

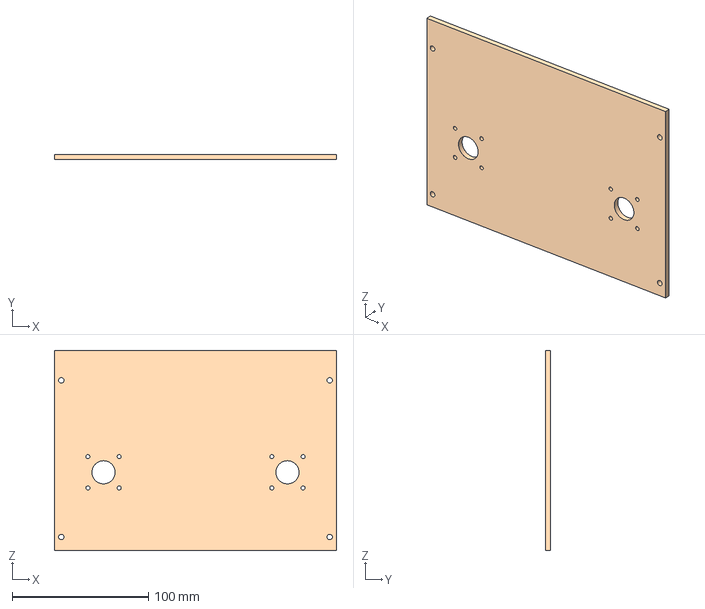
[picture p128: CAD file, 2026-11-11]
modules/02_Climate_chamber/CAD/STEP/02-04 Back Wall v2.step
207.0 x 4.00 x 147.0 mm
