cryoTUD/optobot/modules/00_Electronics/CAD/STEP/00-16 Mounting rail Placeholder.step

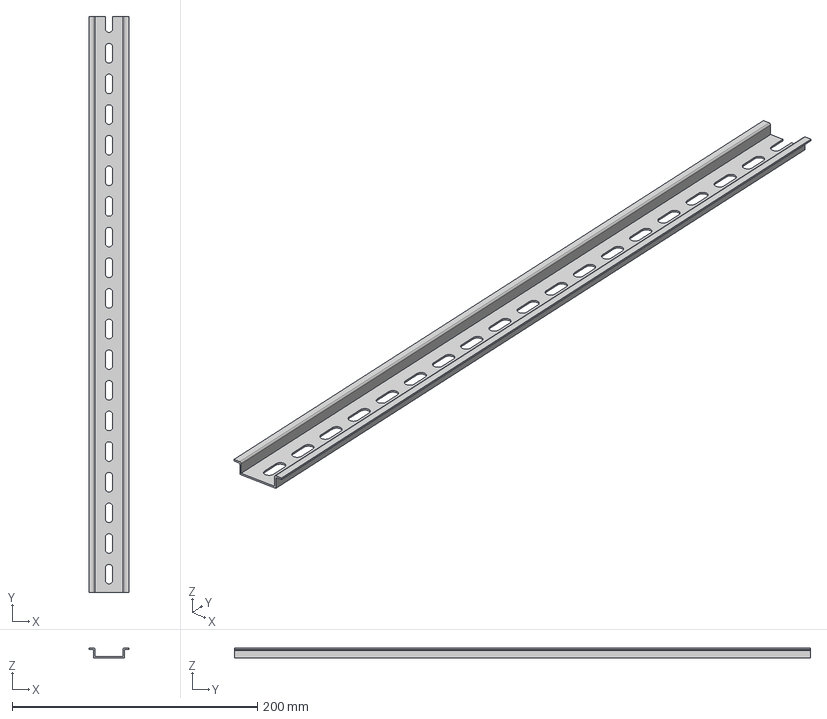
[picture p129: CAD file, 2026-11-11]
modules/00_Electronics/CAD/STEP/00-16 Mounting rail Placeholder.step
33.0 x 470.0 x 8.00 mm
