cryoTUD/optobot/modules/02_Climate_chamber/CAD/STEP/02-38 Valve lever.step

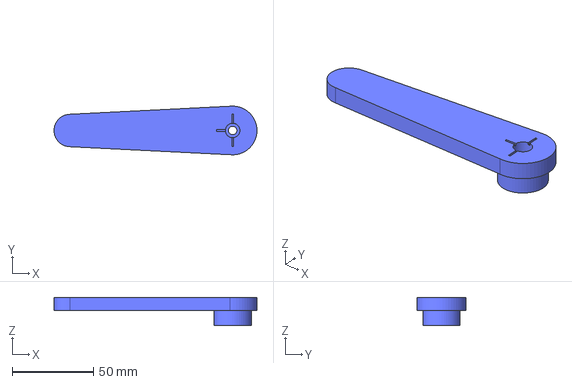
[picture p130: CAD file, 2026-11-11]
modules/02_Climate_chamber/CAD/STEP/02-38 Valve lever.step
125.0 x 30.0 x 17.5 mm
