cryoTUD/optobot/modules/00_Electronics/CAD/STEP/00-21 Thermocouple amplifier Placeholder.step

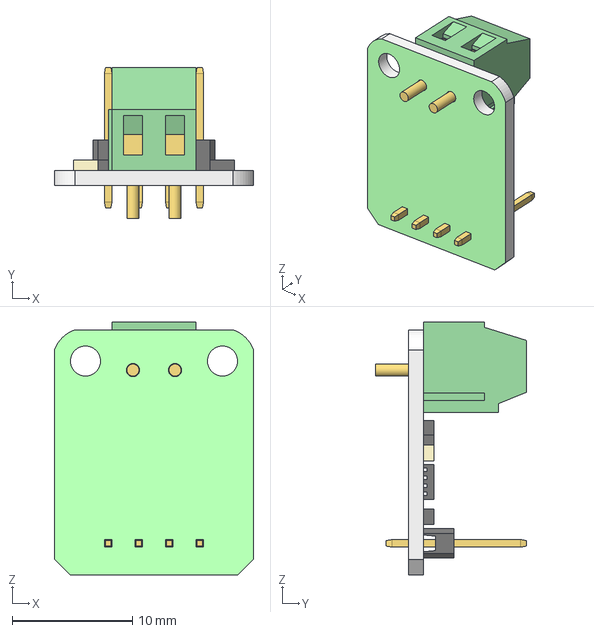
[picture p131: CAD file, 2026-11-11]
modules/00_Electronics/CAD/STEP/00-21 Thermocouple amplifier Placeholder.step
16.6 x 12.6 x 21.0 mm
