cryoTUD/optobot/modules/02_Climate_chamber/CAD/STEP/02-09 Humidity Tube Inlet v2.step

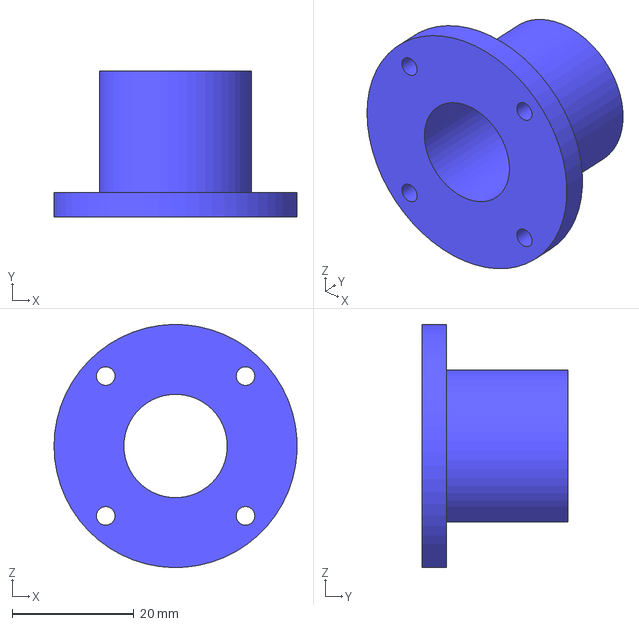
[picture p132: CAD file, 2026-11-11]
modules/02_Climate_chamber/CAD/STEP/02-09 Humidity Tube Inlet v2.step
40.0 x 24.0 x 40.0 mm
