cryoTUD/optobot/modules/02_Climate_chamber/CAD/STEP/02-16 Roof Beam Y v2.step

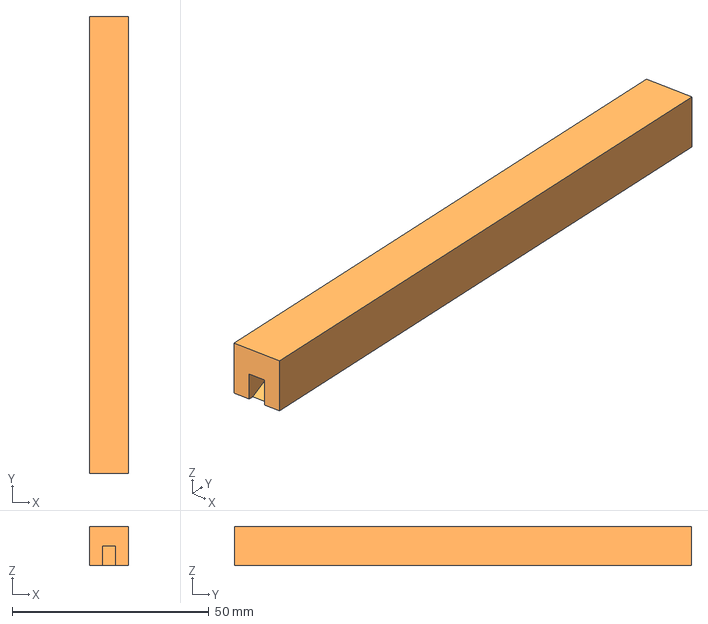
[picture p133: CAD file, 2026-11-11]
modules/02_Climate_chamber/CAD/STEP/02-16 Roof Beam Y v2.step
10.0 x 116.0 x 10.0 mm
