cryoTUD/optobot/modules/00_Electronics/CAD/STEP/00-22 N-Channel Mosfet Placeholder.step

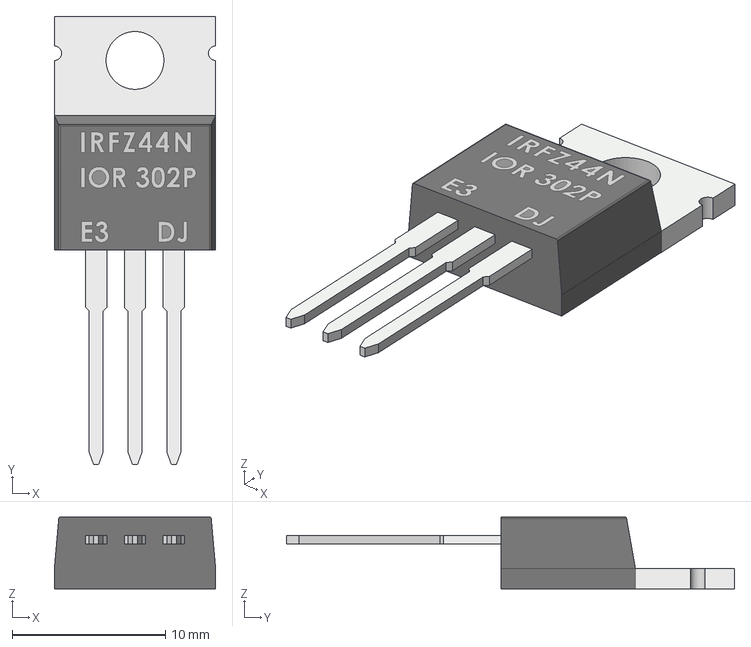
[picture p134: CAD file, 2026-11-11]
modules/00_Electronics/CAD/STEP/00-22 N-Channel Mosfet Placeholder.step
10.5 x 29.3 x 4.70 mm
