cryoTUD/optobot/modules/02_Climate_chamber/CAD/STEP/02-10 Sample Inlet Housing Inside v6.step

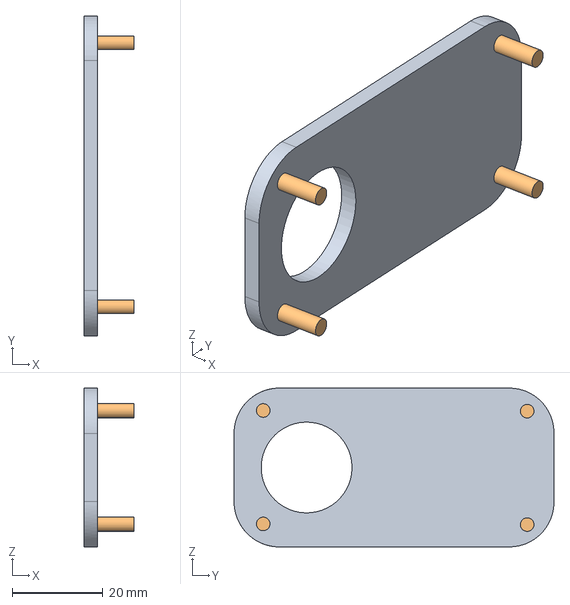
[picture p135: CAD file, 2026-11-11]
modules/02_Climate_chamber/CAD/STEP/02-10 Sample Inlet Housing Inside v6.step
11.0 x 70.5 x 35.0 mm
