cryoTUD/optobot/modules/02_Climate_chamber/CAD/STEP/02-01 Base Plate v14.step

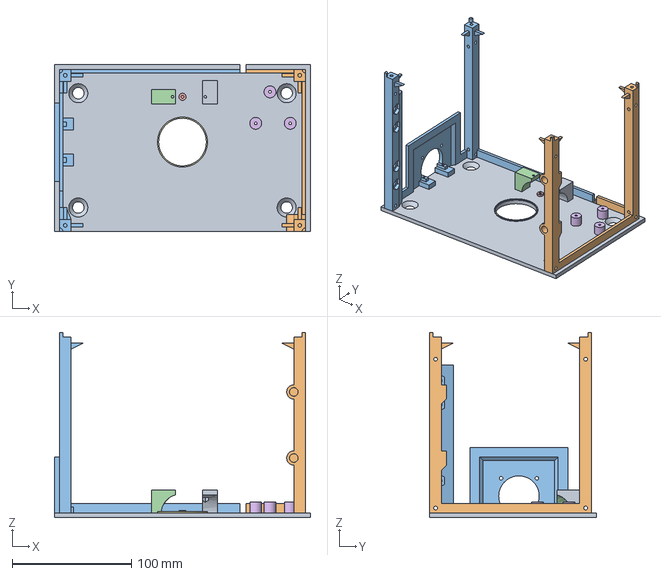
[picture p136: CAD file, 2026-11-11]
modules/02_Climate_chamber/CAD/STEP/02-01 Base Plate v14.step
215.0 x 140.0 x 155.5 mm
