cryoTUD/optobot/modules/02_Climate_chamber/CAD/STEP/02-03 Left Wall v2.step

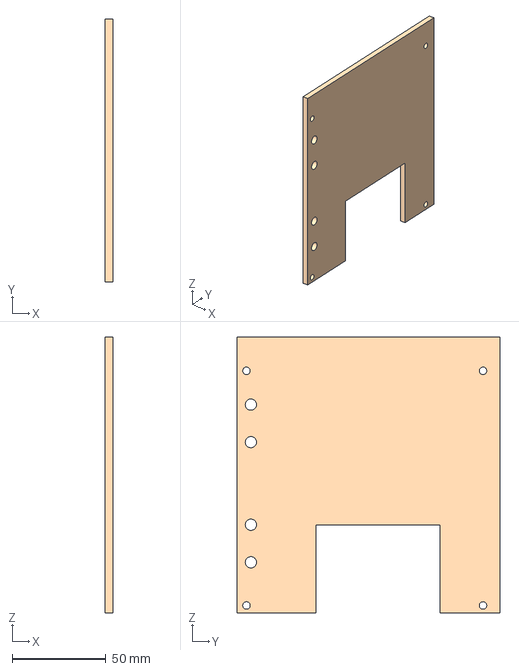
[picture p137: CAD file, 2026-11-11]
modules/02_Climate_chamber/CAD/STEP/02-03 Left Wall v2.step
4.00 x 140.0 x 147.0 mm
