cryoTUD/optobot/modules/02_Climate_chamber/CAD/STEP/02-29 Door magnet.step

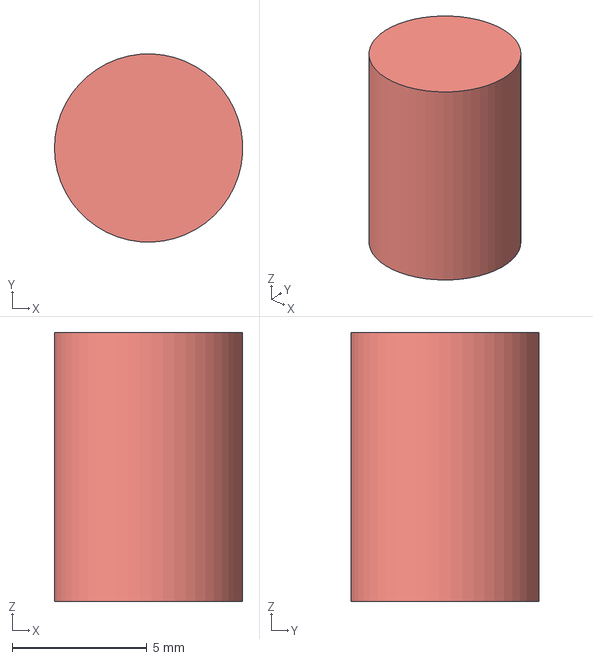
[picture p138: CAD file, 2026-11-11]
modules/02_Climate_chamber/CAD/STEP/02-29 Door magnet.step
6.99 x 7.00 x 10.0 mm
