cryoTUD/optobot/modules/02_Climate_chamber/CAD/STEP/02-41 Valve support box lid.step

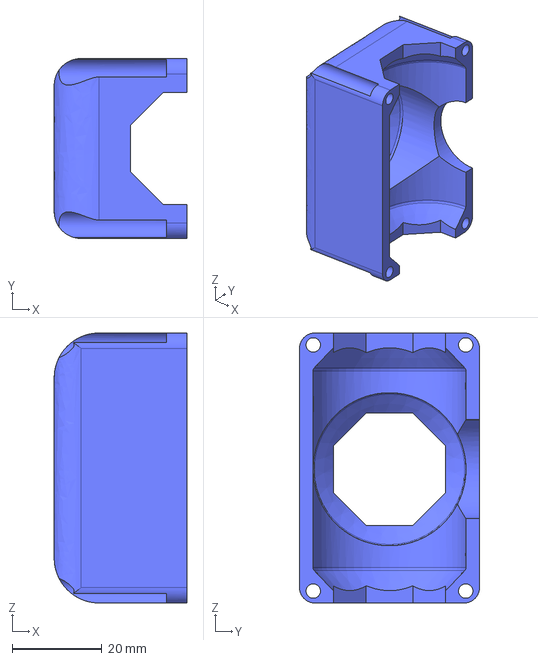
[picture p139: CAD file, 2026-11-11]
modules/02_Climate_chamber/CAD/STEP/02-41 Valve support box lid.step
29.5 x 40.0 x 60.0 mm
