cryoTUD/optobot/modules/02_Climate_chamber/CAD/STEP/02-40 Valve support box.step

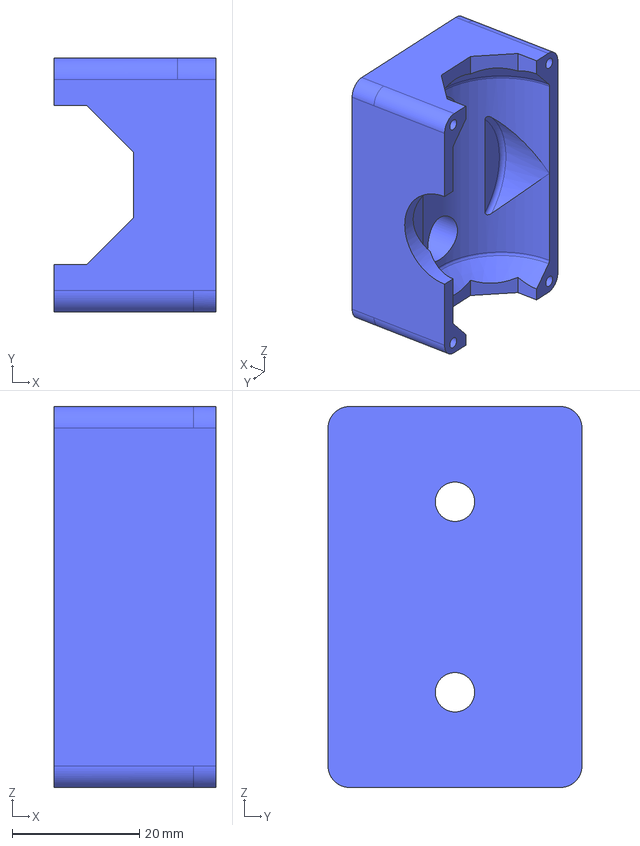
[picture p140: CAD file, 2026-11-11]
modules/02_Climate_chamber/CAD/STEP/02-40 Valve support box.step
25.5 x 40.0 x 60.0 mm
