cryoTUD/optobot/modules/02_Climate_chamber/CAD/STEP/02-18 Humidifier Chamber v4.step

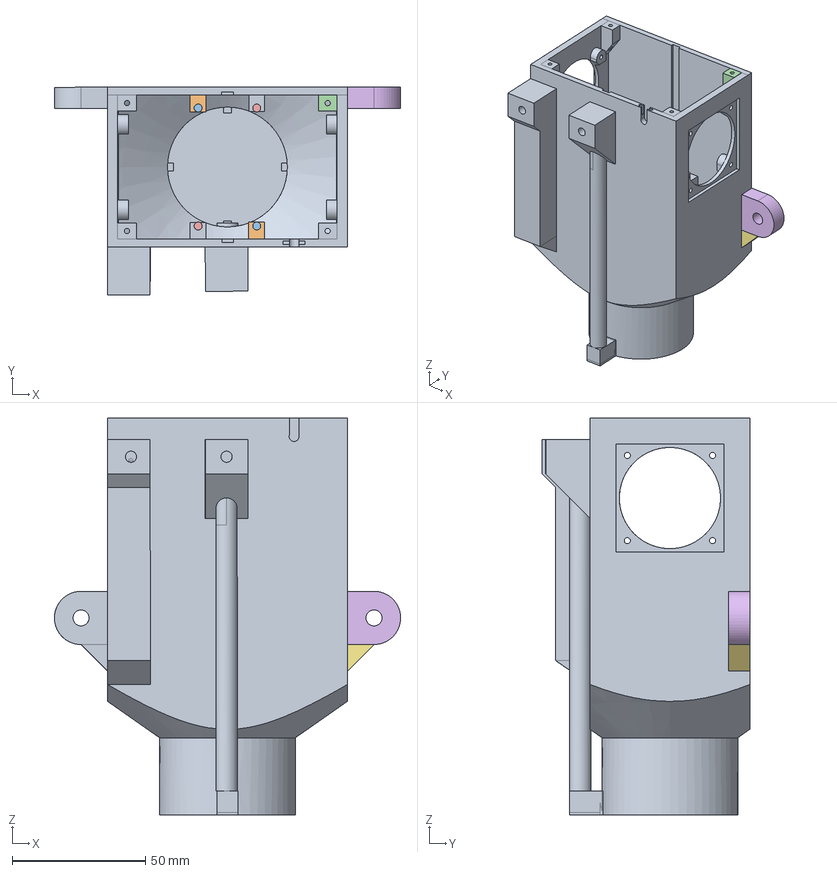
[picture p141: CAD file, 2026-11-11]
modules/02_Climate_chamber/CAD/STEP/02-18 Humidifier Chamber v4.step
130.0 x 78.0 x 149.1 mm
