cryoTUD/optobot/modules/02_Climate_chamber/CAD/STEP/02-27 Humidifier Fan placeholder.step

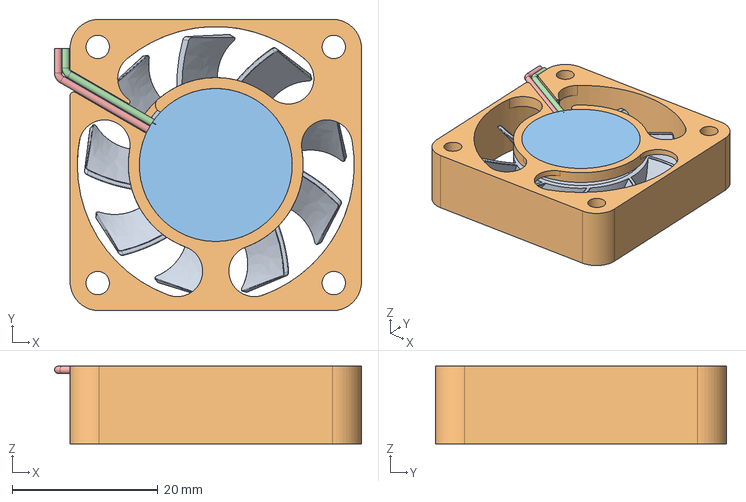
[picture p142: CAD file, 2026-11-11]
modules/02_Climate_chamber/CAD/STEP/02-27 Humidifier Fan placeholder.step
42.1 x 40.0 x 10.7 mm
