cryoTUD/optobot/modules/02_Climate_chamber/CAD/STEP/02-24 Reservoir window v2.step

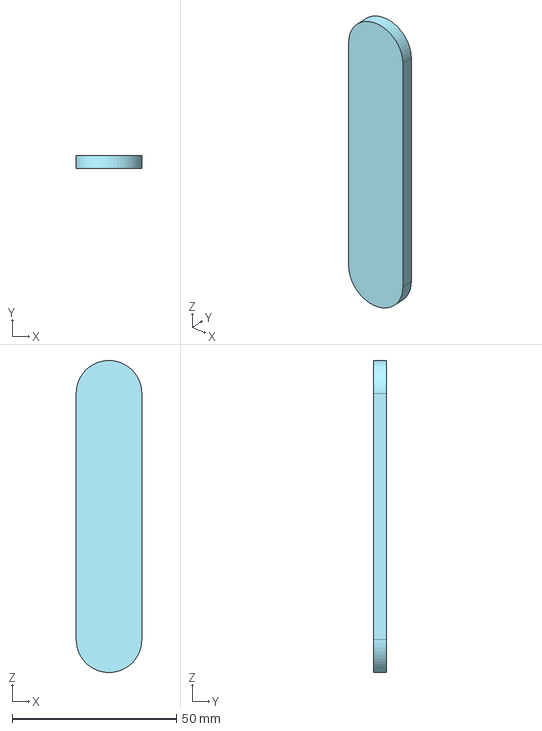
[picture p143: CAD file, 2026-11-11]
modules/02_Climate_chamber/CAD/STEP/02-24 Reservoir window v2.step
20.0 x 4.00 x 95.0 mm
