cryoTUD/optobot/modules/02_Climate_chamber/CAD/STEP/02-21 Humidifier chamber Inlet v2.step

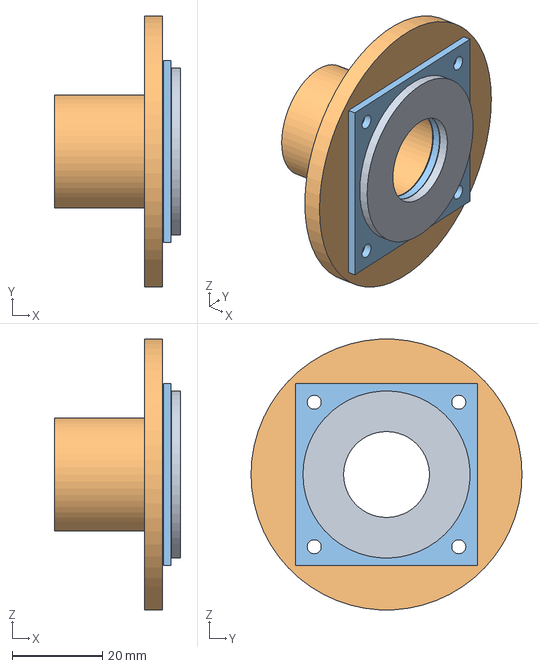
[picture p144: CAD file, 2026-11-11]
modules/02_Climate_chamber/CAD/STEP/02-21 Humidifier chamber Inlet v2.step
28.0 x 60.0 x 59.9 mm
