cryoTUD/optobot/modules/02_Climate_chamber/CAD/STEP/02-12 Sample Inlet Slider v5.step

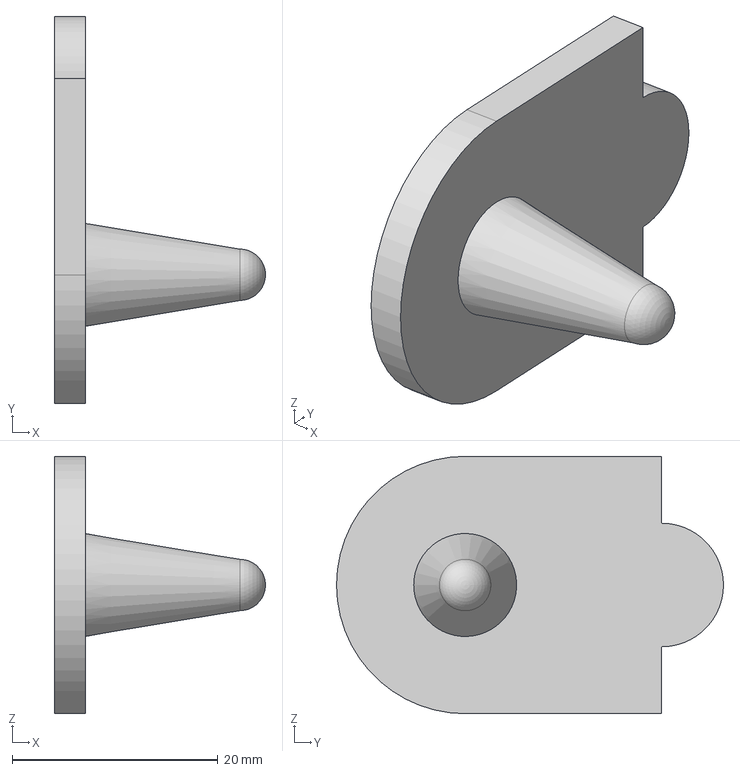
[picture p145: CAD file, 2026-11-11]
modules/02_Climate_chamber/CAD/STEP/02-12 Sample Inlet Slider v5.step
20.5 x 37.6 x 25.0 mm
