cryoTUD/optobot/modules/02_Climate_chamber/CAD/STEP/02-34 Pneumatic fitting 6mm, M5, Placeholder.step

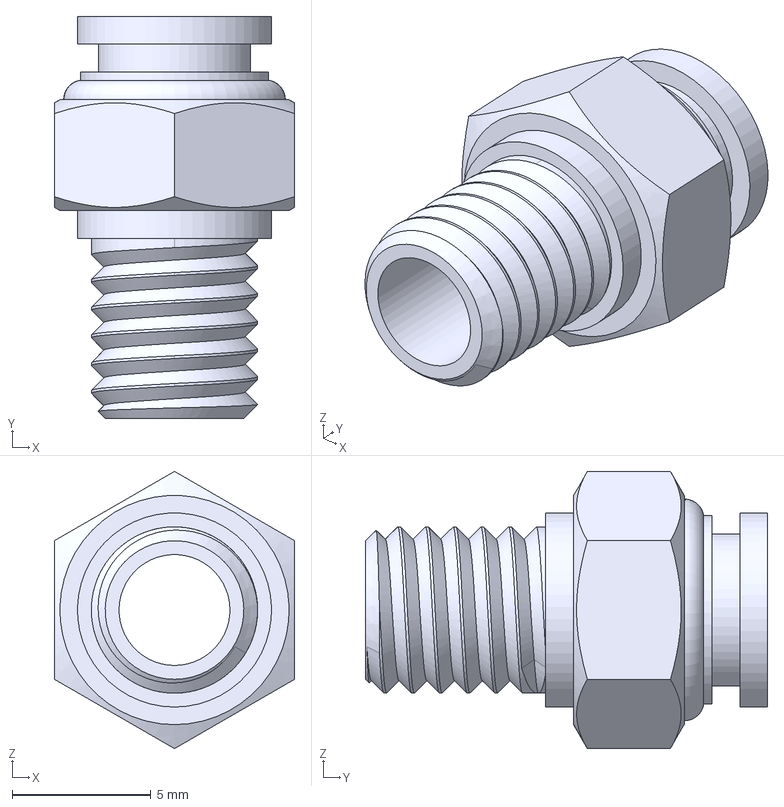
[picture p146: CAD file, 2026-11-11]
modules/02_Climate_chamber/CAD/STEP/02-34 Pneumatic fitting 6mm, M5, Placeholder.step
8.66 x 14.5 x 10.0 mm
