cryoTUD/optobot/modules/02_Climate_chamber/CAD/STEP/02-33 Pneumatic fitting 6mm, quarter In, Placeholder.step

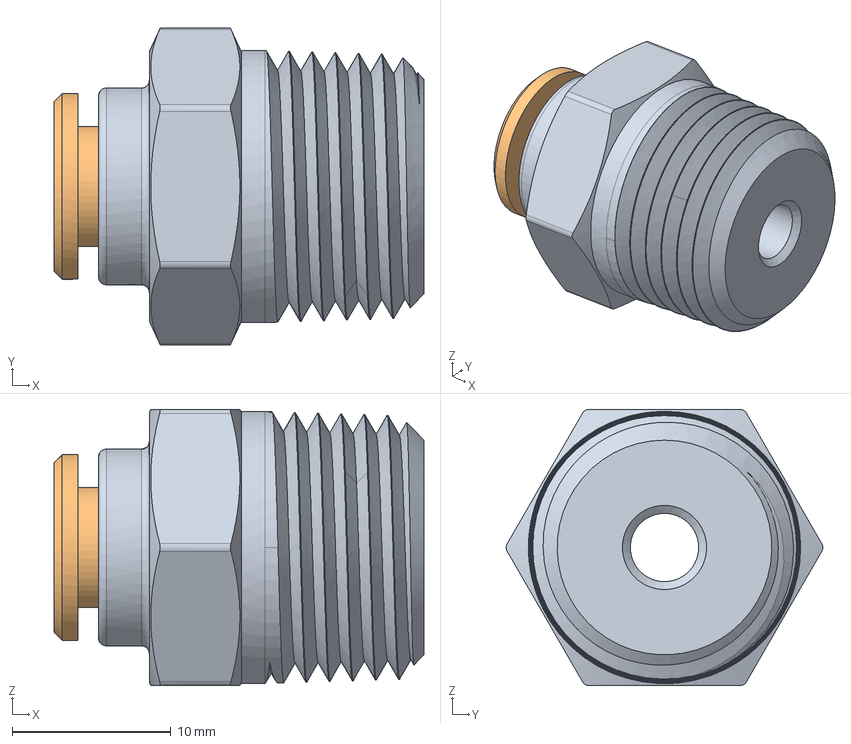
[picture p147: CAD file, 2026-11-11]
modules/02_Climate_chamber/CAD/STEP/02-33 Pneumatic fitting 6mm, quarter In, Placeholder.step
23.3 x 19.9 x 17.4 mm
