cryoTUD/optobot/(list of files, cad)

Other CAD files:
top_level_assembly/Optobot.step
modules/02_Climate_chamber/CAD/STEP/02-08.1 Door Hinge Side 1.step
modules/00_Electronics/CAD/STEP/00-01 Control Box Bottom v2.step
modules/02_Climate_chamber/CAD/STEP/02-08.1 Door Hinge Side 2.step
modules/02_Climate_chamber/CAD/STEP/02-28 Door Hinge Pin.step
modules/02_Climate_chamber/CAD/STEP/02-13 Shutter Servo.step
modules/00_Electronics/CAD/Fusion/00-01 Control Box Bottom.f3d
modules/00_Electronics/CAD/Fusion/00-02 Control Box Top v2.f3d
modules/00_Electronics/CAD/Fusion/00-03 PID Box top v2.f3d
modules/00_Electronics/CAD/Fusion/00-04 PID Box bottom v4.f3d
modules/00_Electronics/CAD/Fusion/00-09 Joystick mount.f3d
modules/00_Electronics/CAD/Fusion/00-14 Perfboard Max232 support Placeholder.f3d
modules/00_Electronics/CAD/Fusion/00-16 Mounting rail Placeholder.f3d
modules/00_Electronics/CAD/Fusion/00-19 Perfboard DC-DC converter support Placeholder.f3d
modules/00_Electronics/CAD/Fusion/00-27 Perfboard Arduino Nano support Placeholder.f3d
modules/00_Electronics/CAD/STEP/00-03 PID Box top v1.step
modules/00_Electronics/CAD/STL/00-02 Control Box Top.stl
modules/00_Electronics/CAD/STL/00-03 PID Box top v2.stl
modules/00_Electronics/CAD/STL/00-04 PID Box bottom v4.stl
modules/00_Electronics/CAD/STL/00-09 Joystick mount.stl
modules/01_Blotting/CAD/Fusion/01-02 Blotter mount v4.f3d
modules/01_Blotting/CAD/Fusion/01-03 Gear rack v2.f3d
modules/01_Blotting/CAD/Fusion/01-04 Slider connecter v2.f3d
modules/01_Blotting/CAD/Fusion/01-05 Slider v2.f3d
modules/01_Blotting/CAD/Fusion/01-06 Guide block v2.f3d
modules/01_Blotting/CAD/Fusion/01-07 Servo Gear.f3d
modules/01_Blotting/CAD/STL/01-02 Blotter mount v4.stl
modules/01_Blotting/CAD/STL/01-03 Gear rack v2.stl
modules/01_Blotting/CAD/STL/01-04 Slider connecter v2.stl
modules/01_Blotting/CAD/STL/01-05 Slider v2.stl
modules/01_Blotting/CAD/STL/01-06 Guide block v2.stl
modules/01_Blotting/CAD/STL/01-07 Servo Gear.stl
modules/02_Climate_chamber/CAD/Fusion/02-01 Base Plate v14.f3d
modules/02_Climate_chamber/CAD/Fusion/02-02 Right Wall v4.f3d
modules/02_Climate_chamber/CAD/Fusion/02-03 Left Wall v2.f3d
modules/02_Climate_chamber/CAD/Fusion/02-04 Back Wall v2.f3d
modules/02_Climate_chamber/CAD/Fusion/02-05 Top Plate v2.f3d
modules/02_Climate_chamber/CAD/Fusion/02-06 Door Lid v2.f3d
modules/02_Climate_chamber/CAD/Fusion/02-07 Door v2.f3d
modules/02_Climate_chamber/CAD/Fusion/02-08.1 Door Hinge Side 1.f3d
modules/02_Climate_chamber/CAD/Fusion/02-08.2 Door Hinge Side 2.f3d
modules/02_Climate_chamber/CAD/Fusion/02-08.3 Door Hinge Pin.f3d
modules/02_Climate_chamber/CAD/Fusion/02-09 Humidity Tube Inlet v2.f3d
modules/02_Climate_chamber/CAD/Fusion/02-10 Sample Inlet Housing Inside v6.f3d
modules/02_Climate_chamber/CAD/Fusion/02-11 Sample Inlet Housing Outside v7.f3d
modules/02_Climate_chamber/CAD/Fusion/02-12 Sample Inlet Slider v5.f3d
modules/02_Climate_chamber/CAD/Fusion/02-14 Shutter Plate v6.f3d
modules/02_Climate_chamber/CAD/Fusion/02-15 Roof Beam X v2.f3d
modules/02_Climate_chamber/CAD/Fusion/02-16 Roof Beam Y v2.f3d
modules/02_Climate_chamber/CAD/Fusion/02-17 Door Window v2.f3d
modules/02_Climate_chamber/CAD/Fusion/02-18 Humidifier Chamber v4.f3d
modules/02_Climate_chamber/CAD/Fusion/02-20 Chamber divider horizontal v2.f3d
modules/02_Climate_chamber/CAD/Fusion/02-21 Humidifier chamber Inlet v2.f3d
modules/02_Climate_chamber/CAD/Fusion/02-22 Humidifier cable clamp v2.f3d
modules/02_Climate_chamber/CAD/Fusion/02-23 Reservoir v2.f3d
modules/02_Climate_chamber/CAD/Fusion/02-24 Reservoir window v2.f3d
modules/02_Climate_chamber/CAD/Fusion/02-25 Humidifier chamber top lid v2.f3d
modules/02_Climate_chamber/CAD/Fusion/02-26 Humidifier Placeholder.f3d
modules/02_Climate_chamber/CAD/Fusion/02-28 Door Hinge Pin.f3d
modules/02_Climate_chamber/CAD/Fusion/02-29 Door magnet.f3d
modules/02_Climate_chamber/CAD/Fusion/02-31 Humidity inlet cap.f3d
modules/02_Climate_chamber/CAD/Fusion/02-38 Valve lever.f3d
modules/02_Climate_chamber/CAD/Fusion/02-40 Valve support box.f3d
modules/02_Climate_chamber/CAD/Fusion/02-41 Valve support box lid.f3d
modules/02_Climate_chamber/CAD/STL/02-01 Base Plate v14.stl
modules/02_Climate_chamber/CAD/STL/02-06 Door Lid v2.stl
modules/02_Climate_chamber/CAD/STL/02-07 Door v2.stl
modules/02_Climate_chamber/CAD/STL/02-09 Humidity Tube Inlet v2.stl
modules/02_Climate_chamber/CAD/STL/02-10 Sample Inlet Housing Inside v6.stl
modules/02_Climate_chamber/CAD/STL/02-11 Sample Inlet Housing Outside v7.stl
modules/02_Climate_chamber/CAD/STL/02-12 Sample Inlet Slider v5.stl
modules/02_Climate_chamber/CAD/STL/02-14 Shutter Plate v6.stl
modules/02_Climate_chamber/CAD/STL/02-15 Roof Beam X v2.stl
modules/02_Climate_chamber/CAD/STL/02-16 Roof Beam Y v2.stl
modules/02_Climate_chamber/CAD/STL/02-18 Humidifier Chamber v4.stl
modules/02_Climate_chamber/CAD/STL/02-21 Humidifier chamber Inlet v2.stl
modules/02_Climate_chamber/CAD/STL/02-22 Humidifier cable clamp v2.stl
modules/02_Climate_chamber/CAD/STL/02-23 Reservoir v2.stl
modules/02_Climate_chamber/CAD/STL/02-31 Humidity inlet cap.stl
modules/02_Climate_chamber/CAD/STL/02-38 Valve lever.stl
modules/02_Climate_chamber/CAD/STL/02-40 Valve support box.stl
modules/02_Climate_chamber/CAD/STL/02-41 Valve support box lid.stl
modules/04_Plunger_motor/CAD/Fusion/04-13 Cup holder.f3d
modules/04_Plunger_motor/CAD/Fusion/04-14 Cup holder vertical connector.f3d
modules/04_Plunger_motor/CAD/Fusion/04-15 Tweezer snaplock Male v2.f3d
modules/04_Plunger_motor/CAD/Fusion/04-16 Tweezer snaplock Female v1.f3d
modules/04_Plunger_motor/CAD/STL/04-15 Tweezer snaplock Male v2.stl
modules/04_Plunger_motor/CAD/STL/04-16 Tweezer snaplock Female v1.stl
modules/05_Temperature_controlled_cup/CAD/Fusion/05-01 Base cup bottom.f3d
modules/05_Temperature_controlled_cup/CAD/Fusion/05-02 Base cup top v3.f3d
modules/05_Temperature_controlled_cup/CAD/Fusion/05-03 Middle cup v2.f3d
modules/05_Temperature_controlled_cup/CAD/Fusion/05-04 Holder Ethane cup & Sample v1.f3d
modules/05_Temperature_controlled_cup/CAD/Fusion/05-05 Brass cup Placeholder.f3d
modules/05_Temperature_controlled_cup/CAD/Fusion/05-06 Floating ring.f3d
modules/05_Temperature_controlled_cup/CAD/Fusion/05-07 Heater element Placeholder.f3d
modules/05_Temperature_controlled_cup/CAD/Fusion/05-08 Thermocouple Placeholder.f3d
modules/05_Temperature_controlled_cup/CAD/STL/05-01 Base cup bottom.stl
modules/05_Temperature_controlled_cup/CAD/STL/05-02 Base cup top v3.stl
modules/05_Temperature_controlled_cup/CAD/STL/05-03 Middle cup v2.stl
modules/05_Temperature_controlled_cup/CAD/STL/05-04 Holder Ethane cup & Sample v1.stl
modules/06_Support_structure/CAD/Fusion/06-01 Alu Profile 40x40 L180.f3d
modules/06_Support_structure/CAD/Fusion/06-02 Alu Profile 40x40 L470.f3d
modules/06_Support_structure/CAD/Fusion/06-03 Alu Profile 40x40 L700.f3d
modules/06_Support_structure/CAD/Fusion/06-04 Alu Profile 40x40 L460.f3d
modules/06_Support_structure/CAD/Fusion/06-05 Alu Profile 40x40 L225.f3d
modules/06_Support_structure/CAD/Fusion/06-06 Alu Profile 40x40 L145.f3d
modules/06_Support_structure/CAD/Fusion/06-07 Alu Profile 40x40 L230.f3d
modules/06_Support_structure/CAD/Fusion/06-08 Alu Profile 40x40 L235.f3d
modules/06_Support_structure/CAD/Fusion/06-08 Alu Profile 80x40 L470.f3d
modules/06_Support_structure/CAD/Fusion/06-11 Angle Bracket set placeholder.f3d
modules/06_Support_structure/CAD/Fusion/06-12 Angle bracket Placeholder.f3d
