cryoTUD/optobot/control/wiring/Optobot Wiring diagram.png

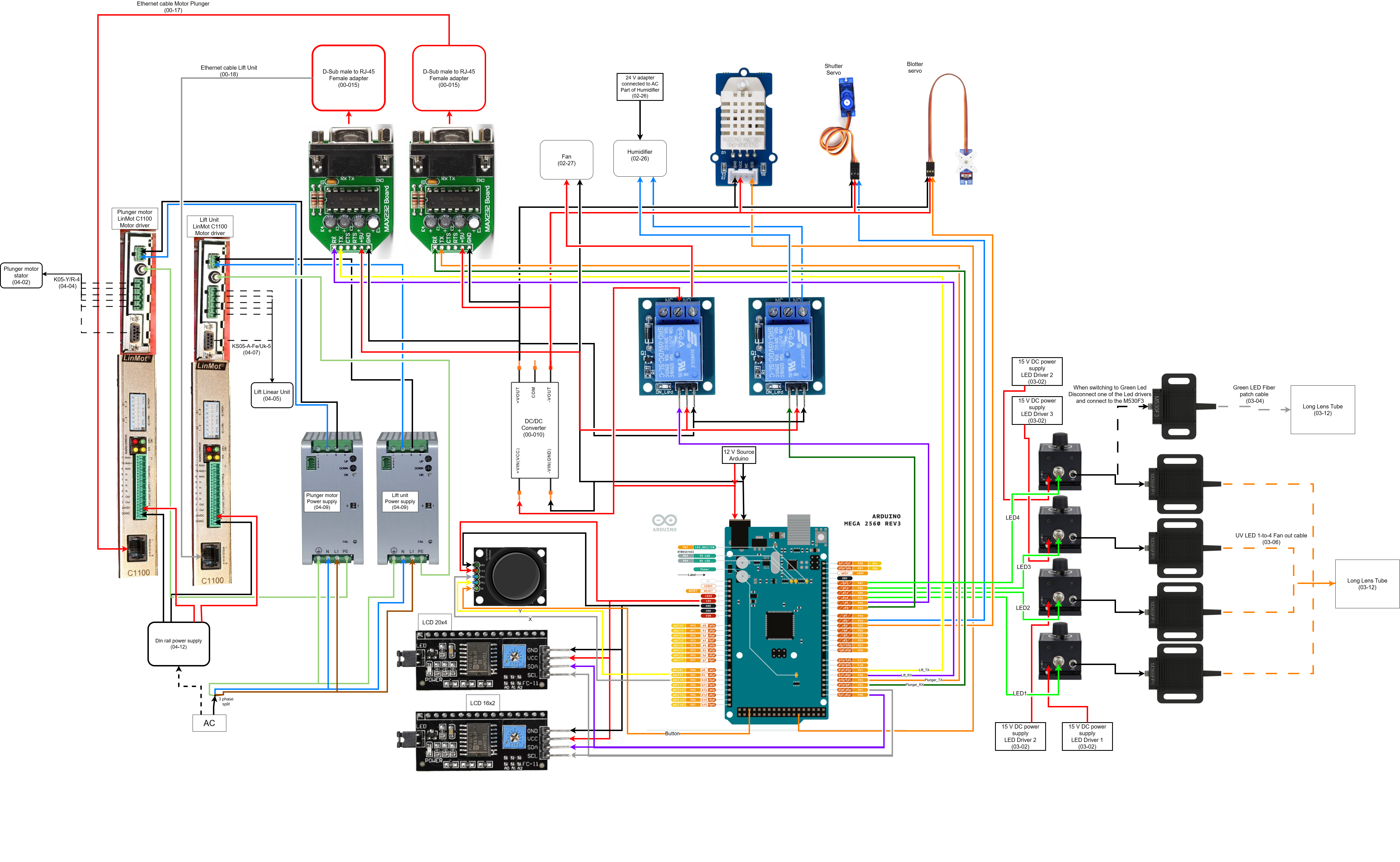
control/wiring/Optobot Wiring diagram.png
