cryoTUD/optobot/control/wiring/Wiring diagram PID box.png

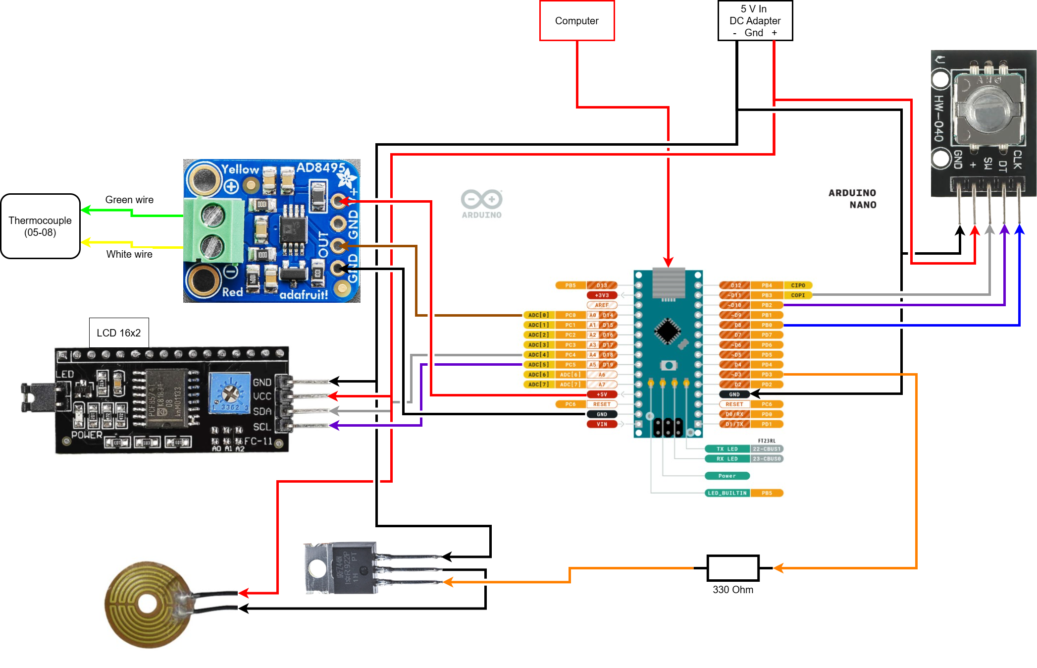
control/wiring/Wiring diagram PID box.png
