cryoTUD/optobot/modules/02_Climate_chamber/images/02.3_Valve_assembly/Valve Assembly side.png

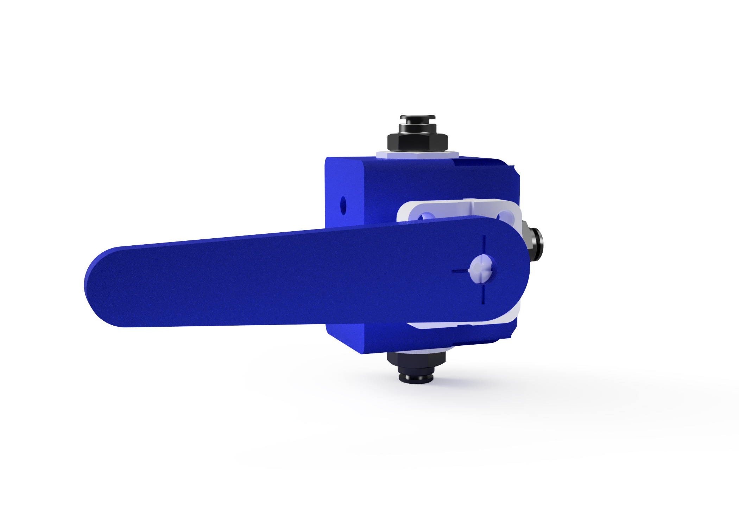
modules/02_Climate_chamber/images/02.3_Valve_assembly/Valve Assembly side.png
