cryoTUD/optobot/modules/04_Plunger_motor/images/Lift assembly - Horizontal left.png

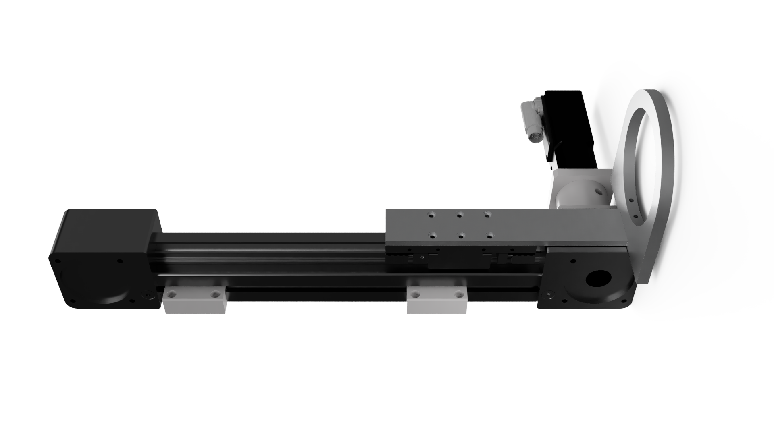
modules/04_Plunger_motor/images/Lift assembly - Horizontal left.png
