cryoTUD/optobot/modules/04_Plunger_motor/images/Lift assembly - Horizontal right.png

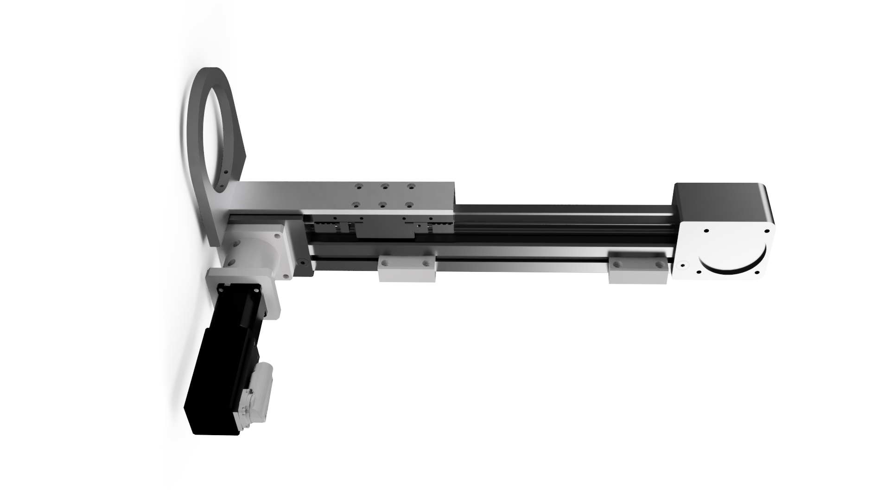
modules/04_Plunger_motor/images/Lift assembly - Horizontal right.png
