cryoTUD/optobot/modules/04_Plunger_motor/images/Plunger motor assembly - Horizontal.PNG

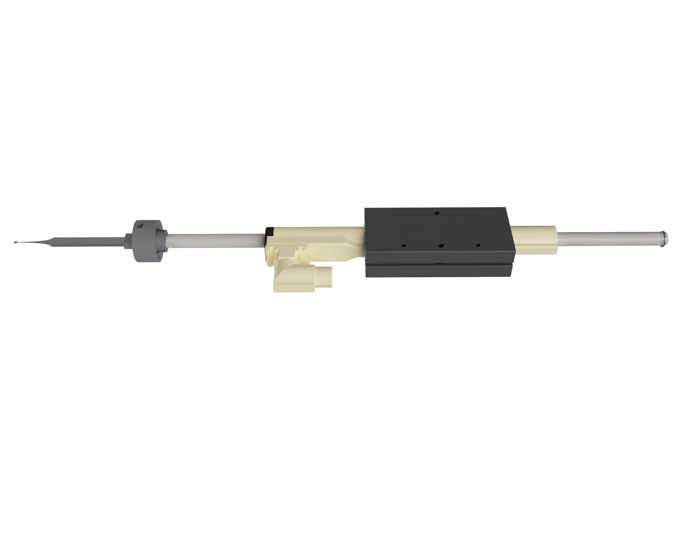
modules/04_Plunger_motor/images/Plunger motor assembly - Horizontal.PNG
