cryoTUD/optobot/modules/04_Plunger_motor/images/Plunger motor assembly.png

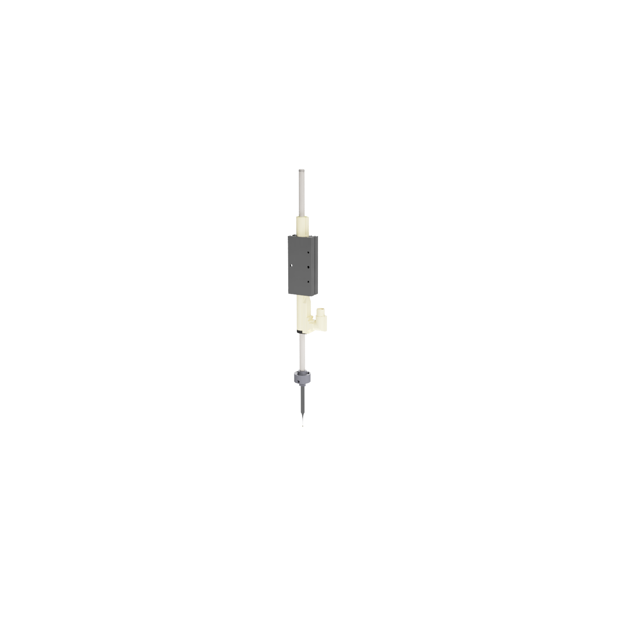
modules/04_Plunger_motor/images/Plunger motor assembly.png
