cryoTUD/optobot/top_level_assembly/Images/Optobot Isometric Left front.png

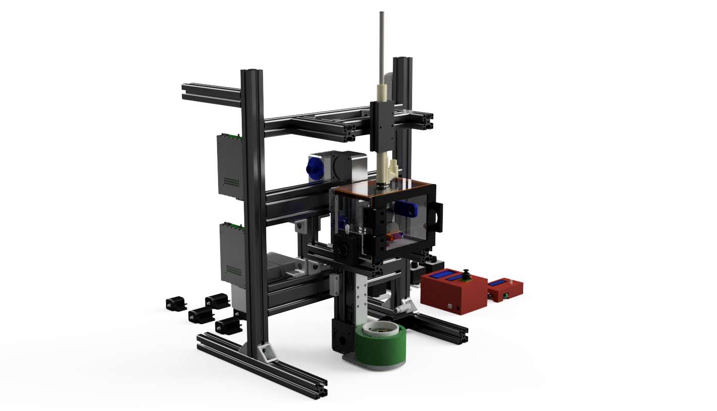
top_level_assembly/Images/Optobot Isometric Left front.png
