cryoTUD/optobot/top_level_assembly/Images/Optobot Isometric Left rear.png

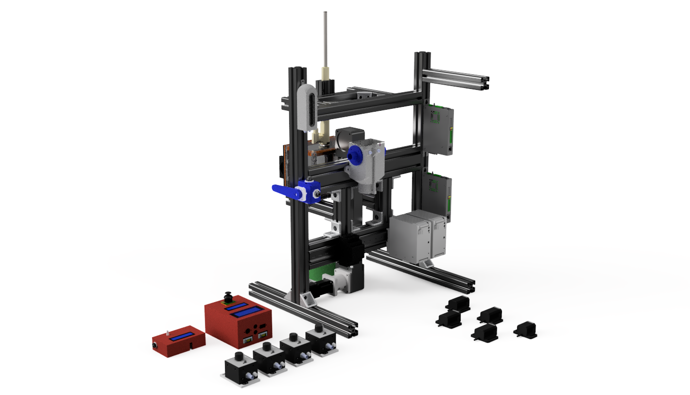
top_level_assembly/Images/Optobot Isometric Left rear.png
