cryoTUD/optobot/top_level_assembly/Images/Optobot Isometric Right front.png

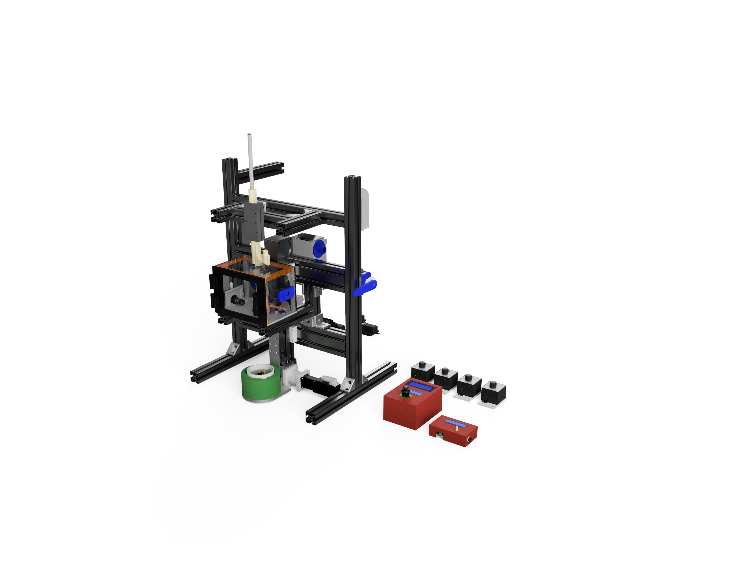
top_level_assembly/Images/Optobot Isometric Right front.png
