cryoTUD/optobot/top_level_assembly/Images/Optobot Isometric Right rear.png

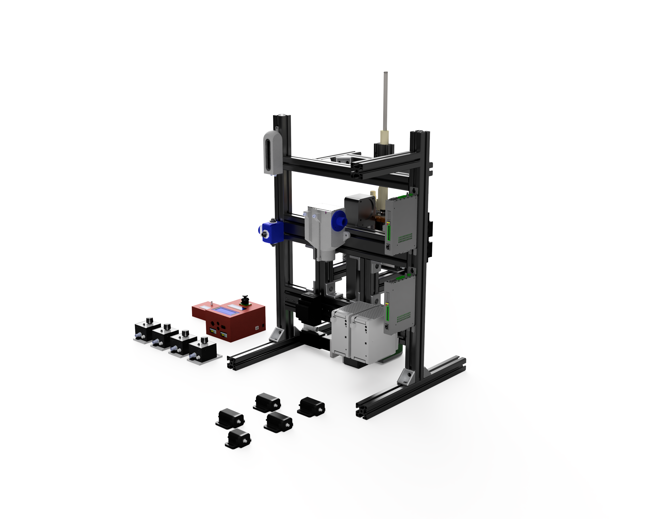
top_level_assembly/Images/Optobot Isometric Right rear.png
