cryoTUD/optobot/top_level_assembly/Optobot Assembly Drawing.pdf

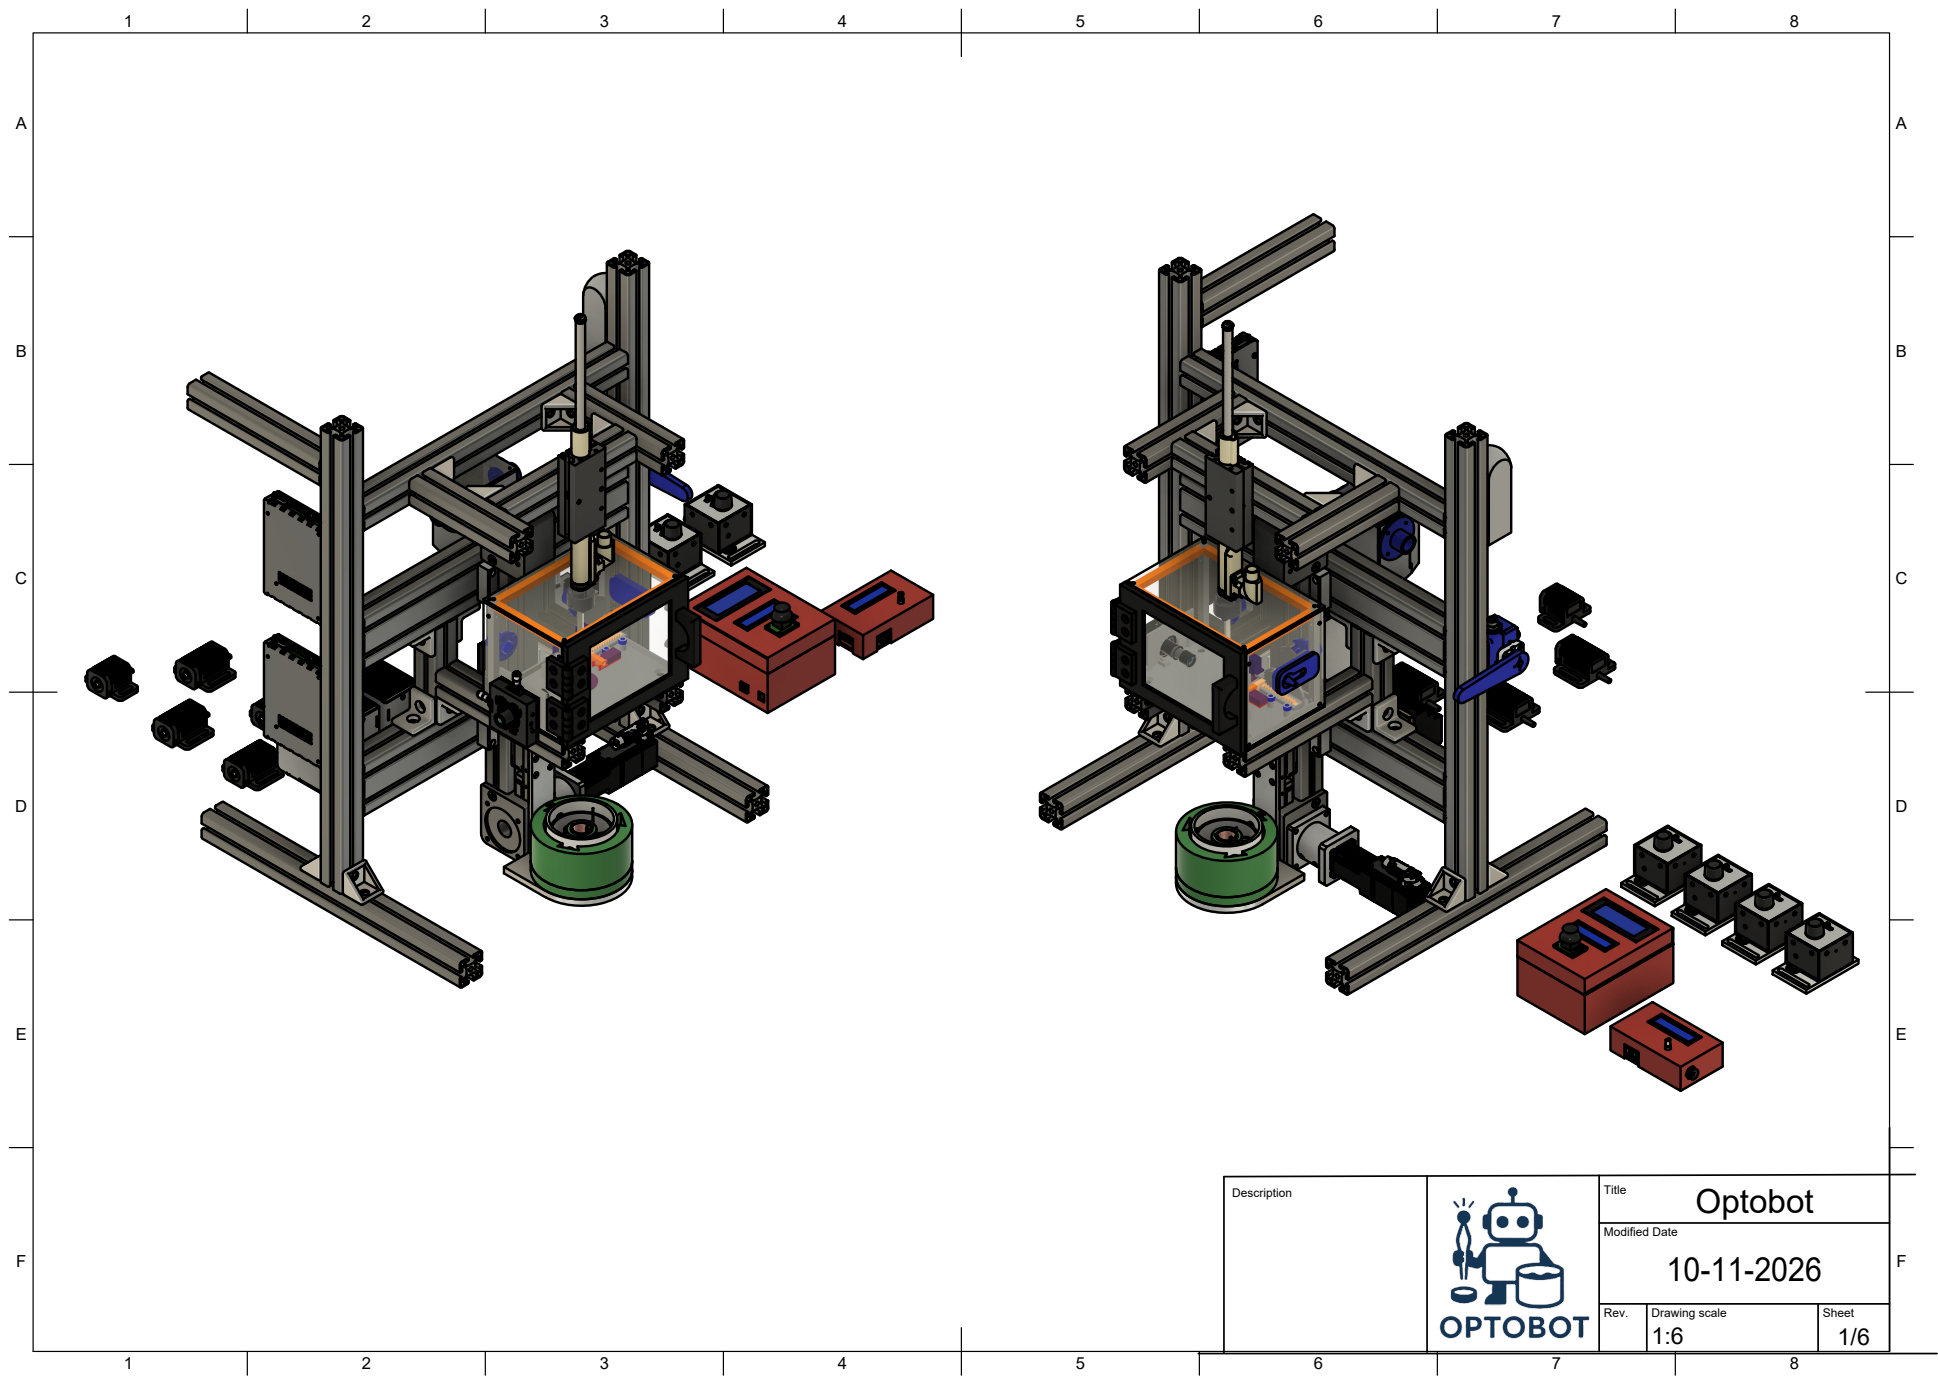
[picture p160: page 1]
Modified Date; Rev.; Drawing scale; Sheet

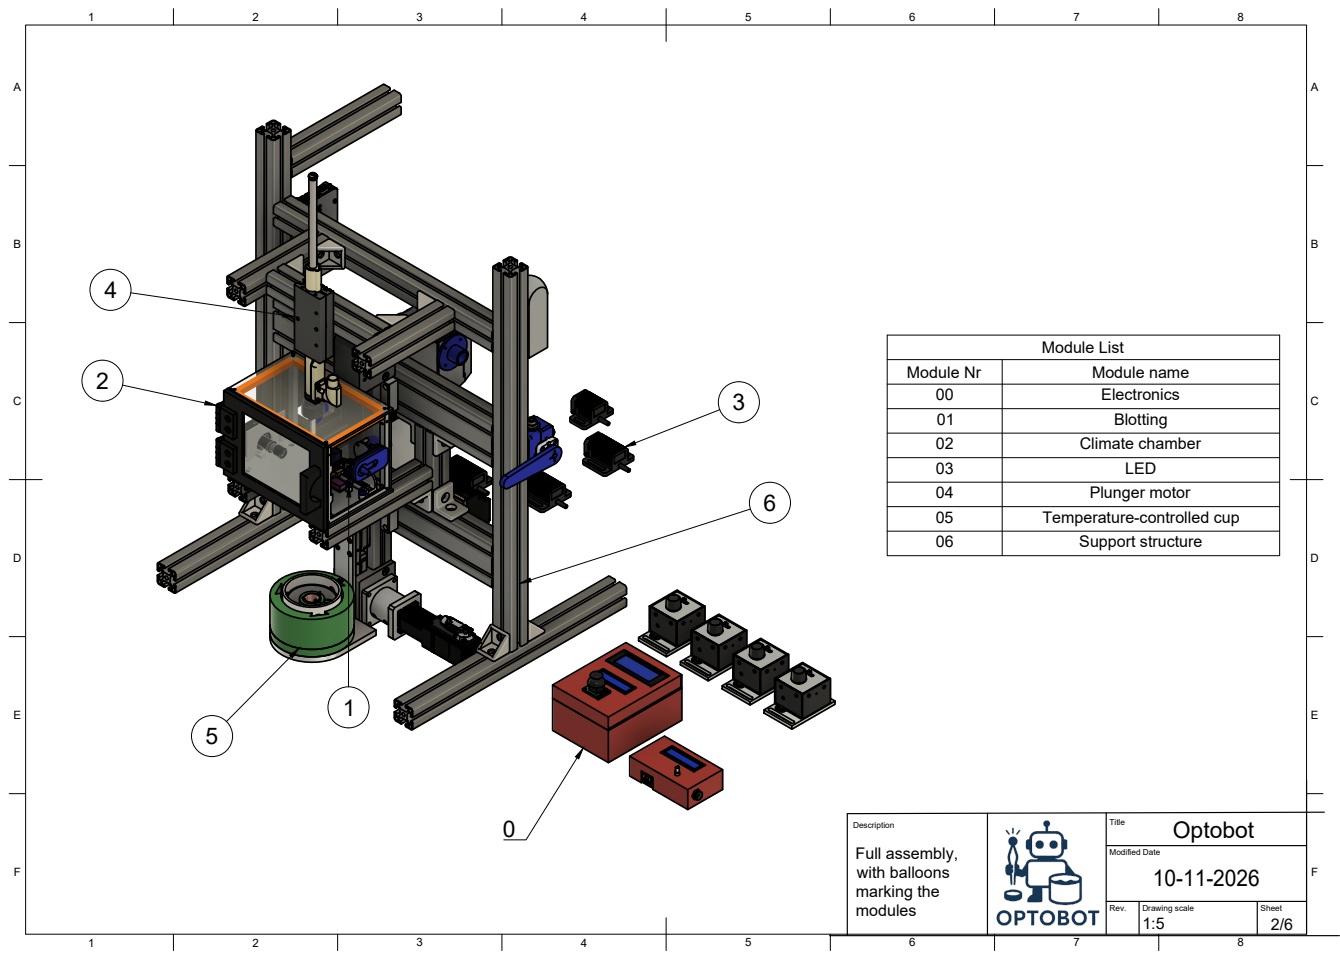
[picture p161: page 2]
Module List; Module Nr; Module name; Climate chamber; Plunger motor; Temperature-controlled cup; Support structure; Modified Date; Full assembly, with balloons marking the

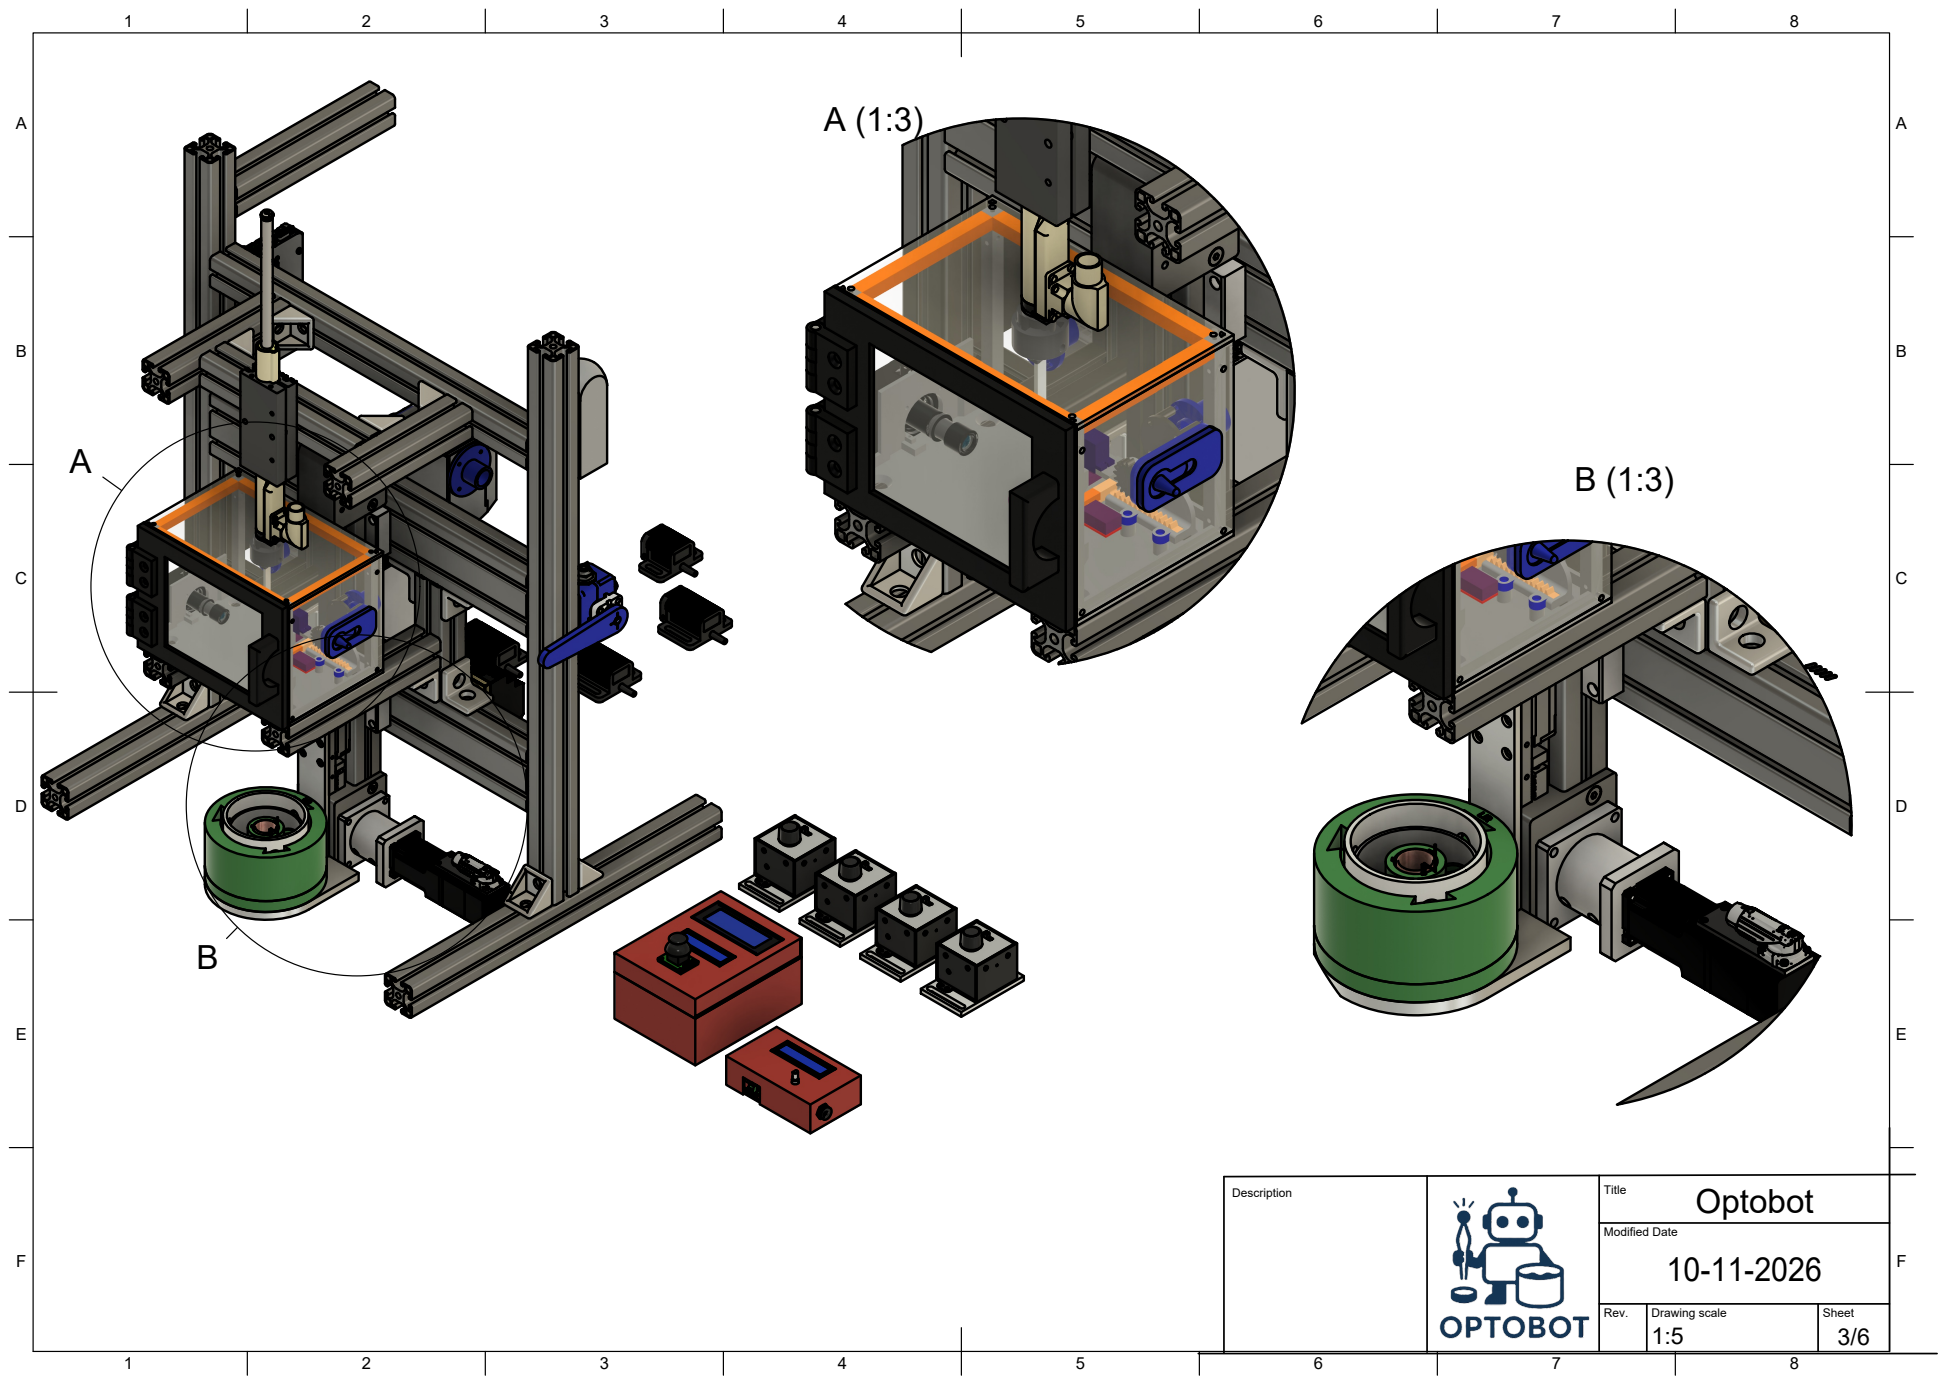
[picture p162: page 3]
Modified Date

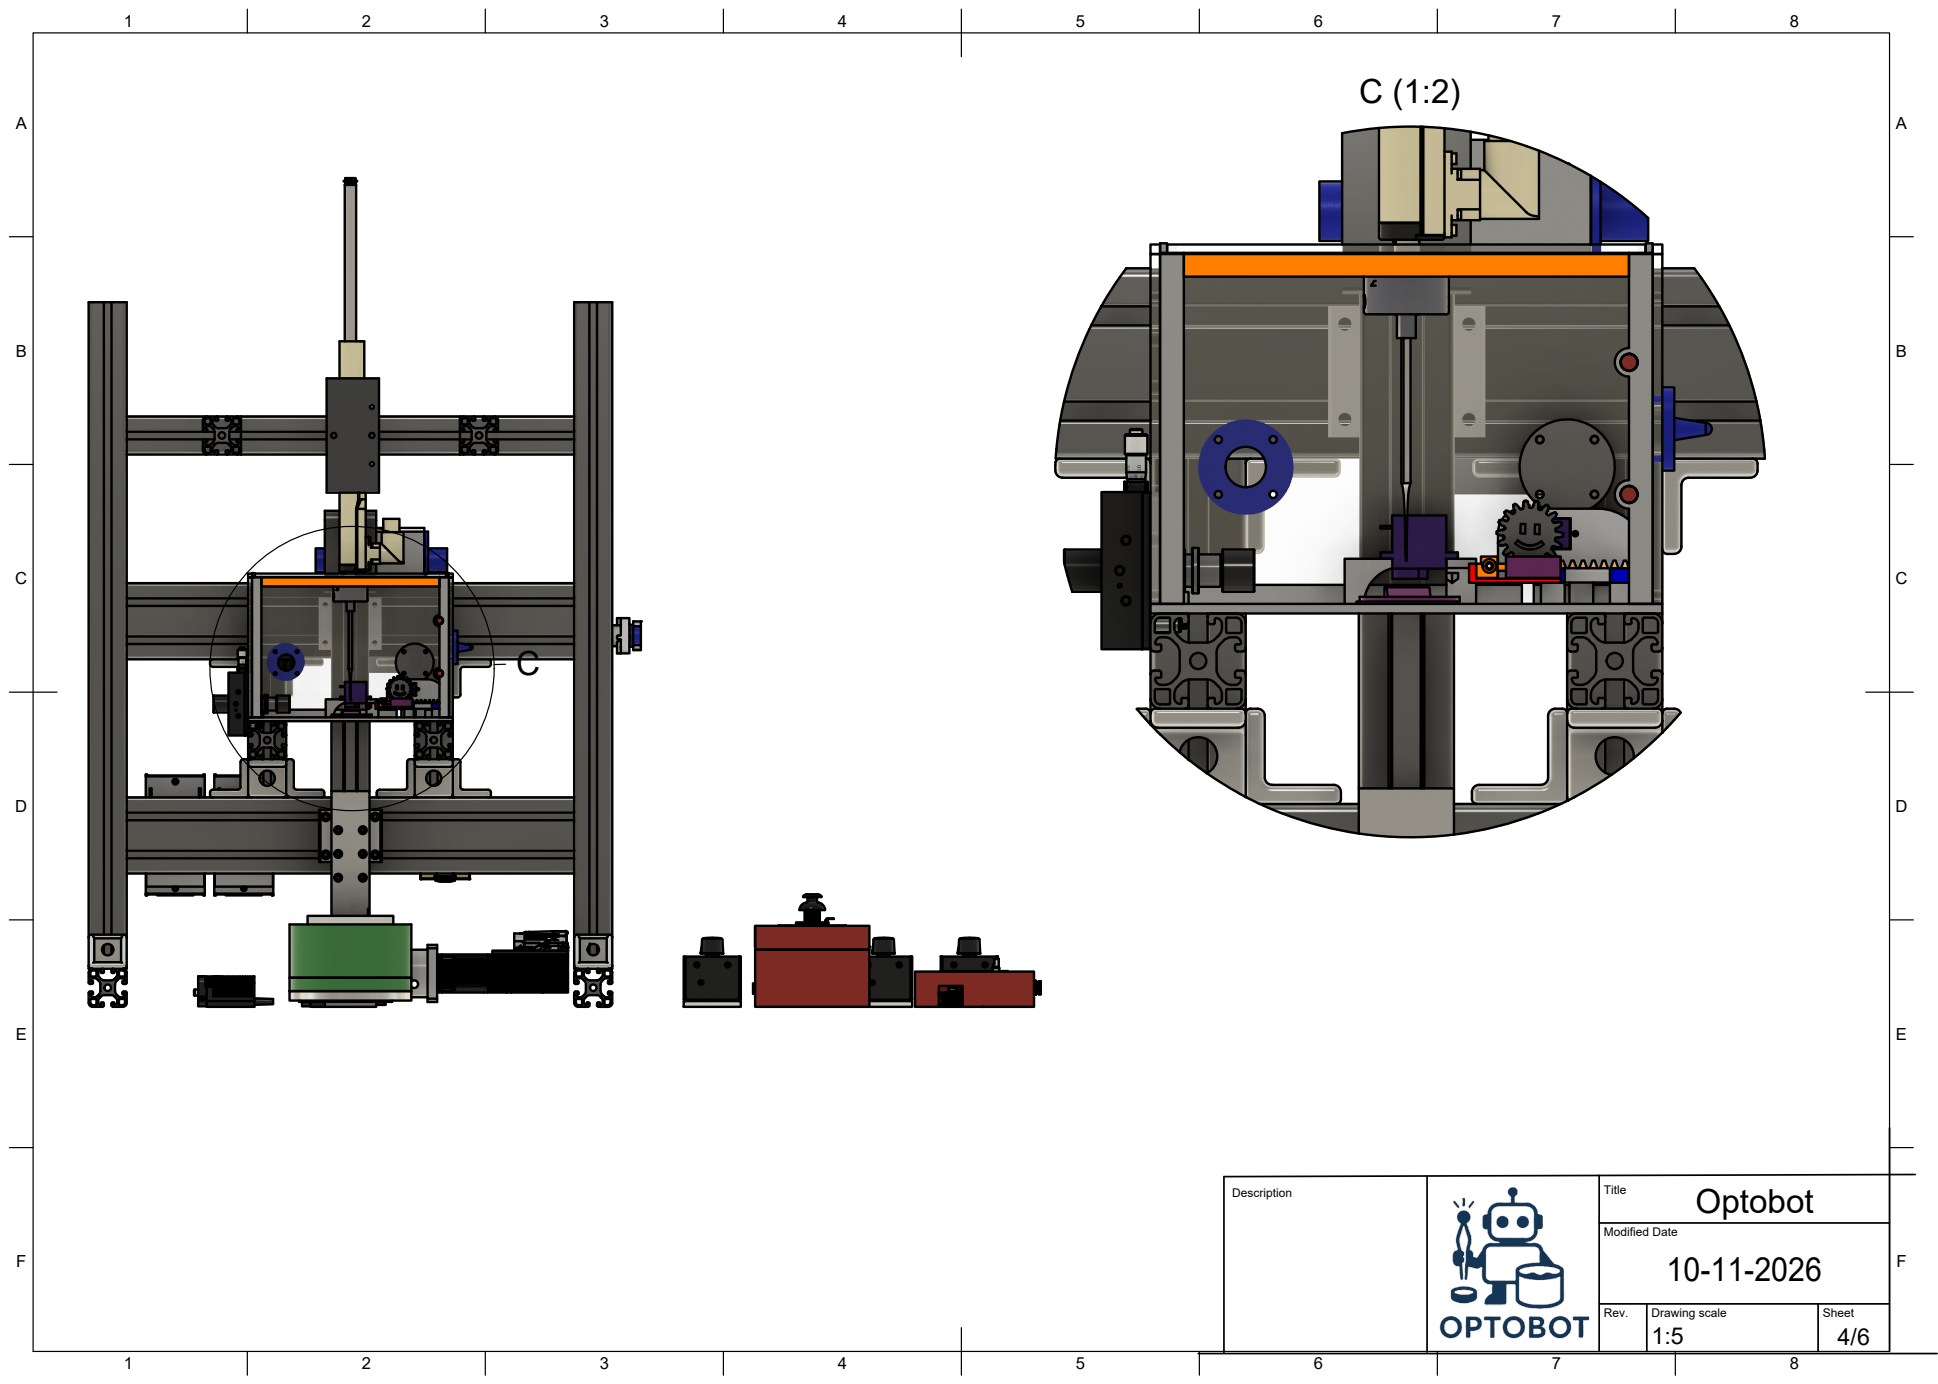
[picture p163: page 4]
Modified Date

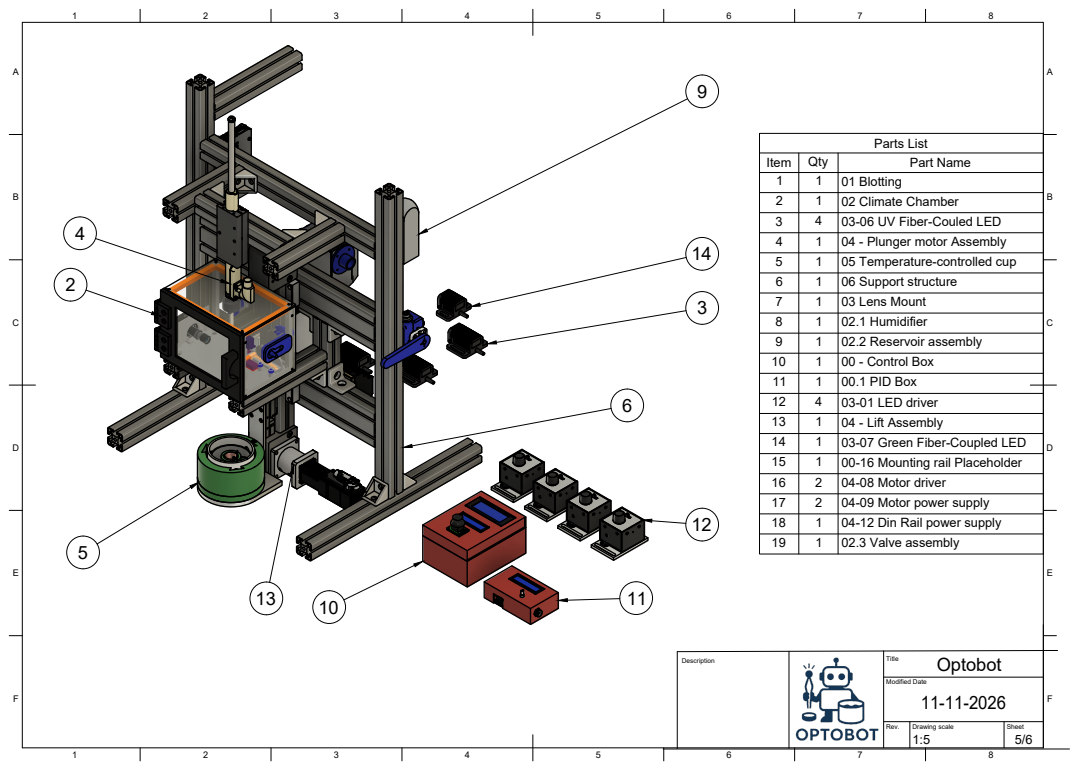
[picture p164: page 5]
8 BCDEF; ABCDEF; Parts List; Item; Qty; Part Name 1; 01 Blotting 2; 02 Climate Chamber 3; 03-06 UV Fiber-Couled LED 4; 04 - Plunger motor Assembly 5; 05 Temperature-controlled cup 6; 06 Support structure 7; 03 Lens Mount 8; 02.1 Humidifier 9; 02.2 Reservoir assembly; 00 - Control Box; 00.1 PID Box; 03-01 LED driver; 04 - Lift Assembly; 03-07 Green Fiber-Coupled LED; 00-16 Mounting rail Placeholder; 04-08 Motor driver; 04-09 Motor power supply; 04-12 Din Rail power supply; 02.3 Valve assembly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

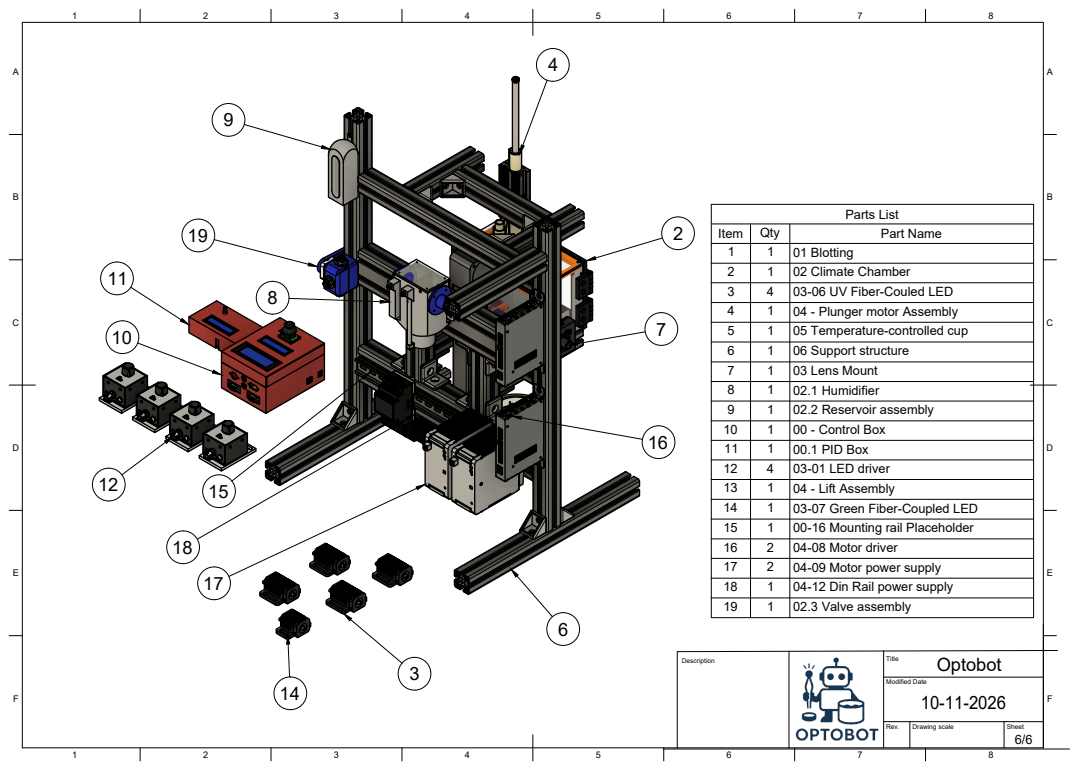
[picture p165: page 6]
8 BCDEF; ABCDEF; Parts List; Item; Qty; Part Name 1; 01 Blotting 2; 02 Climate Chamber 3; 03-06 UV Fiber-Couled LED 4; 04 - Plunger motor Assembly 5; 05 Temperature-controlled cup 6; 06 Support structure 7; 03 Lens Mount 8; 02.1 Humidifier 9; 02.2 Reservoir assembly; 00 - Control Box; 00.1 PID Box; 03-01 LED driver; 04 - Lift Assembly; 03-07 Green Fiber-Coupled LED; 00-16 Mounting rail Placeholder; 04-08 Motor driver; 04-09 Motor power supply; 04-12 Din Rail power supply; 02.3 Valve assembly 6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
