cryoTUD/optobot/modules/00_Electronics/Assembly/00 - Control Box Assembly Drawing.pdf

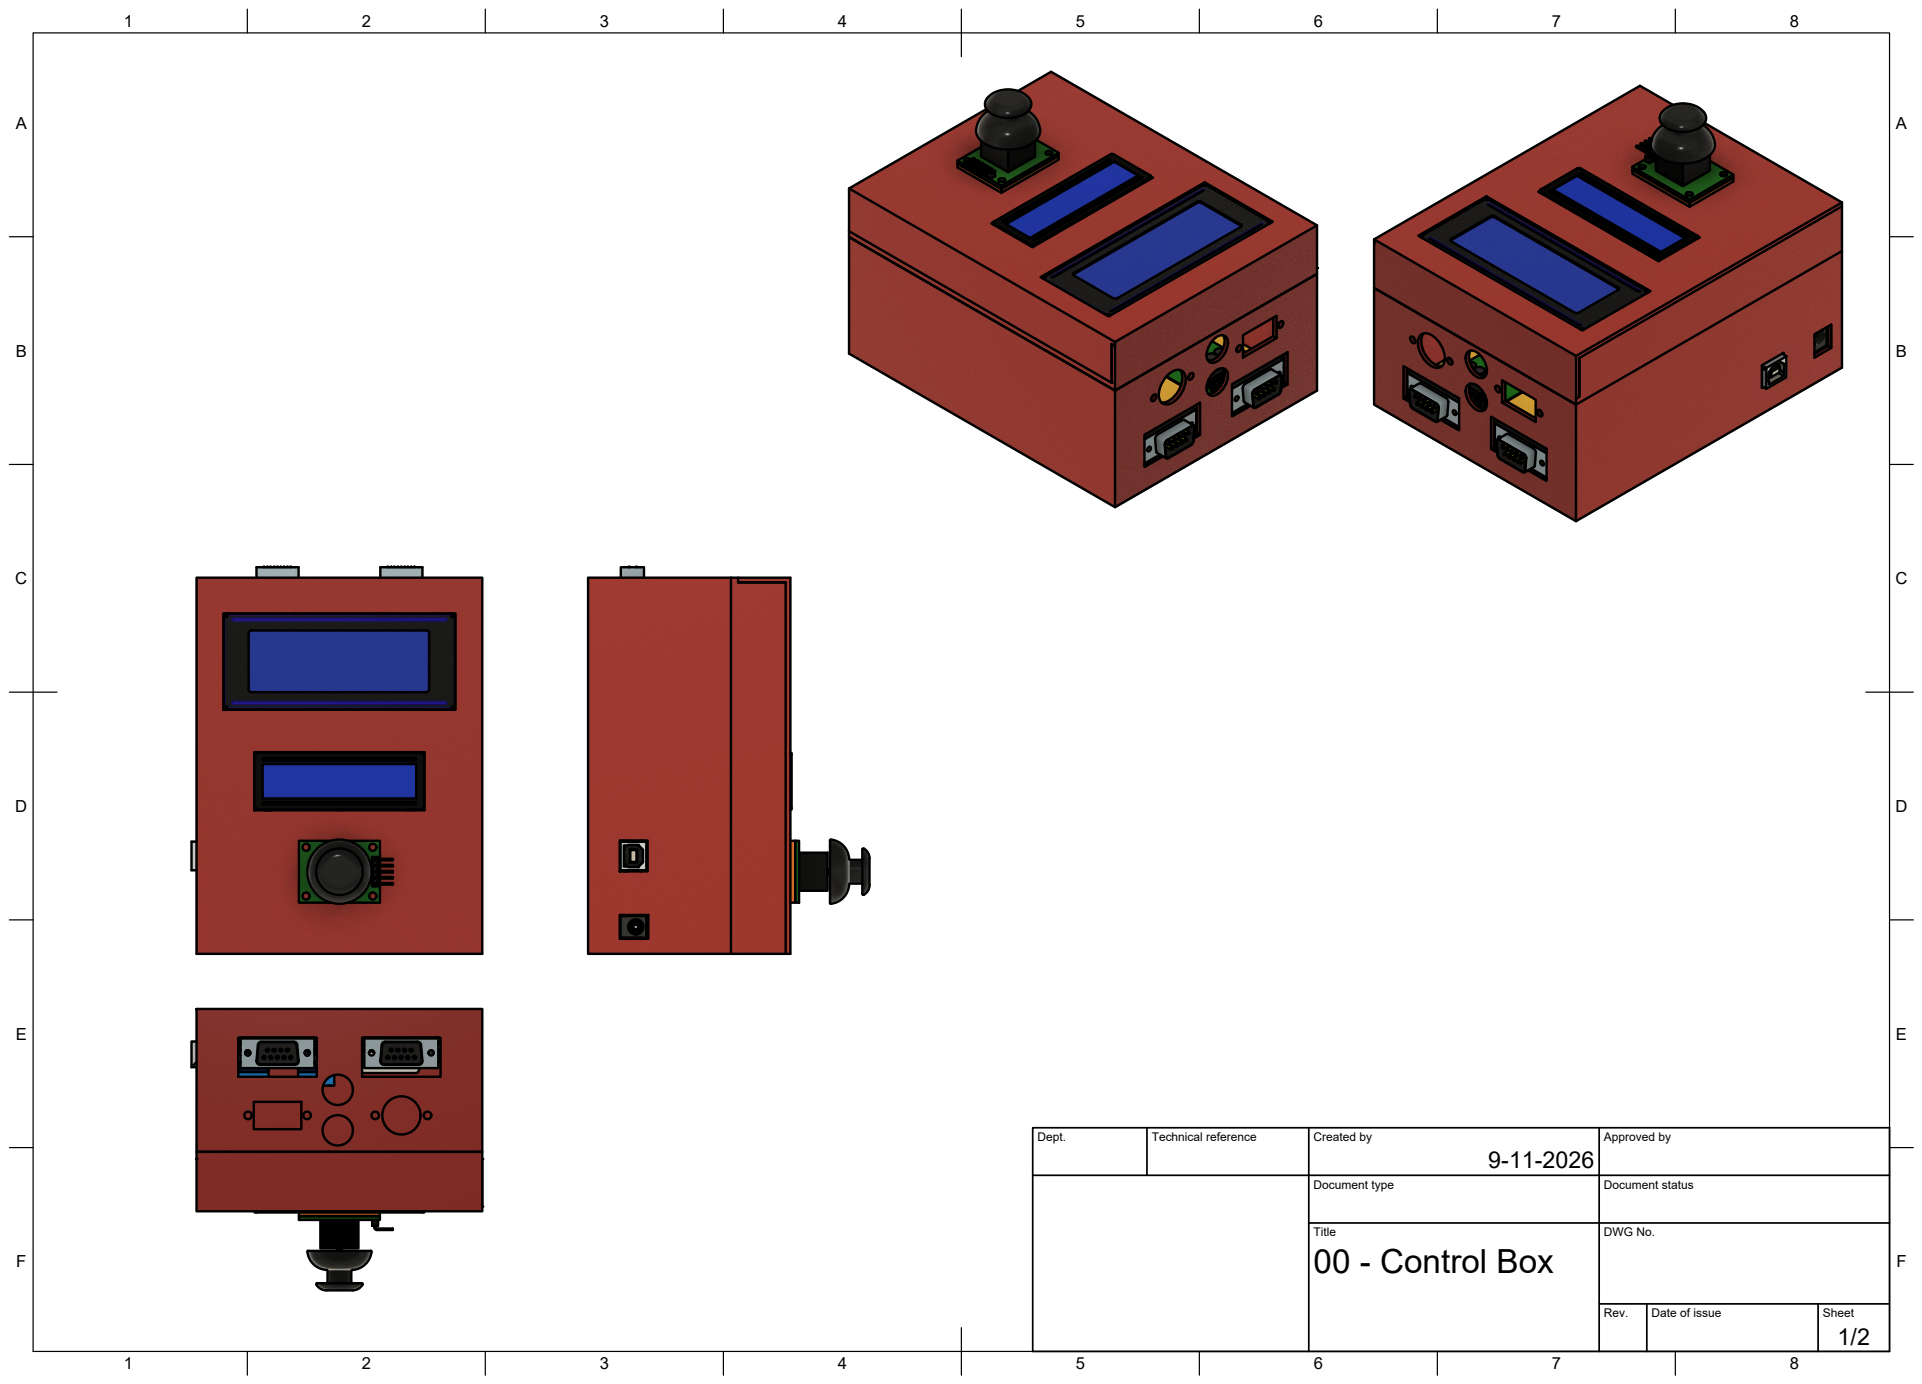
[picture p166: page 1]
Title; DWG No.; Rev.; Date of issue; Sheet; 00 - Control Box

Dept. | Technical reference | Created by 9-11-2026 | Approved by

Document type | Document status

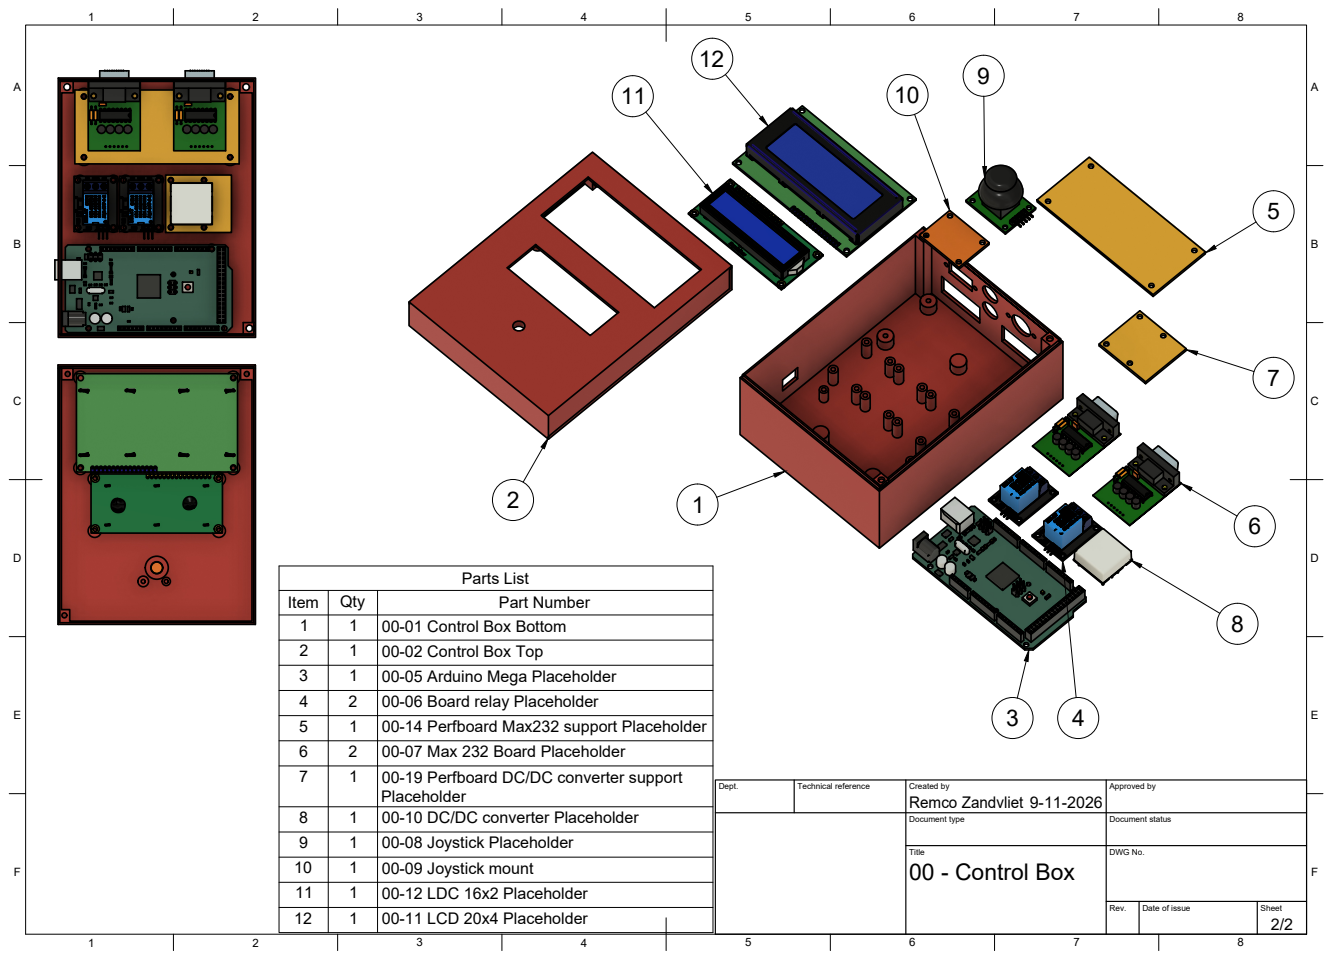
[picture p167: page 2]
Dept.; Technical reference; Created by; Approved by; Document type; Document status; Title; DWG No.; Rev.; Date of issue; Sheet; 00 - Control Box; Remco Zandvliet; Parts List; Item; Qty; Part Number; 00-01 Control Box Bottom; 00-02 Control Box Top; 00-05 Arduino Mega Placeholder; 00-06 Board relay Placeholder; 00-14 Perfboard Max232 support Placeholder; 00-07 Max 232 Board Placeholder; 00-19 Perfboard DC/DC converter support; 00-10 DC/DC converter Placeholder; 00-08 Joystick Placeholder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
