cryoTUD/optobot/modules/01_Blotting/assembly/01 Blotting Assembly Drawing.pdf

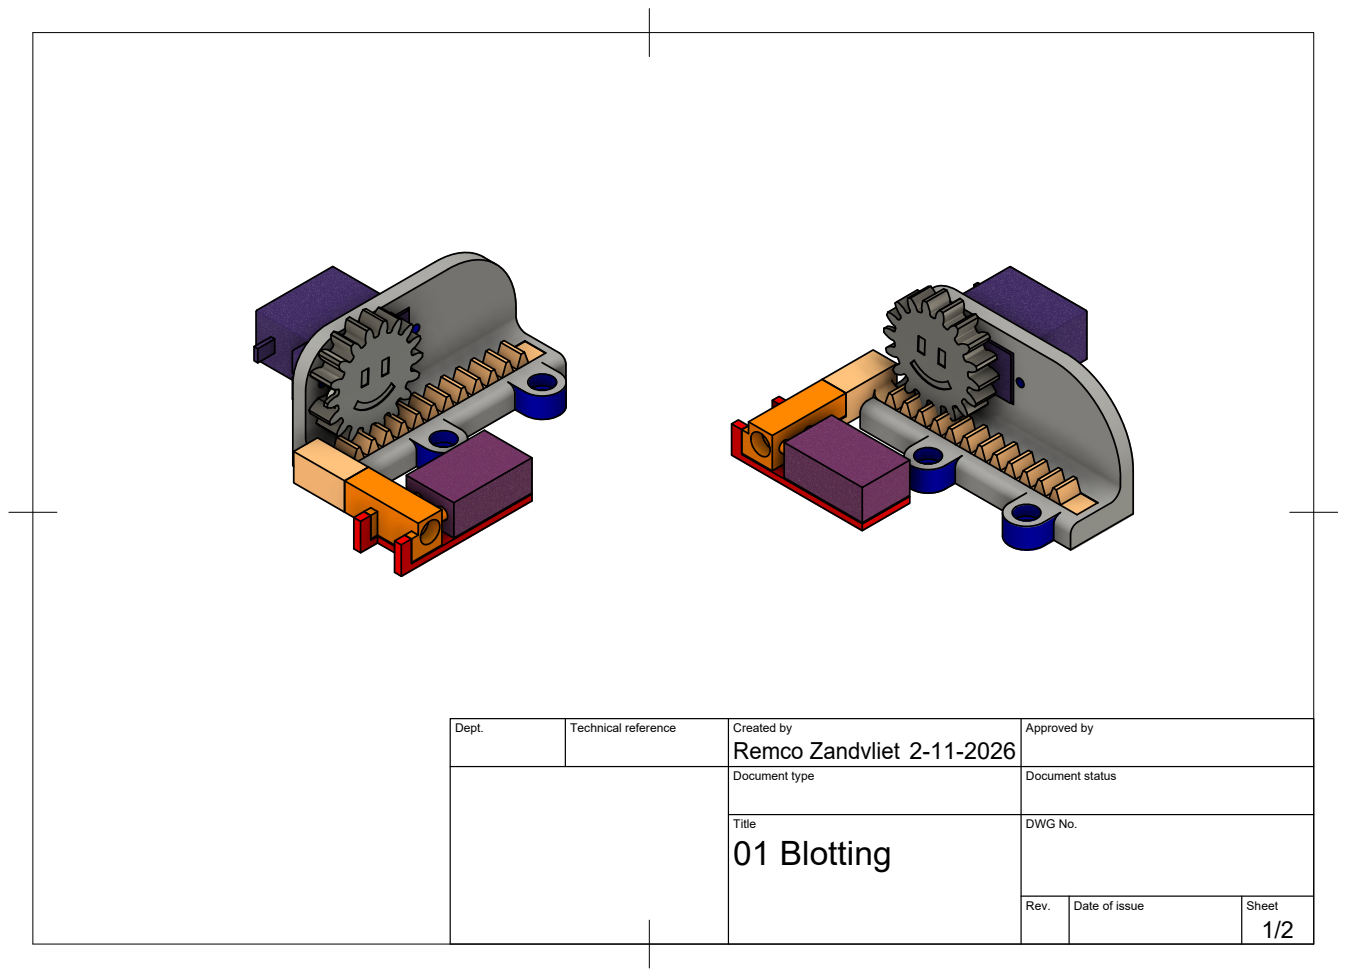
[picture p168: page 1]

Dept. | Technical reference | Created by Remco Zandvliet 2-11-2026 | Approved by

Document type | Document status

Title 01 Blotting | DWG No.

Rev. | Date of issue | Sheet 1/2

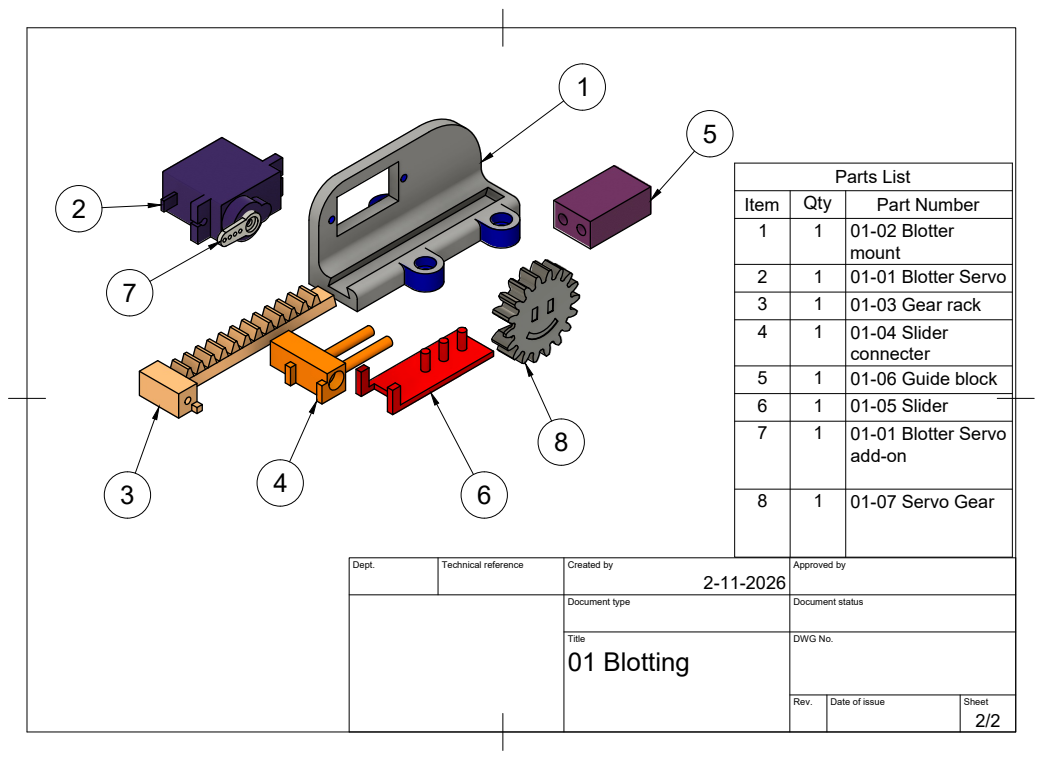
[picture p169: page 2]
Parts List

Item | Qty | Part Number
1 | 1 | 01-02 Blotter mount

2 | 1 | 01-01 Blotter Servo
3 | 1 | 01-03 Gear rack
4 | 1 | 01-04 Slider connecter

5 | 1 | 01-06 Guide block
6 | 1 | 01-05 Slider
7 | 1 | 01-01 Blotter Servo add-on

8 | 1 | 01-07 Servo Gear

Dept. | Technical reference | Created by 2-11-2026 | Approved by

Document type | Document status

Title 01 Blotting | DWG No.

Rev. | Date of issue | Sheet 2/2
