cryoTUD/optobot/modules/02_Climate_chamber/Assembly/02 Climate Chamber Assembly Drawing.pdf

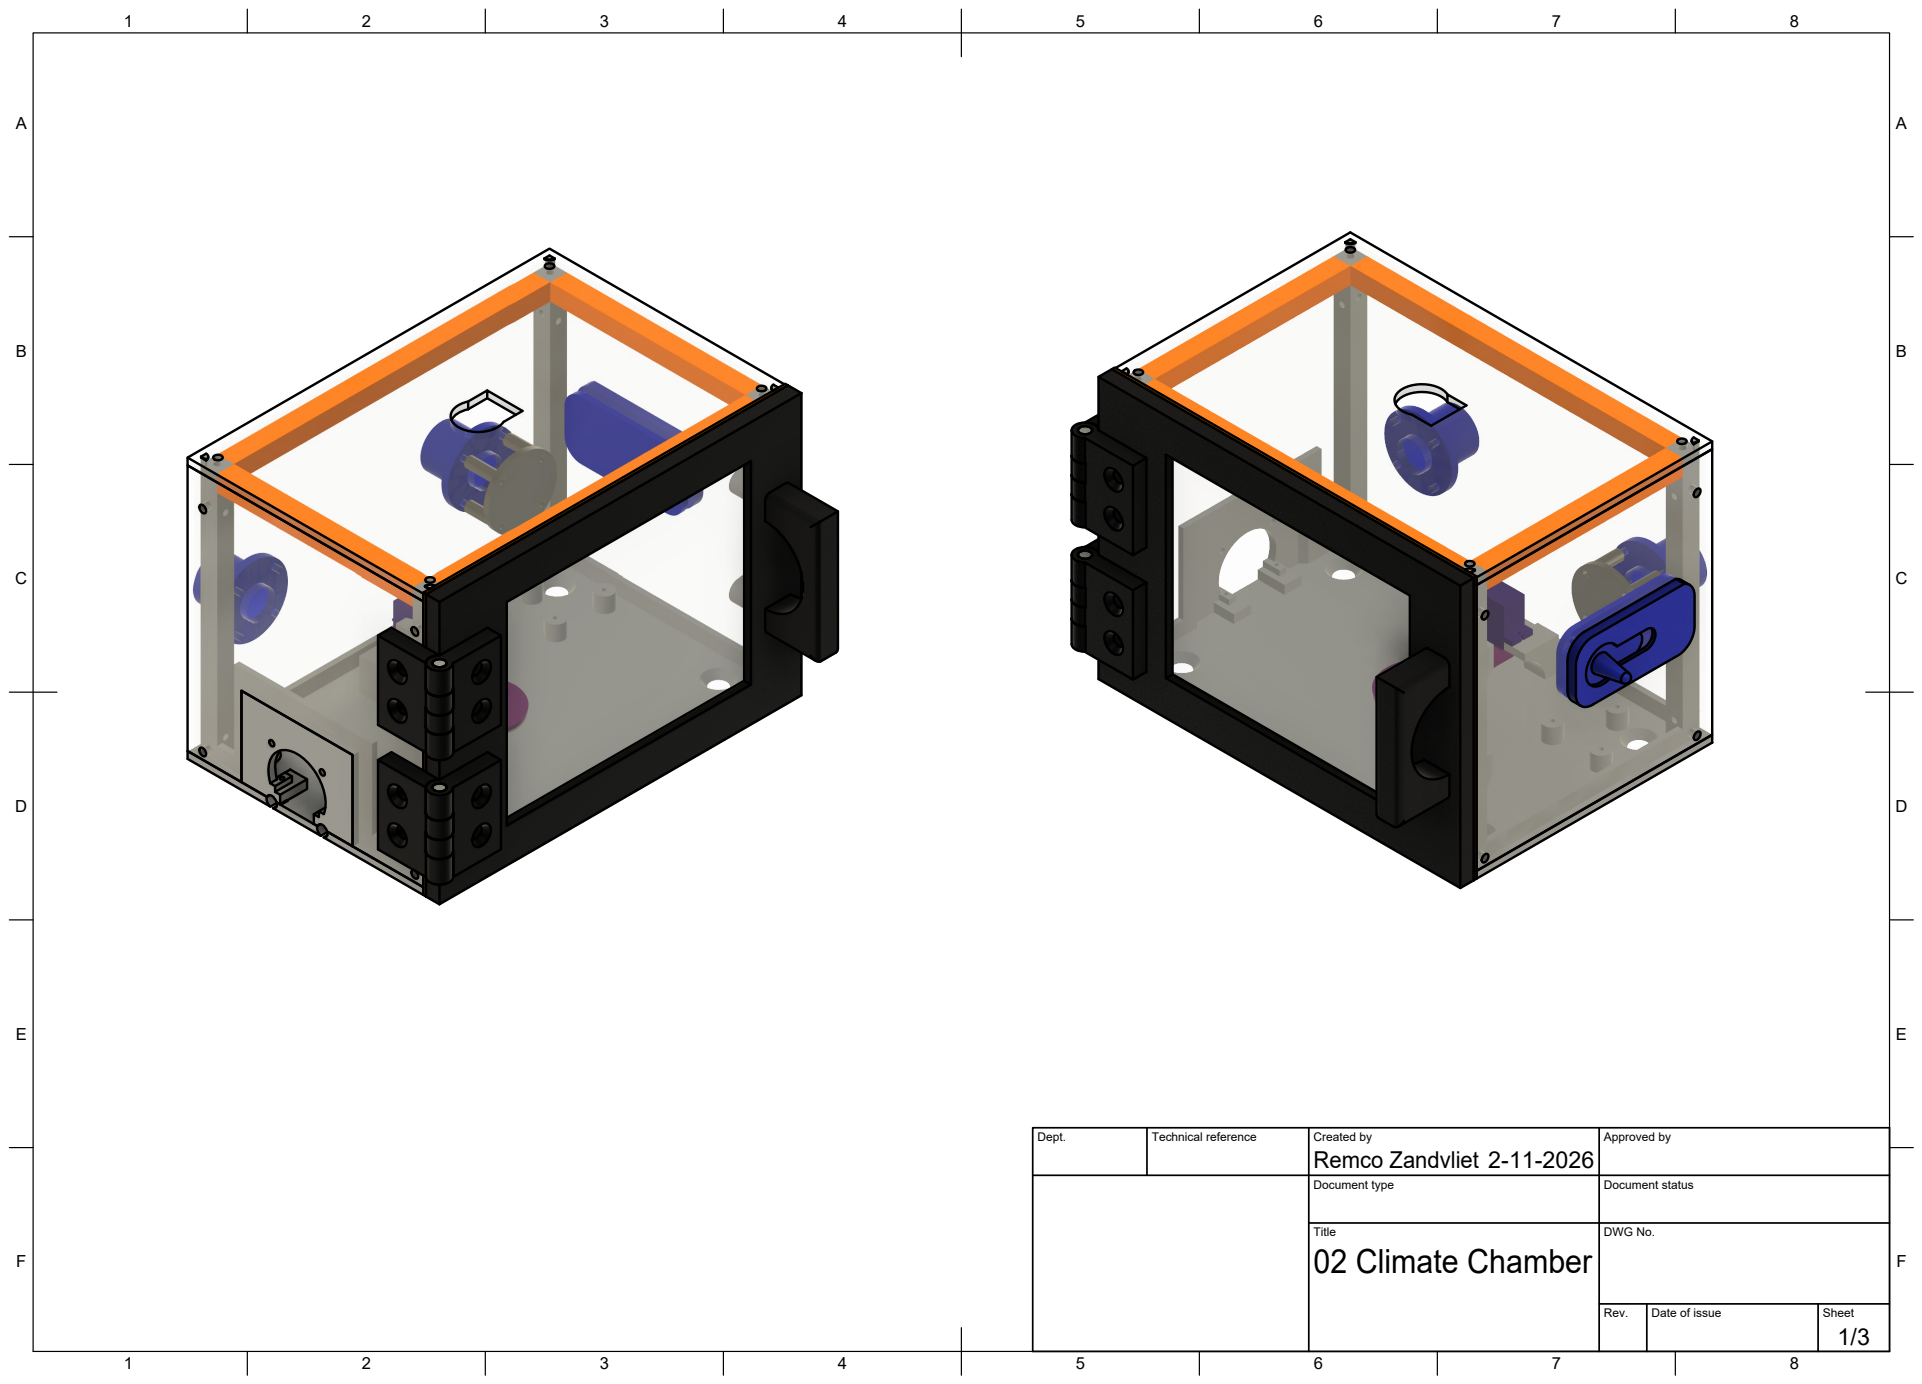
[picture p170: page 1]
Title; DWG No.; Rev.; Date of issue; Sheet; 02 Climate Chamber

Dept. | Technical reference | Created by Remco Zandvliet 2-11-2026 | Approved by

Document type | Document status

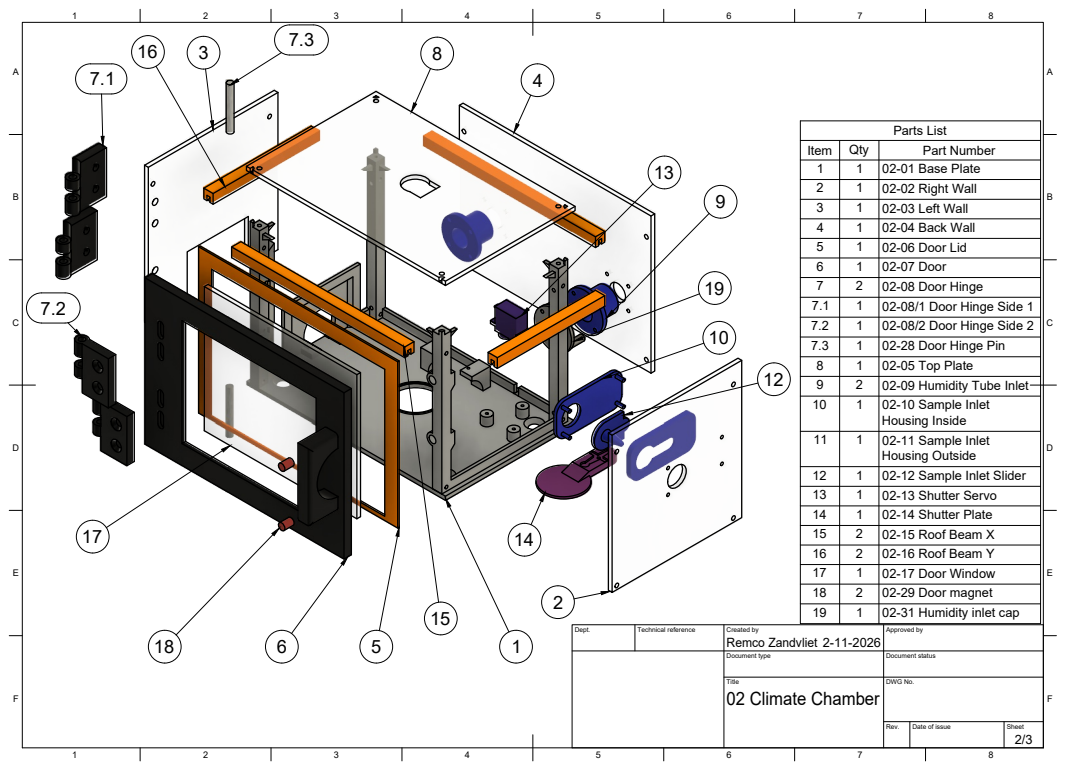
[picture p171: page 2]
8 BCDEF; ABCDEF; Title; DWG No.; 02 Climate Chamber; Parts List; Item; Qty; Part Number 1; 02-01 Base Plate 2; 02-02 Right Wall 3; 02-03 Left Wall 4; 02-04 Back Wall 5; 02-06 Door Lid 6; 02-07 Door 7; 02-08 Door Hinge; 02-28 Door Hinge Pin 8; 02-05 Top Plate 9; 02-09 Humidity Tube Inlet

7.1 | 1 | 02-08/1 Door Hinge Side 1
7.2 | 1 | 02-08/2 Door Hinge Side 2

10 | 1 | 02-10 Sample Inlet Housing Inside

11 | 1 | 02-11 Sample Inlet Housing Outside

12 | 1 | 02-12 Sample Inlet Slider
13 | 1 | 02-13 Shutter Servo
14 | 1 | 02-14 Shutter Plate
15 | 2 | 02-15 Roof Beam X
16 | 2 | 02-16 Roof Beam Y
17 | 1 | 02-17 Door Window
18 | 2 | 02-29 Door magnet
19 | 1 | 02-31 Humidity inlet cap

Dept. | Technical reference | Created by Remco Zandvliet 2-11-2026 | Approved by

Document type | Document status

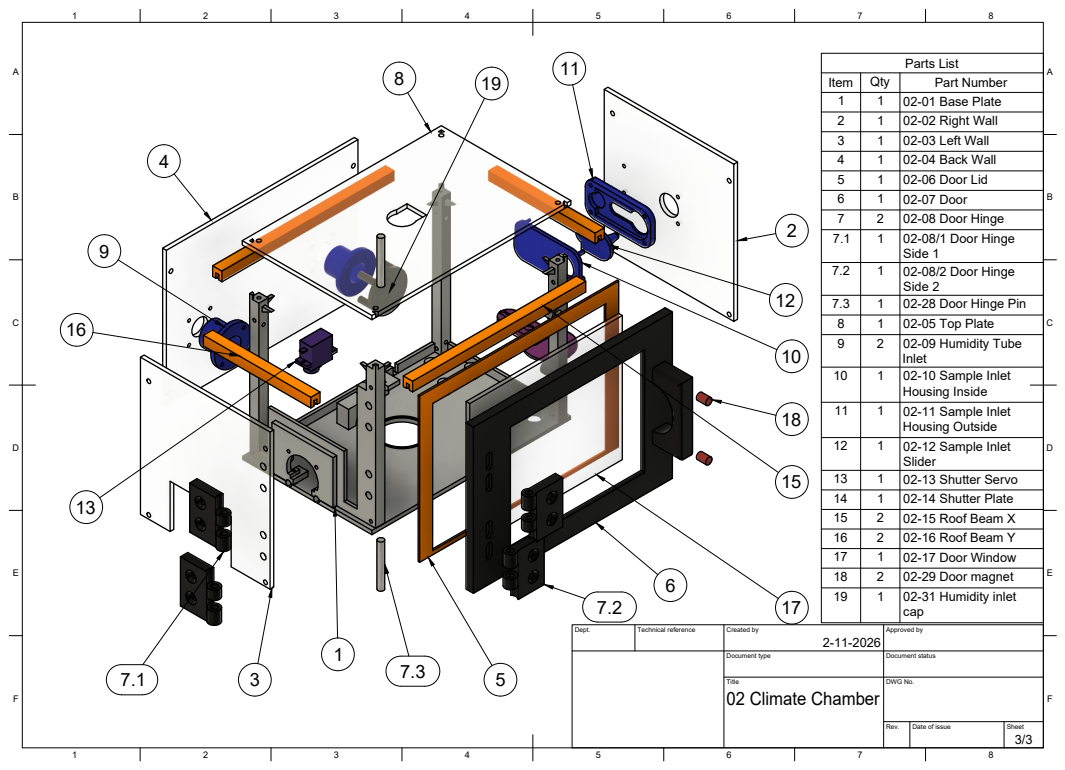
[picture p172: page 3]
8 BCDEF; ABCDEF; Parts List; Item; Qty; Part Number 1; 02-01 Base Plate 2; 02-02 Right Wall 3; 02-03 Left Wall 4; 02-04 Back Wall 5; 02-06 Door Lid 6; 02-07 Door 7; 02-08 Door Hinge; Title; DWG No.; 02 Climate Chamber

7.1 | 1 | 02-08/1 Door Hinge Side 1

7.2 | 1 | 02-08/2 Door Hinge Side 2

7.3 | 2 1 1 | 02-28 Door Hinge Pin 8 02-05 Top Plate 9 02-09 Humidity Tube

Inlet

10 | 1 | 02-10 Sample Inlet Housing Inside

11 | 1 | 02-11 Sample Inlet Housing Outside

12 | 1 | 02-12 Sample Inlet Slider

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

Dept. | Technical reference | Created by 2-11-2026 | Approved by

Document type | Document status
