cryoTUD/optobot/modules/02_Climate_chamber/Assembly/02.1 Humidifier Assembly Drawing.pdf

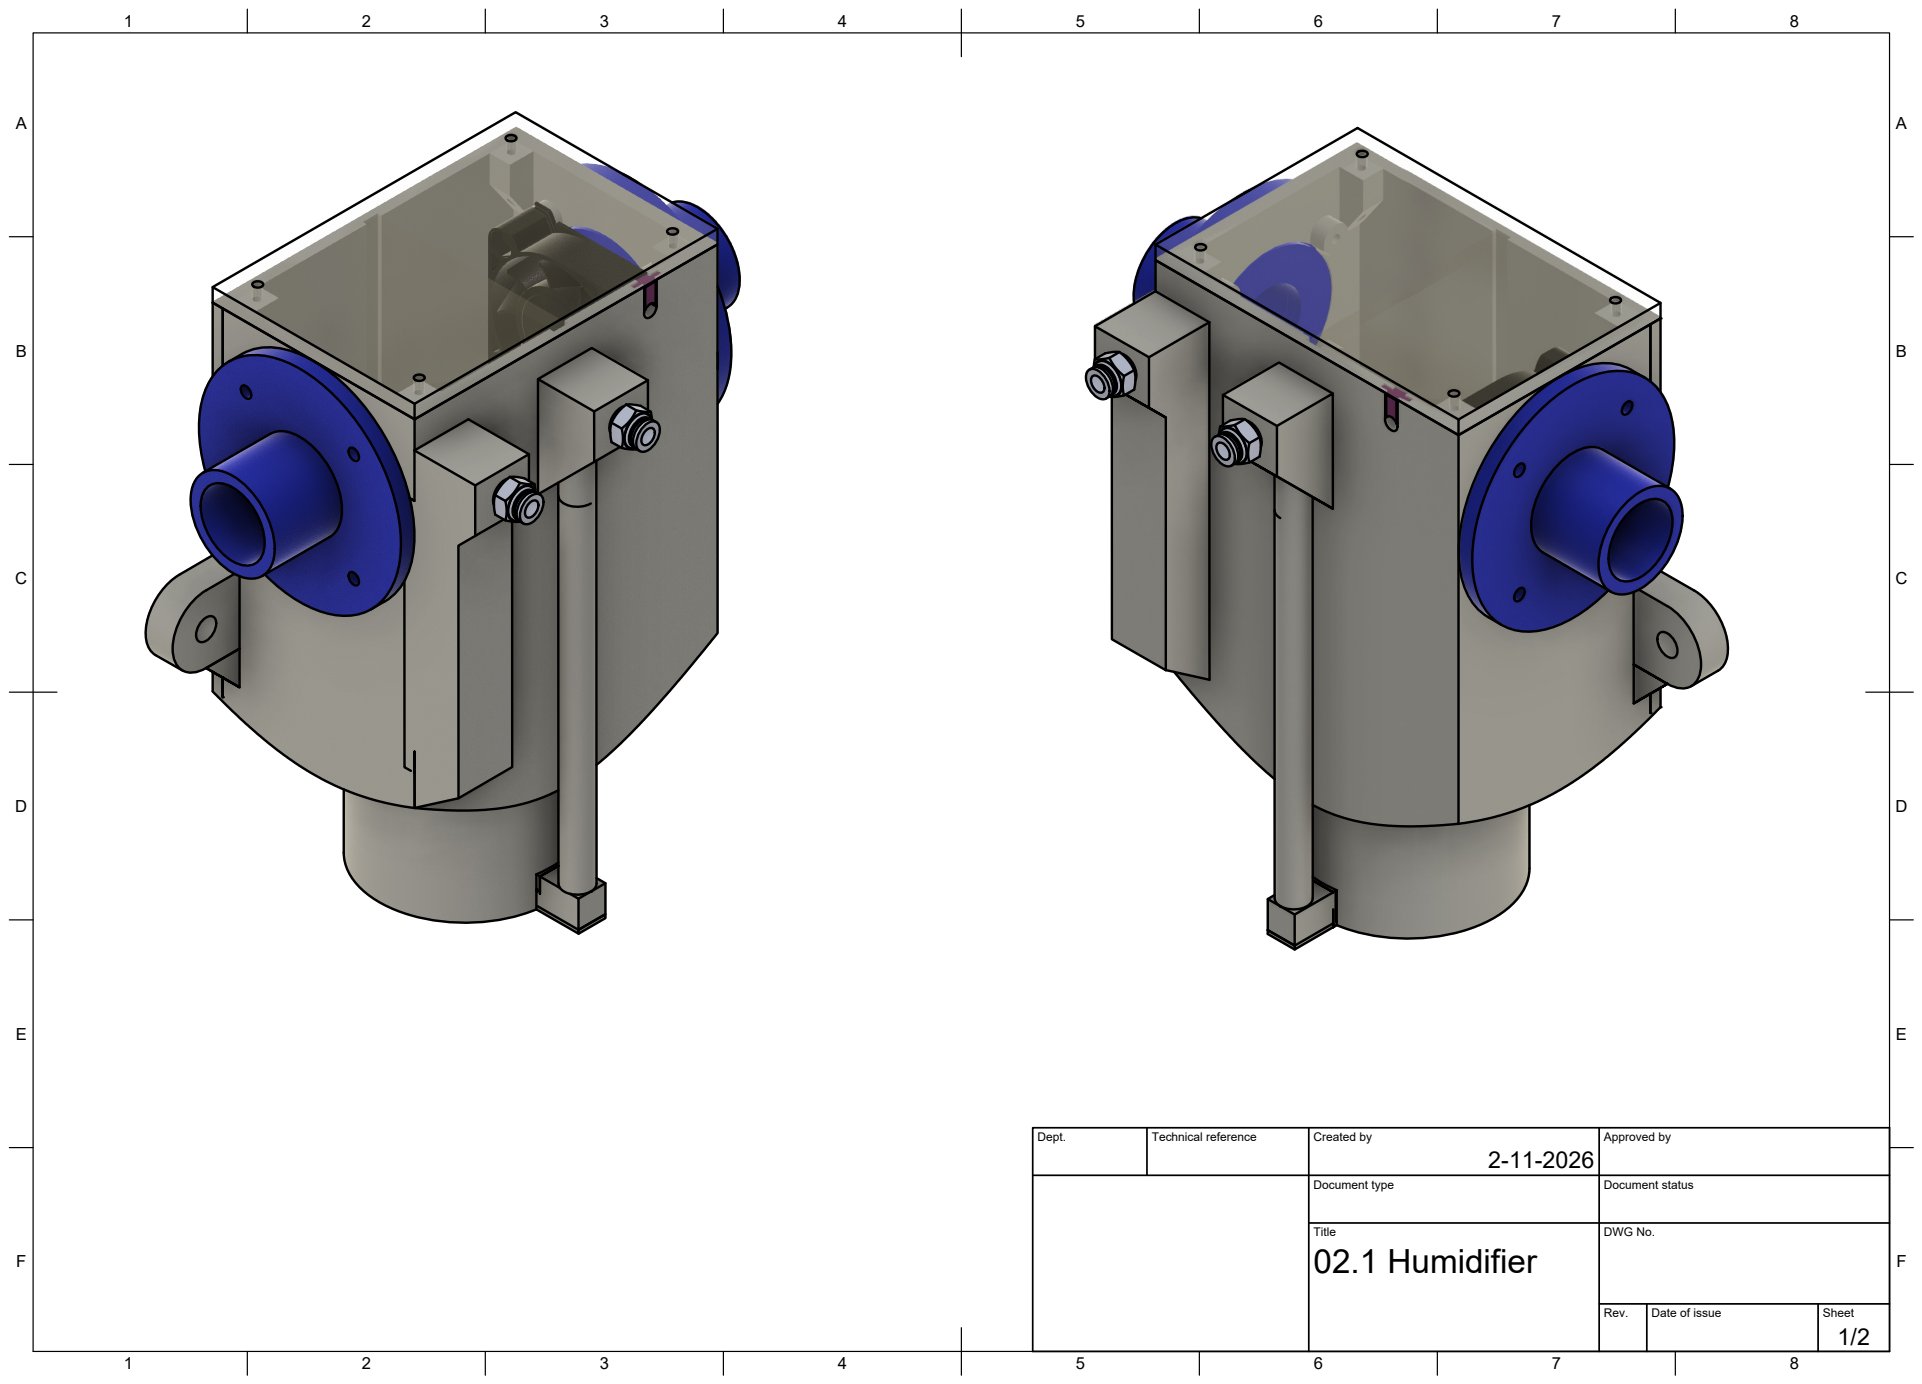
[picture p173: page 1]
Title; DWG No.; Rev.; Date of issue; Sheet; 02.1 Humidifier

Dept. | Technical reference | Created by 2-11-2026 | Approved by

Document type | Document status

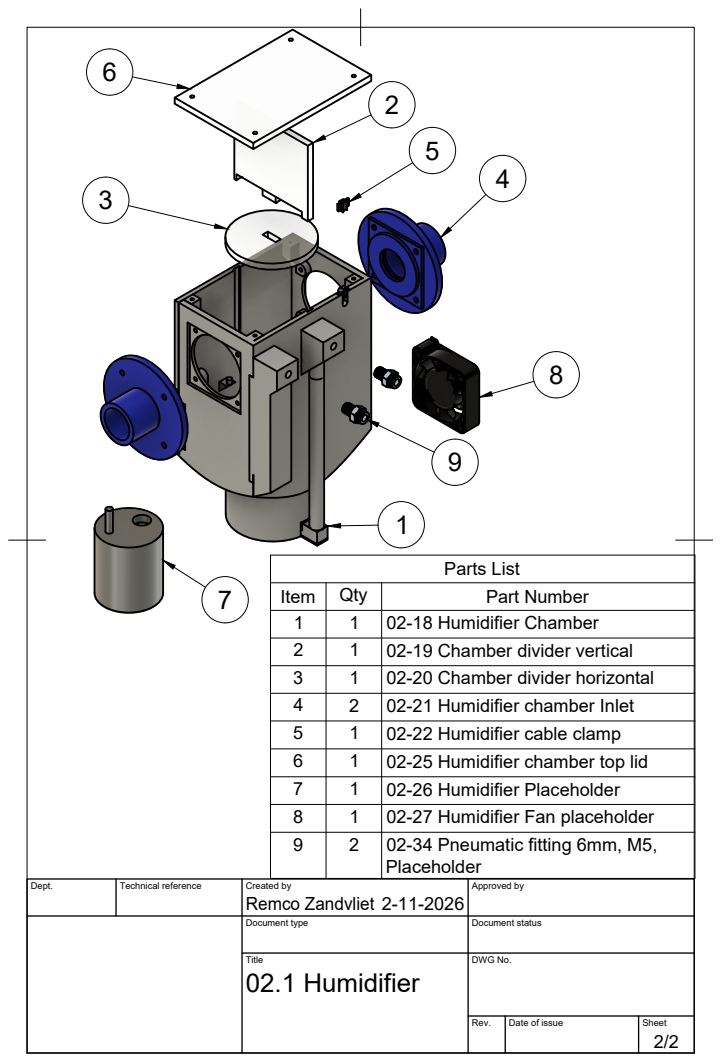
[picture p174: page 2]
Parts List

Item | Qty | Part Number
1 | 1 | 02-18 Humidifier Chamber
2 | 1 | 02-19 Chamber divider vertical
3 | 1 | 02-20 Chamber divider horizontal
4 | 2 | 02-21 Humidifier chamber Inlet
5 | 1 | 02-22 Humidifier cable clamp
6 | 1 | 02-25 Humidifier chamber top lid
7 | 1 | 02-26 Humidifier Placeholder
8 | 1 | 02-27 Humidifier Fan placeholder
9 | 2 | 02-34 Pneumatic fitting 6mm, M5, Placeholder

Dept. | Technical reference | Created by Remco Zandvliet 2-11-2026 | Approved by

Document type | Document status

Title 02.1 Humidifier | DWG No.

Rev. | Date of issue | Sheet 2/2
