cryoTUD/optobot/modules/02_Climate_chamber/Assembly/02.2 Reservoir assembly Drawing.pdf

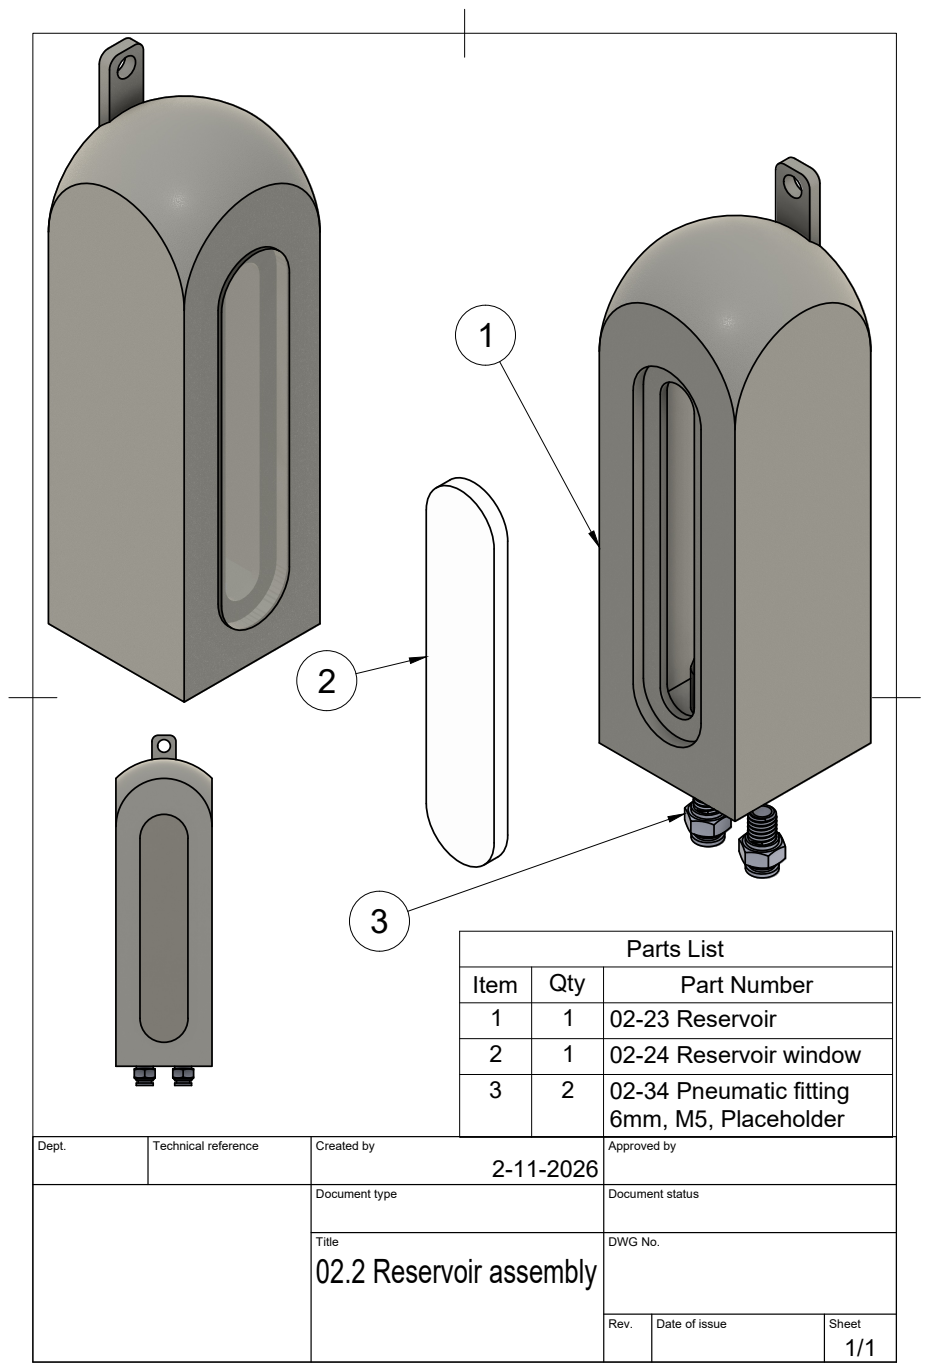
[picture p175: page 1]
Parts List

Item | Qty | Part Number
1 | 1 | 02-23 Reservoir
2 | 1 | 02-24 Reservoir window
3 | 2 | 02-34 Pneumatic fitting 6mm, M5, Placeholder

Dept. | Technical reference | Created by 2-11-2026 | Approved by

Document type | Document status

Title 02.2 Reservoir assembly | DWG No.

Rev. | Date of issue | Sheet 1/1
