cryoTUD/optobot/modules/02_Climate_chamber/Assembly/02.3 Valve assembly Drawing.pdf

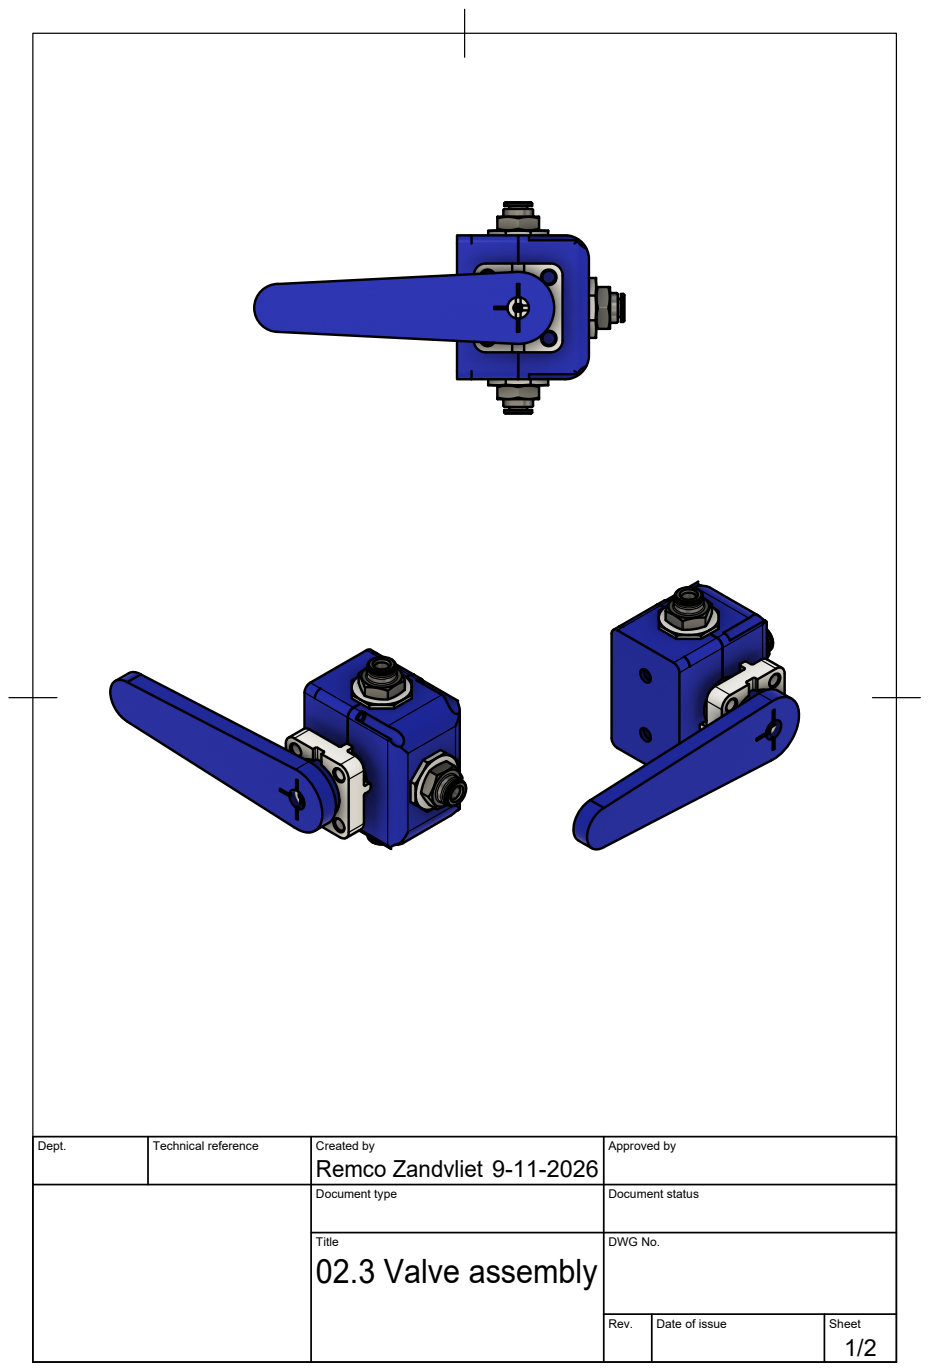
[picture p176: page 1]

Dept. | Technical reference | Created by Remco Zandvliet 9-11-2026 | Approved by

Document type | Document status

Title 02.3 Valve assembly | DWG No.

Rev. | Date of issue | Sheet 1/2

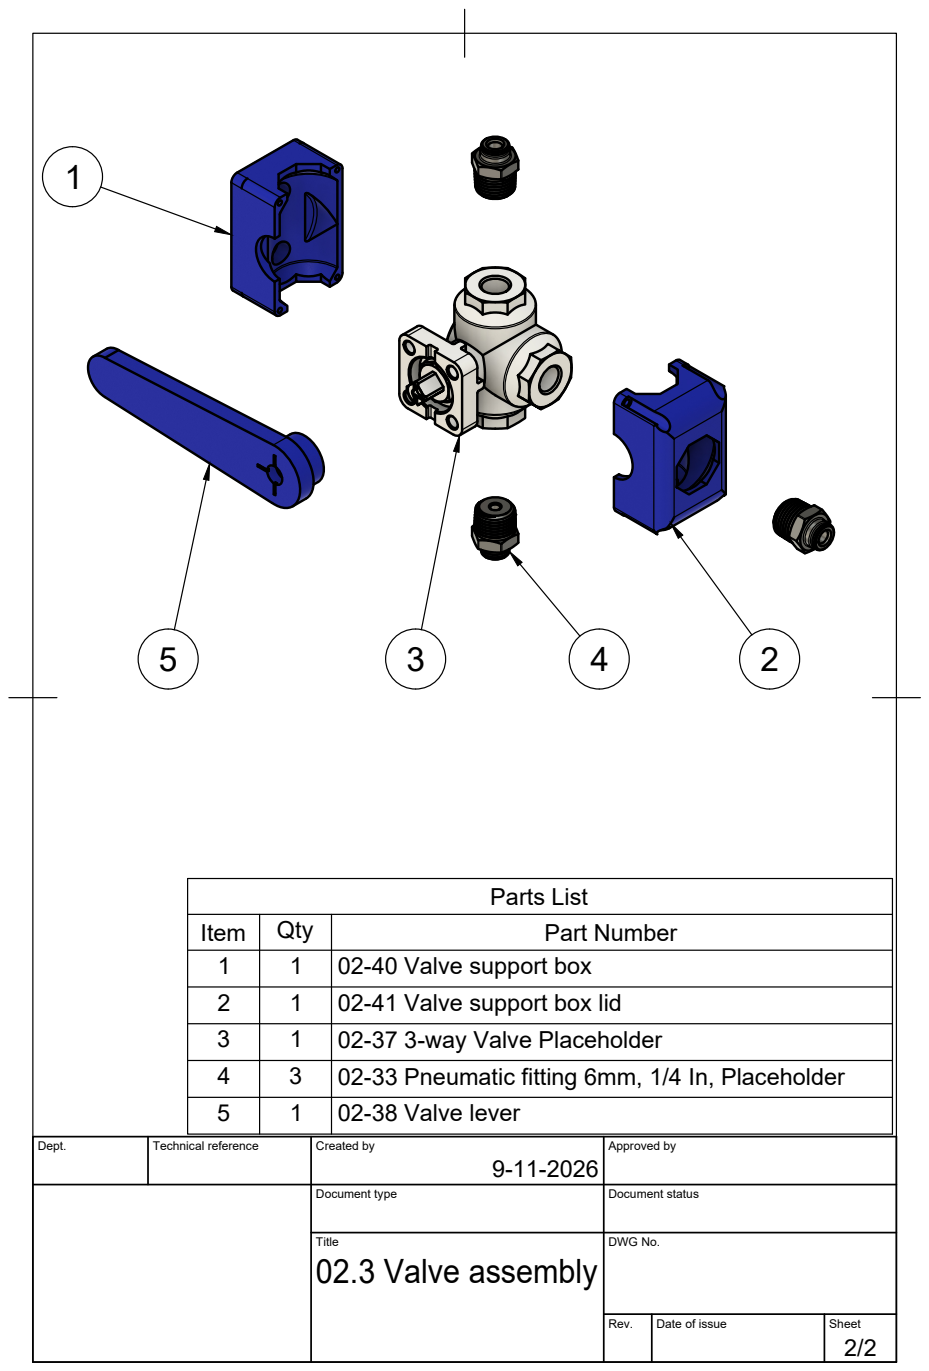
[picture p177: page 2]
Parts List

Item | Qty | Part Number
1 | 1 | 02-40 Valve support box
2 | 1 | 02-41 Valve support box lid
3 | 1 | 02-37 3-way Valve Placeholder
4 | 3 | 02-33 Pneumatic fitting 6mm, 1/4 In, Placeholder
5 | 1 | 02-38 Valve lever

Dept. | Technical reference | Created by 9-11-2026 | Approved by

Document type | Document status

Title 02.3 Valve assembly | DWG No.

Rev. | Date of issue | Sheet 2/2
