cryoTUD/optobot/modules/03_Led/Assembly/03 Lens Mount Assembly Drawing.pdf

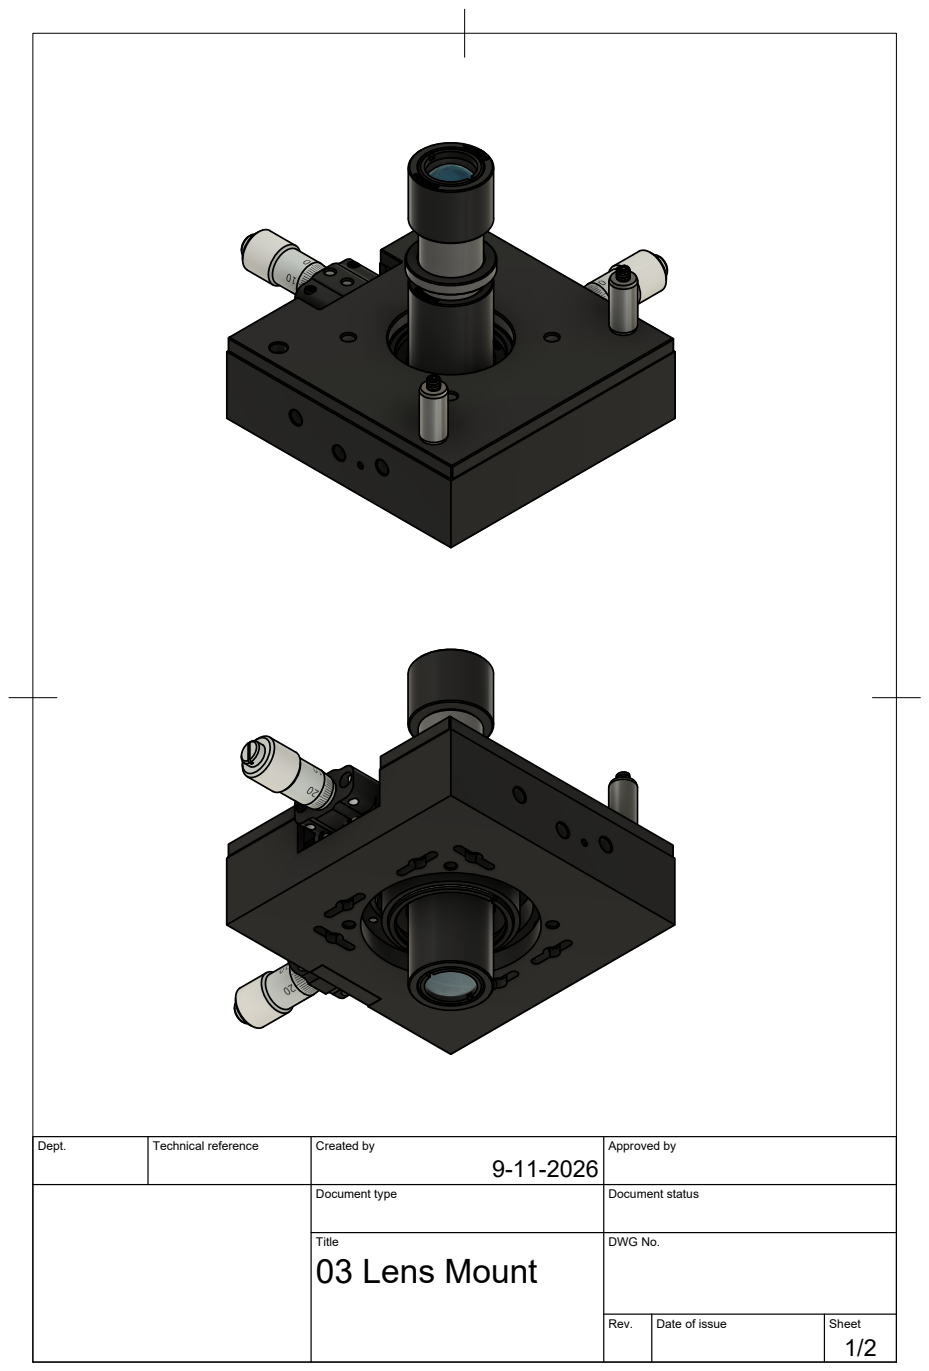
[picture p178: page 1]

Dept. | Technical reference | Created by 9-11-2026 | Approved by

Document type | Document status

Title 03 Lens Mount | DWG No.

Rev. | Date of issue | Sheet 1/2

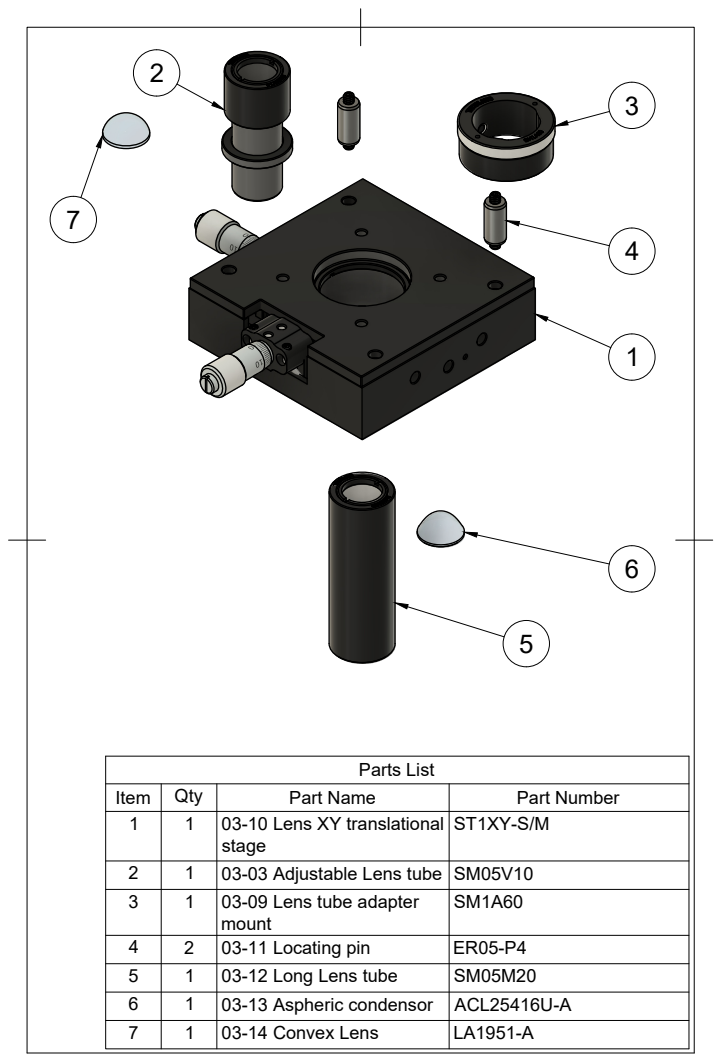
[picture p179: page 2]
Parts List

Item | Qty | Part Name | Part Number
1 | 1 | 03-10 Lens XY translational stage | ST1XY-S/M

2 | 1 | 03-03 Adjustable Lens tube | SM05V10
3 | 1 | 03-09 Lens tube adapter mount | SM1A60

4 | 2 | 03-11 Locating pin | ER05-P4
5 | 1 | 03-12 Long Lens tube | SM05M20
6 | 1 | 03-13 Aspheric condensor | ACL25416U-A
7 | 1 | 03-14 Convex Lens | LA1951-A
