cryoTUD/optobot/modules/04_Plunger_motor/Assembly/04 - Plunger motor Assembly Drawing.pdf

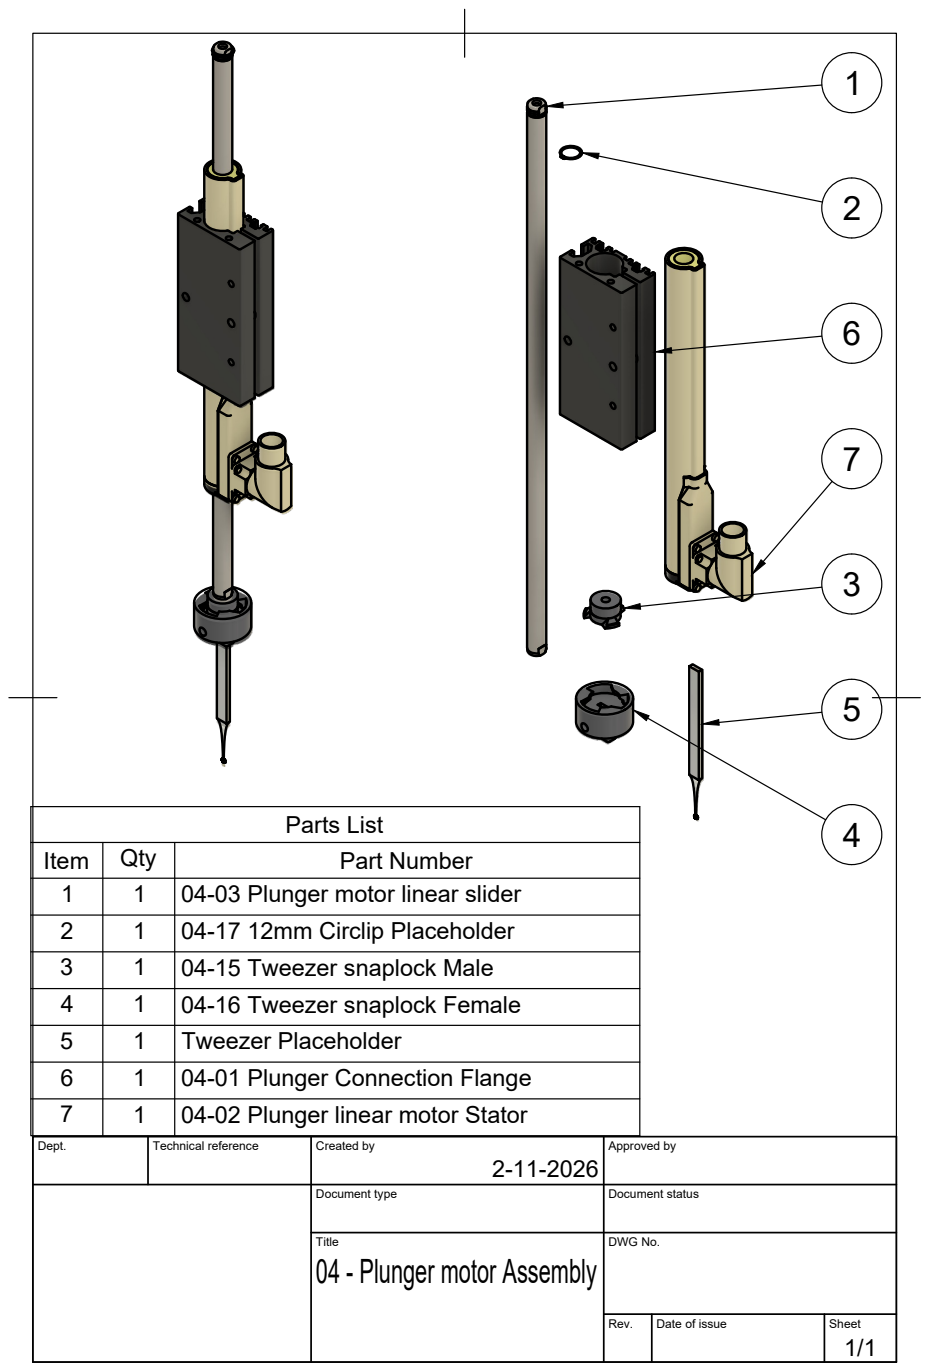
[picture p182: page 1]
Parts List

Item | Qty | Part Number
1 | 1 | 04-03 Plunger motor linear slider
2 | 1 | 04-17 12mm Circlip Placeholder
3 | 1 | 04-15 Tweezer snaplock Male
4 | 1 | 04-16 Tweezer snaplock Female
5 | 1 | Tweezer Placeholder
6 | 1 | 04-01 Plunger Connection Flange
7 | 1 | 04-02 Plunger linear motor Stator

Dept. | Technical reference | Created by 2-11-2026 | Approved by

Document type | Document status

Title 04 - Plunger motor Assembly | DWG No.

Rev. | Date of issue | Sheet 1/1
