cryoTUD/optobot/modules/05_Temperature_controlled_cup/assembly/05 Temperature-controlled cup Assembly Drawing.pdf

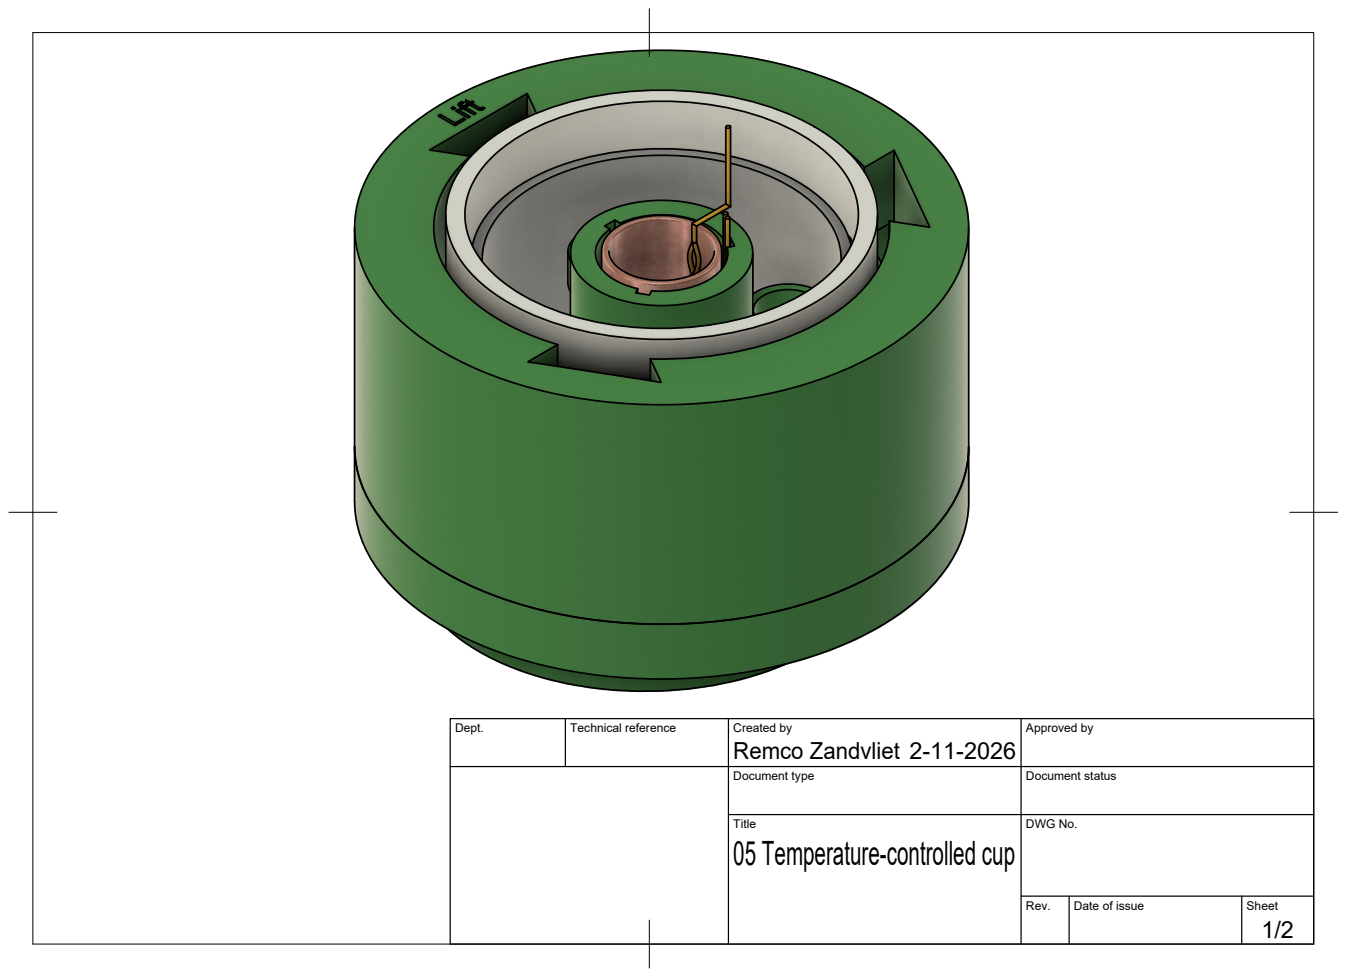
[picture p183: page 1]

Dept. | Technical reference | Created by Remco Zandvliet 2-11-2026 | Approved by

Document type | Document status

Title 05 Temperature-controlled cup | DWG No.

Rev. | Date of issue | Sheet 1/2

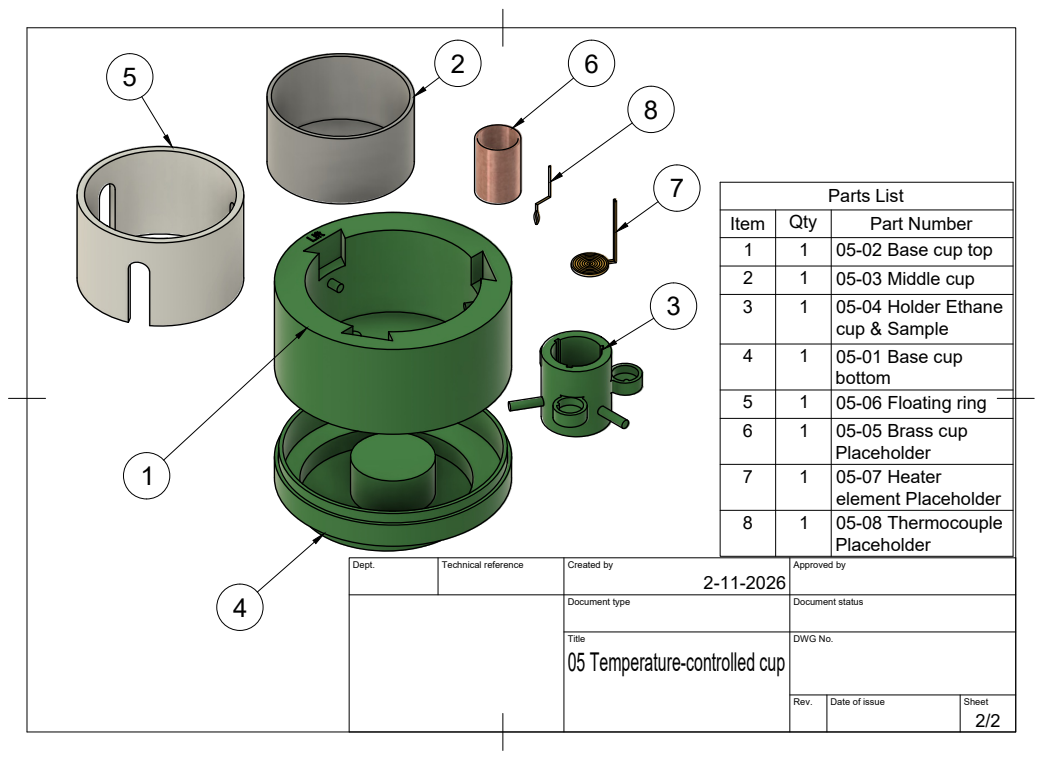
[picture p184: page 2]
Parts List

Item | Qty | Part Number
1 | 1 | 05-02 Base cup top
2 | 1 | 05-03 Middle cup
3 | 1 | 05-04 Holder Ethane cup & Sample

4 | 1 | 05-01 Base cup bottom

5 | 1 | 05-06 Floating ring
6 | 1 | 05-05 Brass cup Placeholder

7 | 1 | 05-07 Heater element Placeholder

8 | 1 | 05-08 Thermocouple Placeholder

Dept. | Technical reference | Created by 2-11-2026 | Approved by

Document type | Document status

Title 05 Temperature-controlled cup | DWG No.

Rev. | Date of issue | Sheet 2/2
