cryoTUD/optobot/modules/00_Electronics/Assembly/00.1 PID Box/00.1 PID Box Assembly Drawing.pdf

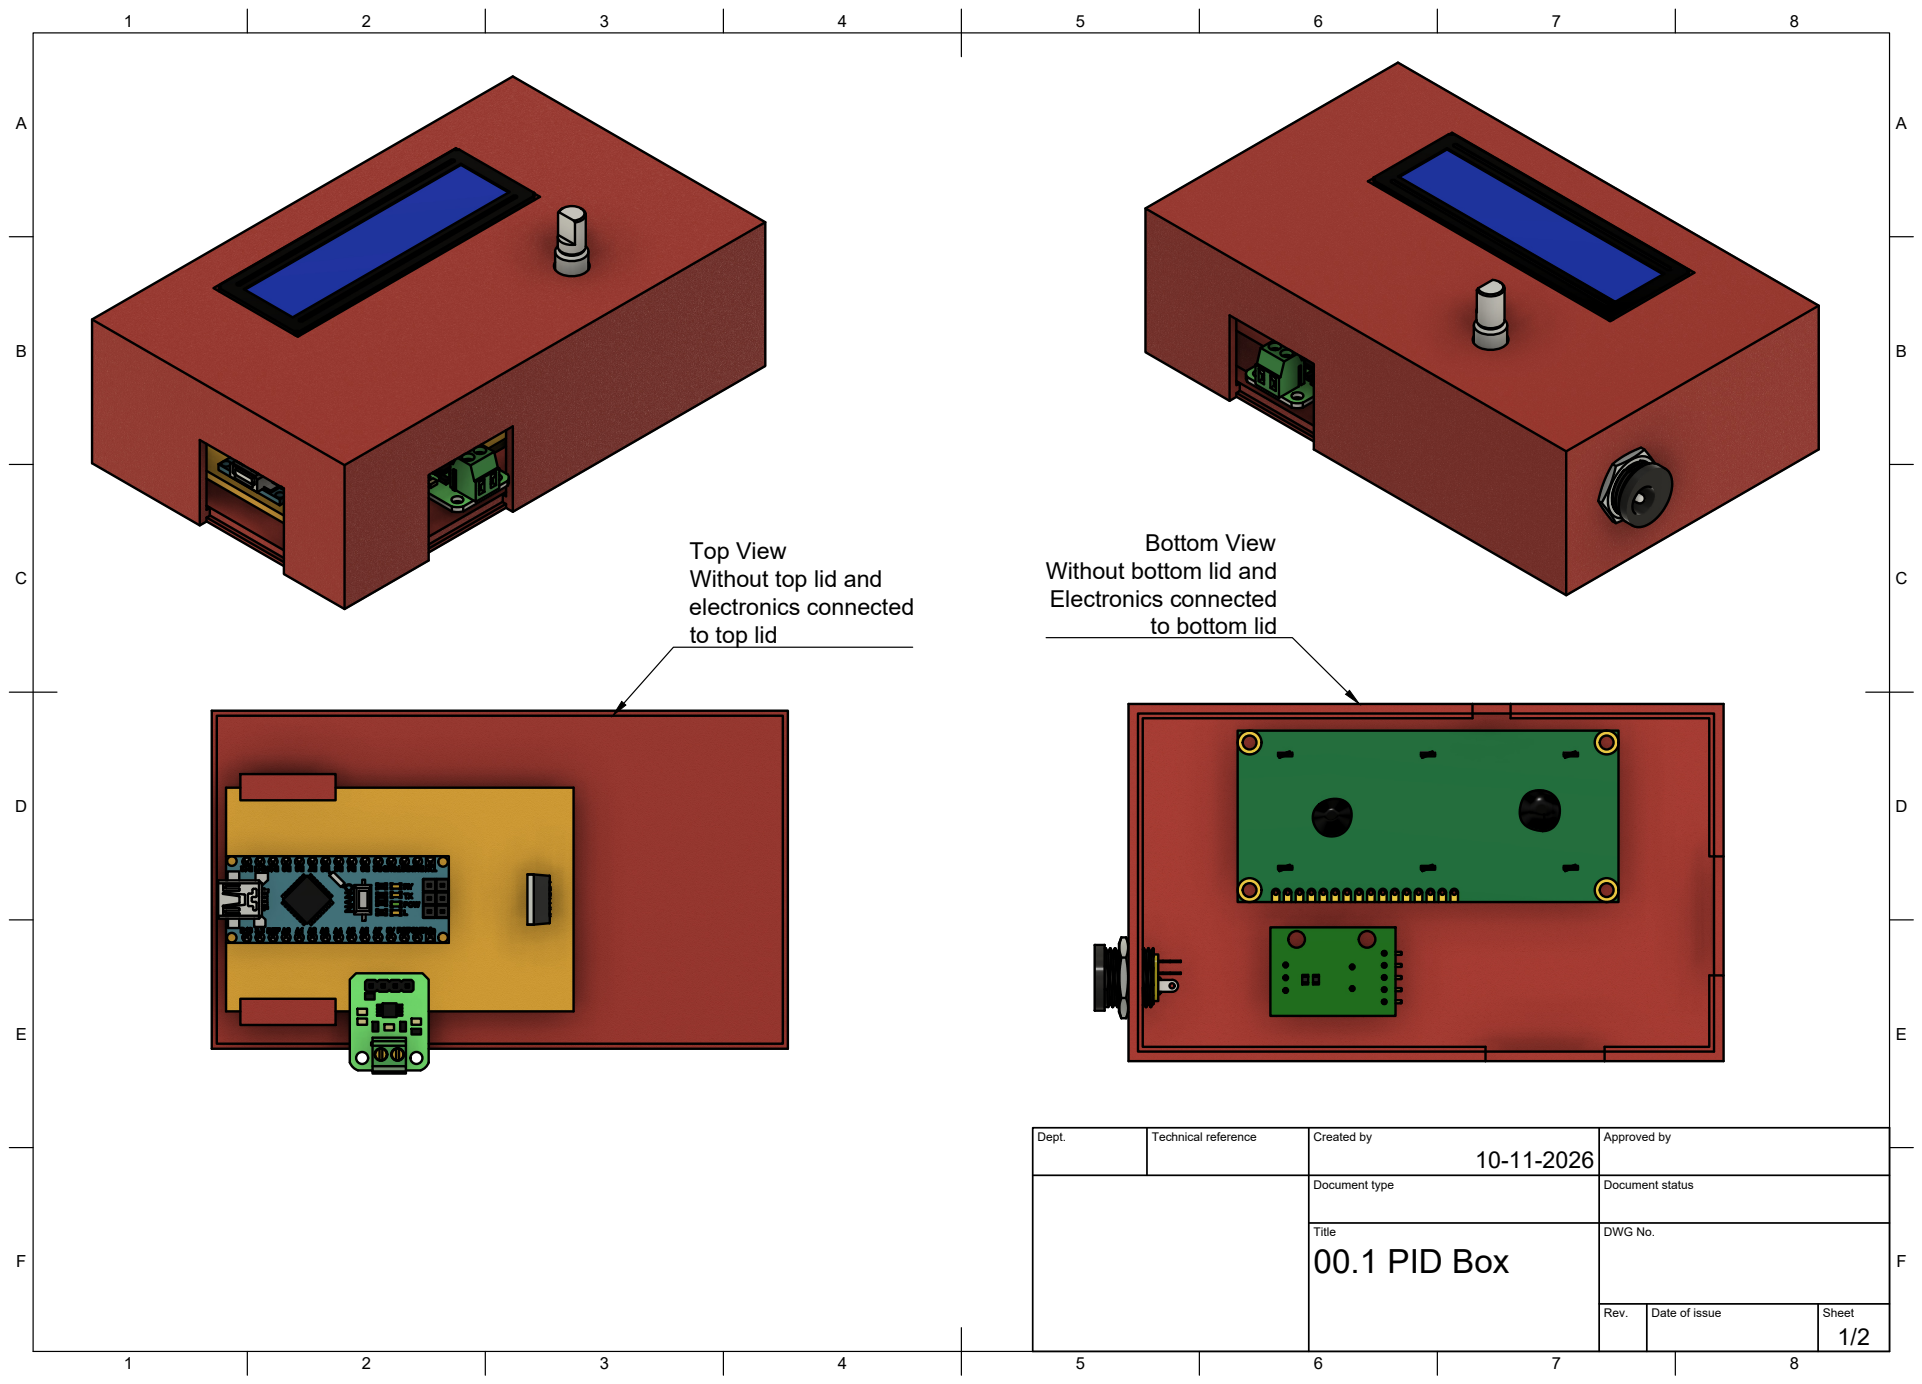
[picture p185: page 1]
Bottom View; Title; DWG No.; Rev.; Date of issue; Sheet; 00.1 PID Box

Top View
Without top lid and
electronics connected
to top lid

Without bottom lid and
Electronics connected

to bottom lid

Dept. | Technical reference | Created by 10-11-2026 | Approved by

Document type | Document status

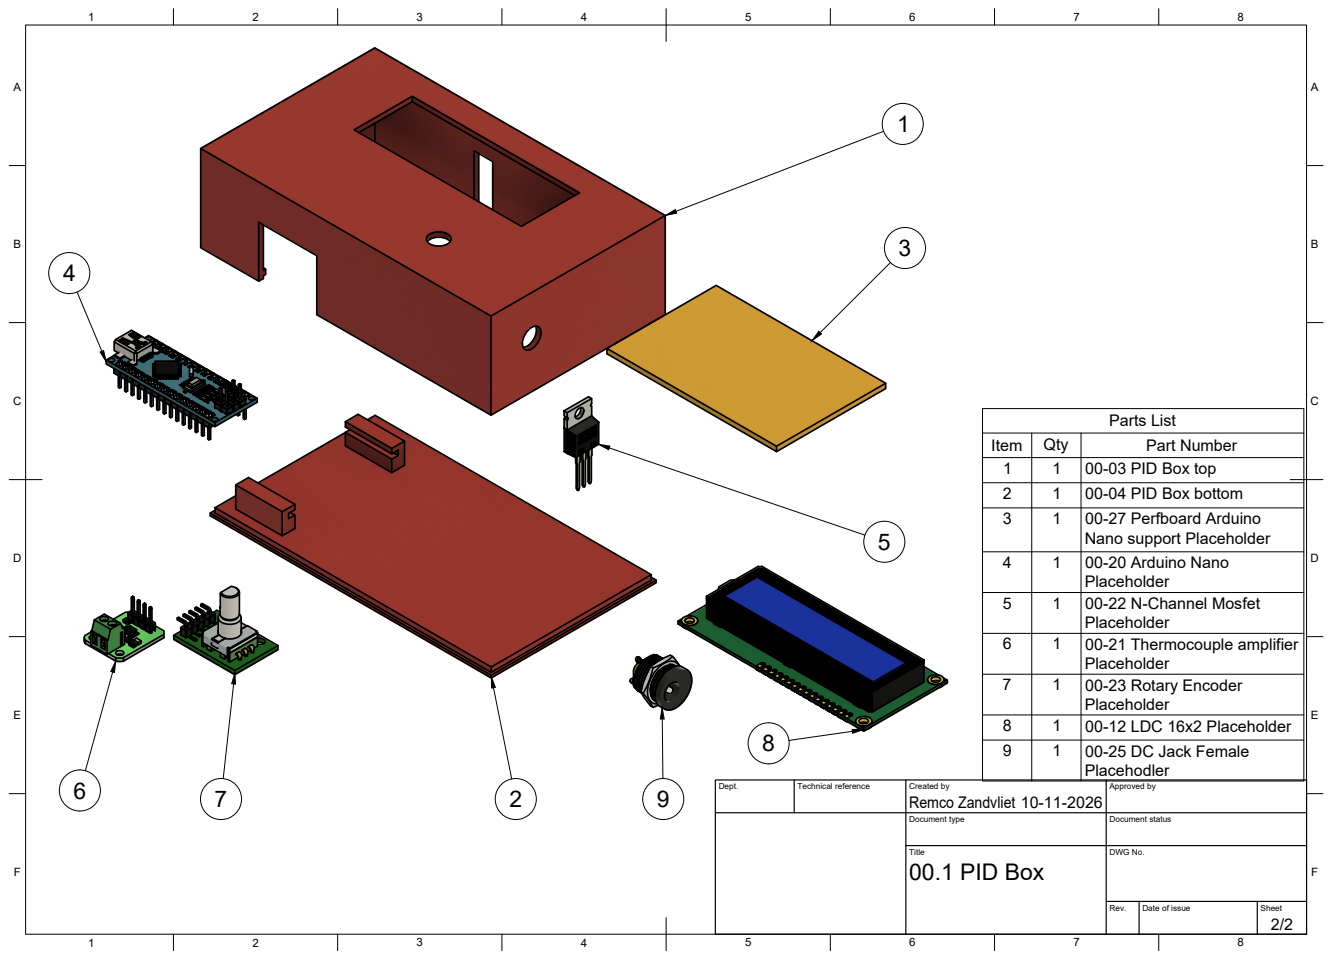
[picture p186: page 2]
Title; DWG No.; Rev.; Date of issue; Sheet; 00.1 PID Box; Parts List

Item | Qty | Part Number
1 | 1 | 00-03 PID Box top
2 | 1 | 00-04 PID Box bottom
3 | 1 | 00-27 Perfboard Arduino Nano support Placeholder

4 | 1 | 00-20 Arduino Nano Placeholder

5 | 1 | 00-22 N-Channel Mosfet Placeholder

6 | 1 | 00-21 Thermocouple amplifier Placeholder

7 | 1 | 00-23 Rotary Encoder Placeholder

8 | 1 | 00-12 LDC 16x2 Placeholder
9 | 1 | 00-25 DC Jack Female Placehodler

Dept. | Technical reference | Created by Remco Zandvliet 10-11-2026 | Approved by

Document type | Document status
