cryoTUD/optobot/modules/05_Temperature_controlled_cup/Production drawings/05-06 Floating ring Drawing.pdf

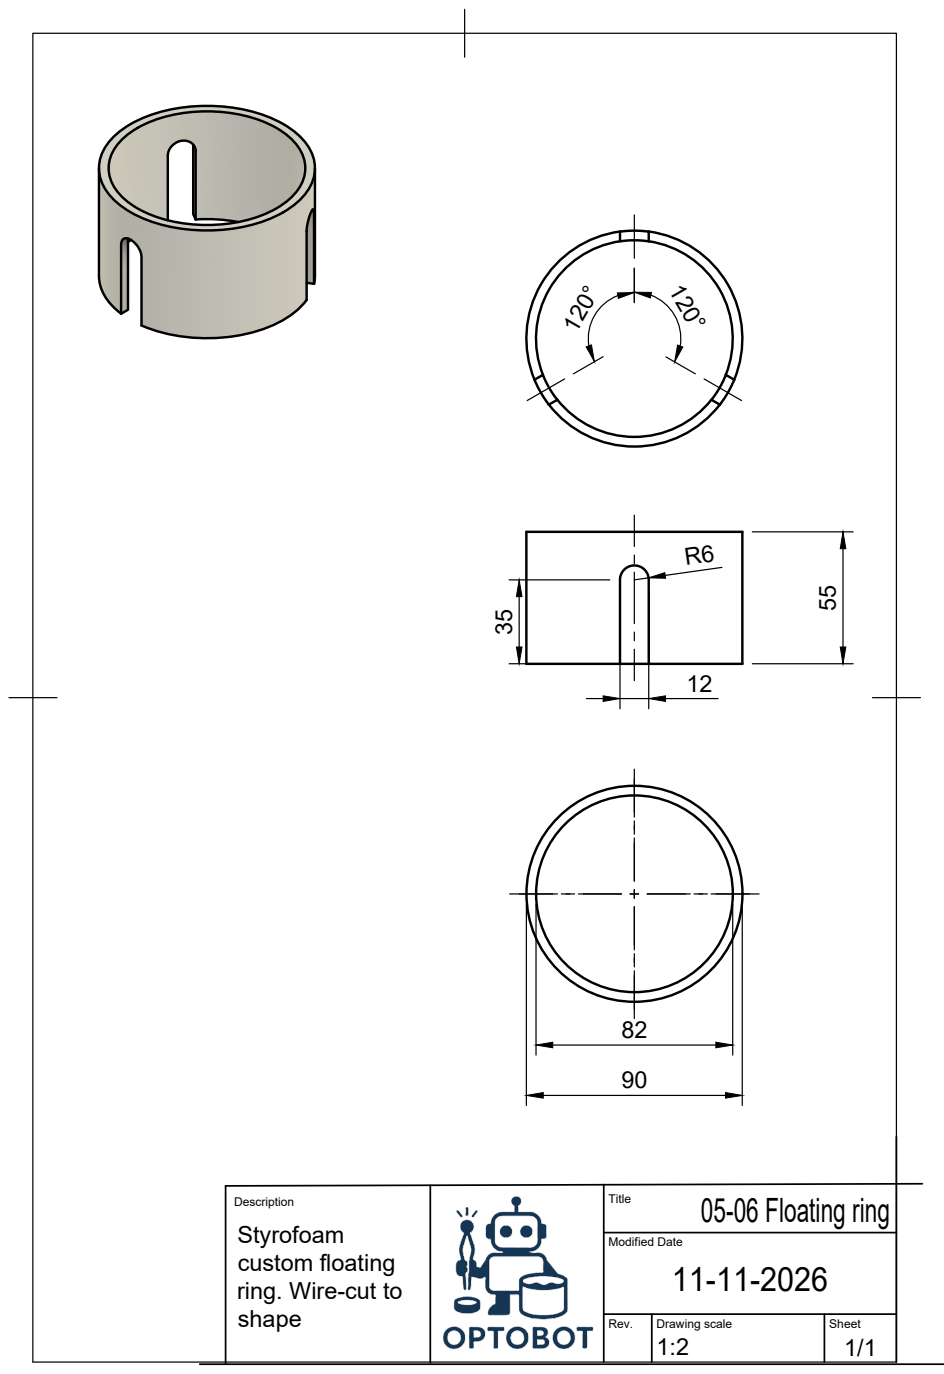
[picture p189: page 1]
Modified Date; Rev.; Drawing scale; Sheet; 05-06 Floating ring

Description
Styrofoam
custom floating
ring. Wire-cut to
shape
