cryoTUD/optobot/modules/06_Support_structure/Assembly/06 Support structure Assembly Drawing.pdf

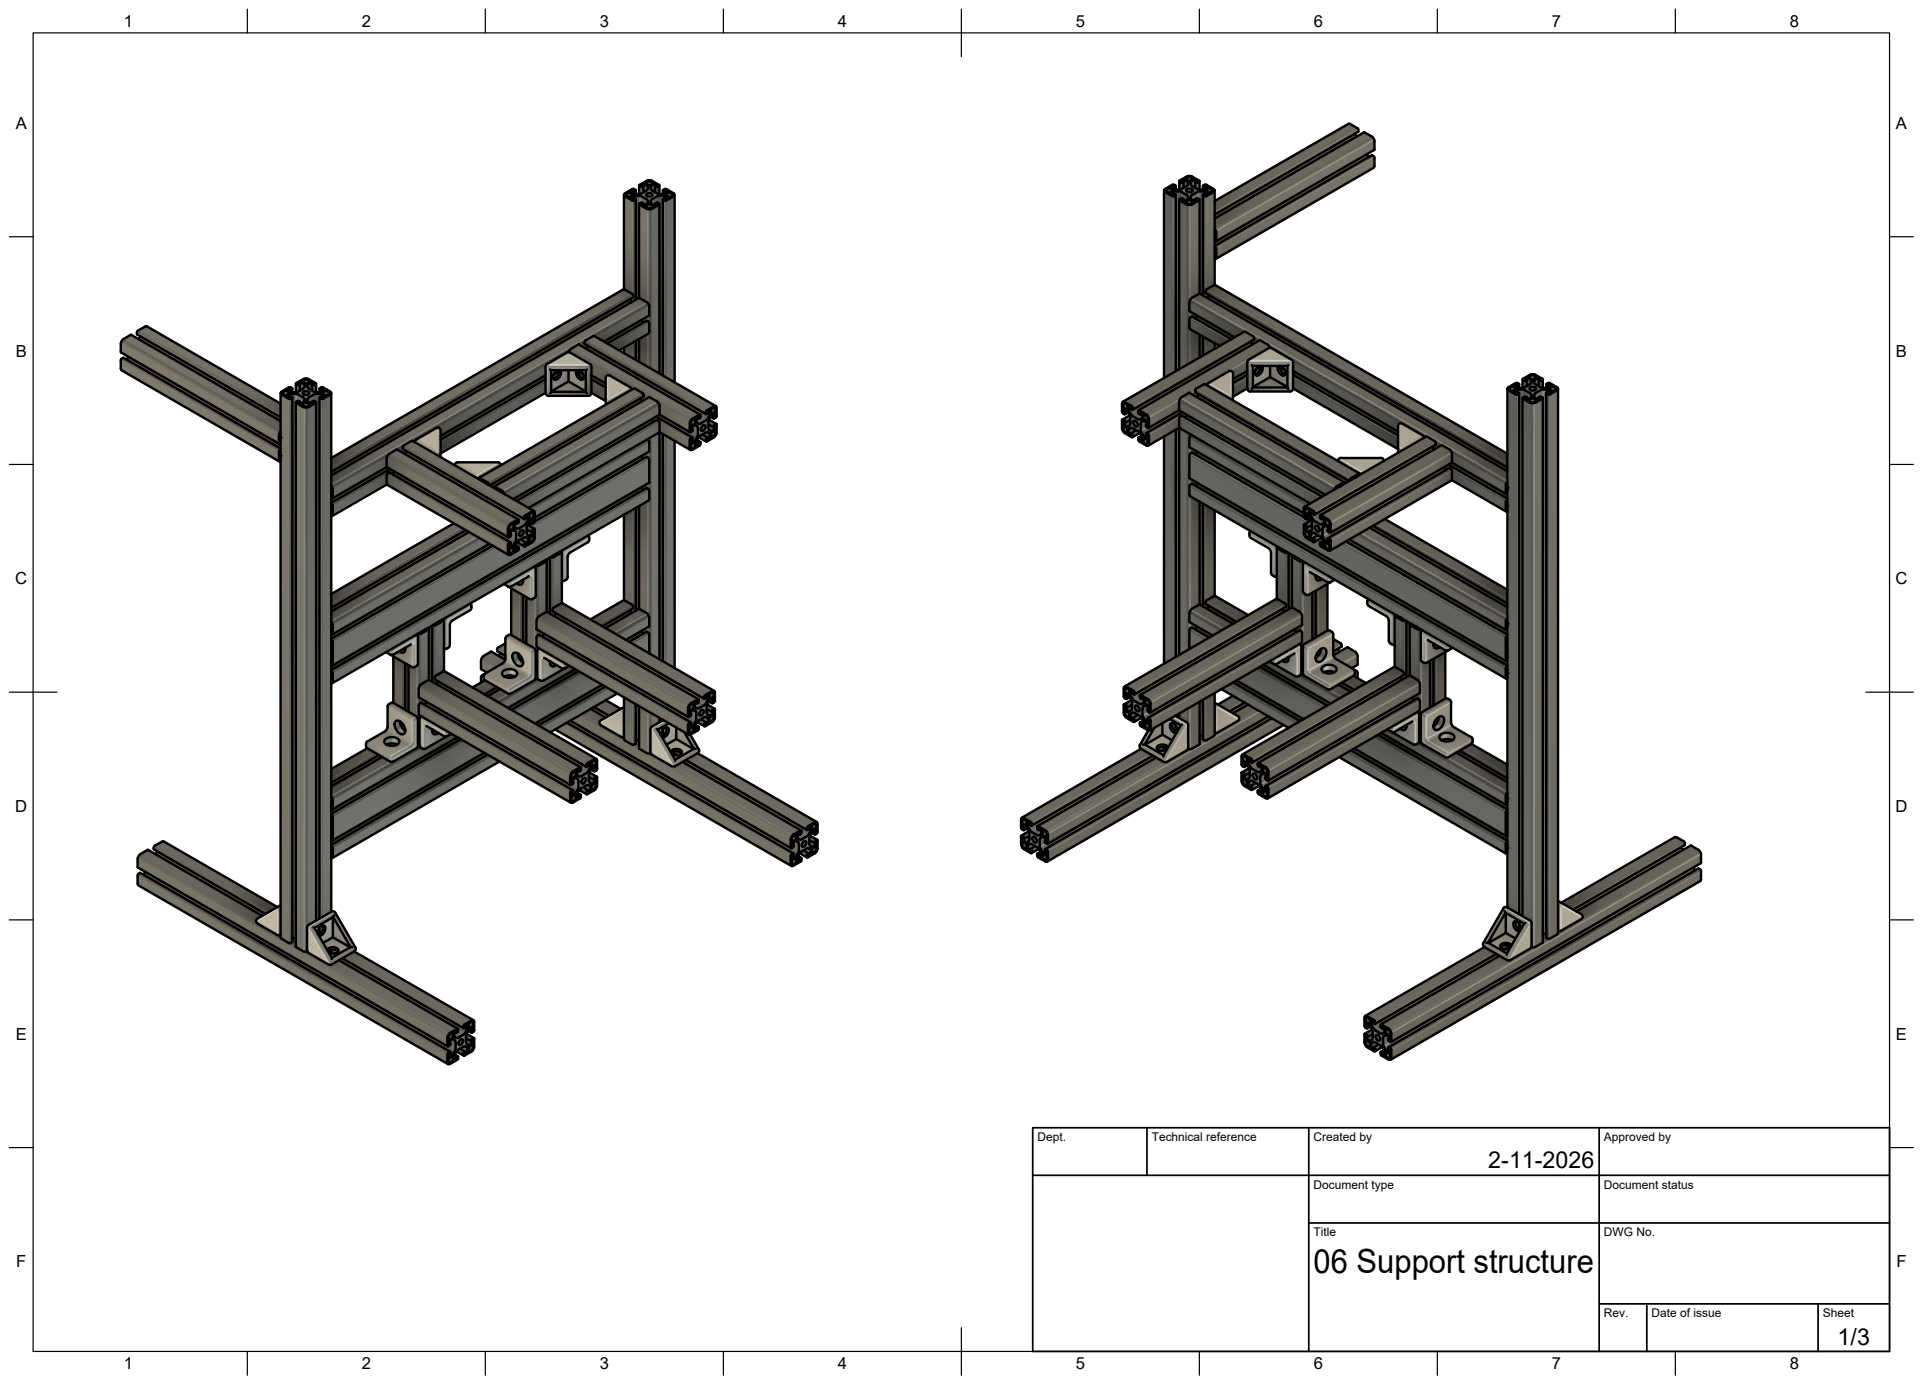
[picture p190: page 1]
Title; DWG No.; Rev.; Date of issue; Sheet; 06 Support structure

Dept. | Technical reference | Created by 2-11-2026 | Approved by

Document type | Document status

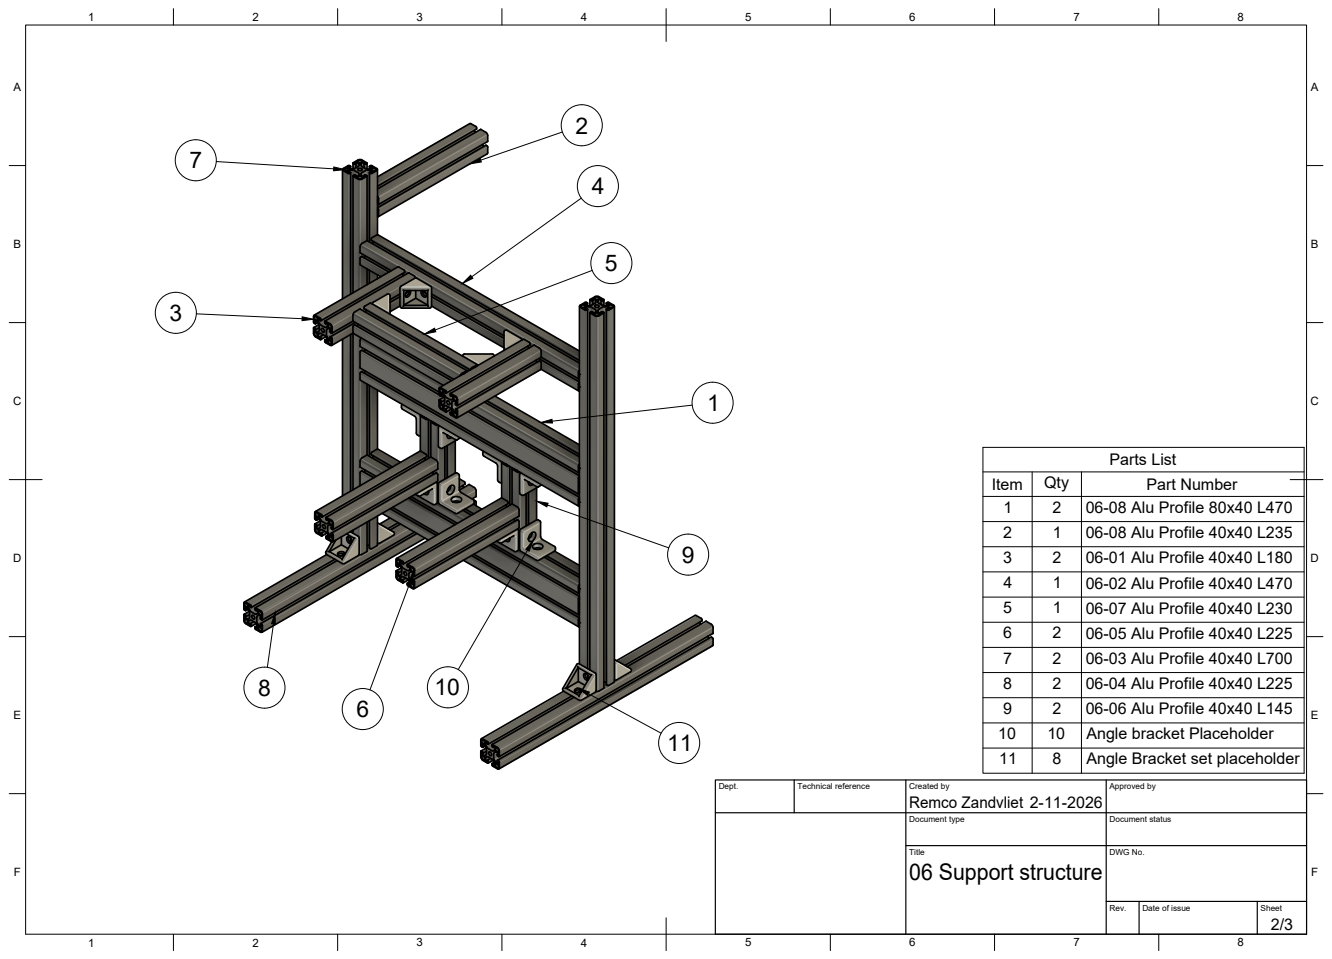
[picture p191: page 2]
Title; DWG No.; 06 Support structure; Parts List

Item | Qty | Part Number
1 | 2 | 06-08 Alu Profile 80x40 L470
2 | 1 | 06-08 Alu Profile 40x40 L235
3 | 2 | 06-01 Alu Profile 40x40 L180
4 | 1 | 06-02 Alu Profile 40x40 L470
5 | 1 | 06-07 Alu Profile 40x40 L230
6 | 2 | 06-05 Alu Profile 40x40 L225
7 | 2 | 06-03 Alu Profile 40x40 L700
8 | 2 | 06-04 Alu Profile 40x40 L225
9 | 2 | 06-06 Alu Profile 40x40 L145
10 | 10 | Angle bracket Placeholder
11 | 8 | Angle Bracket set placeholder

Dept. | Technical reference | Created by Remco Zandvliet 2-11-2026 | Approved by

Document type | Document status

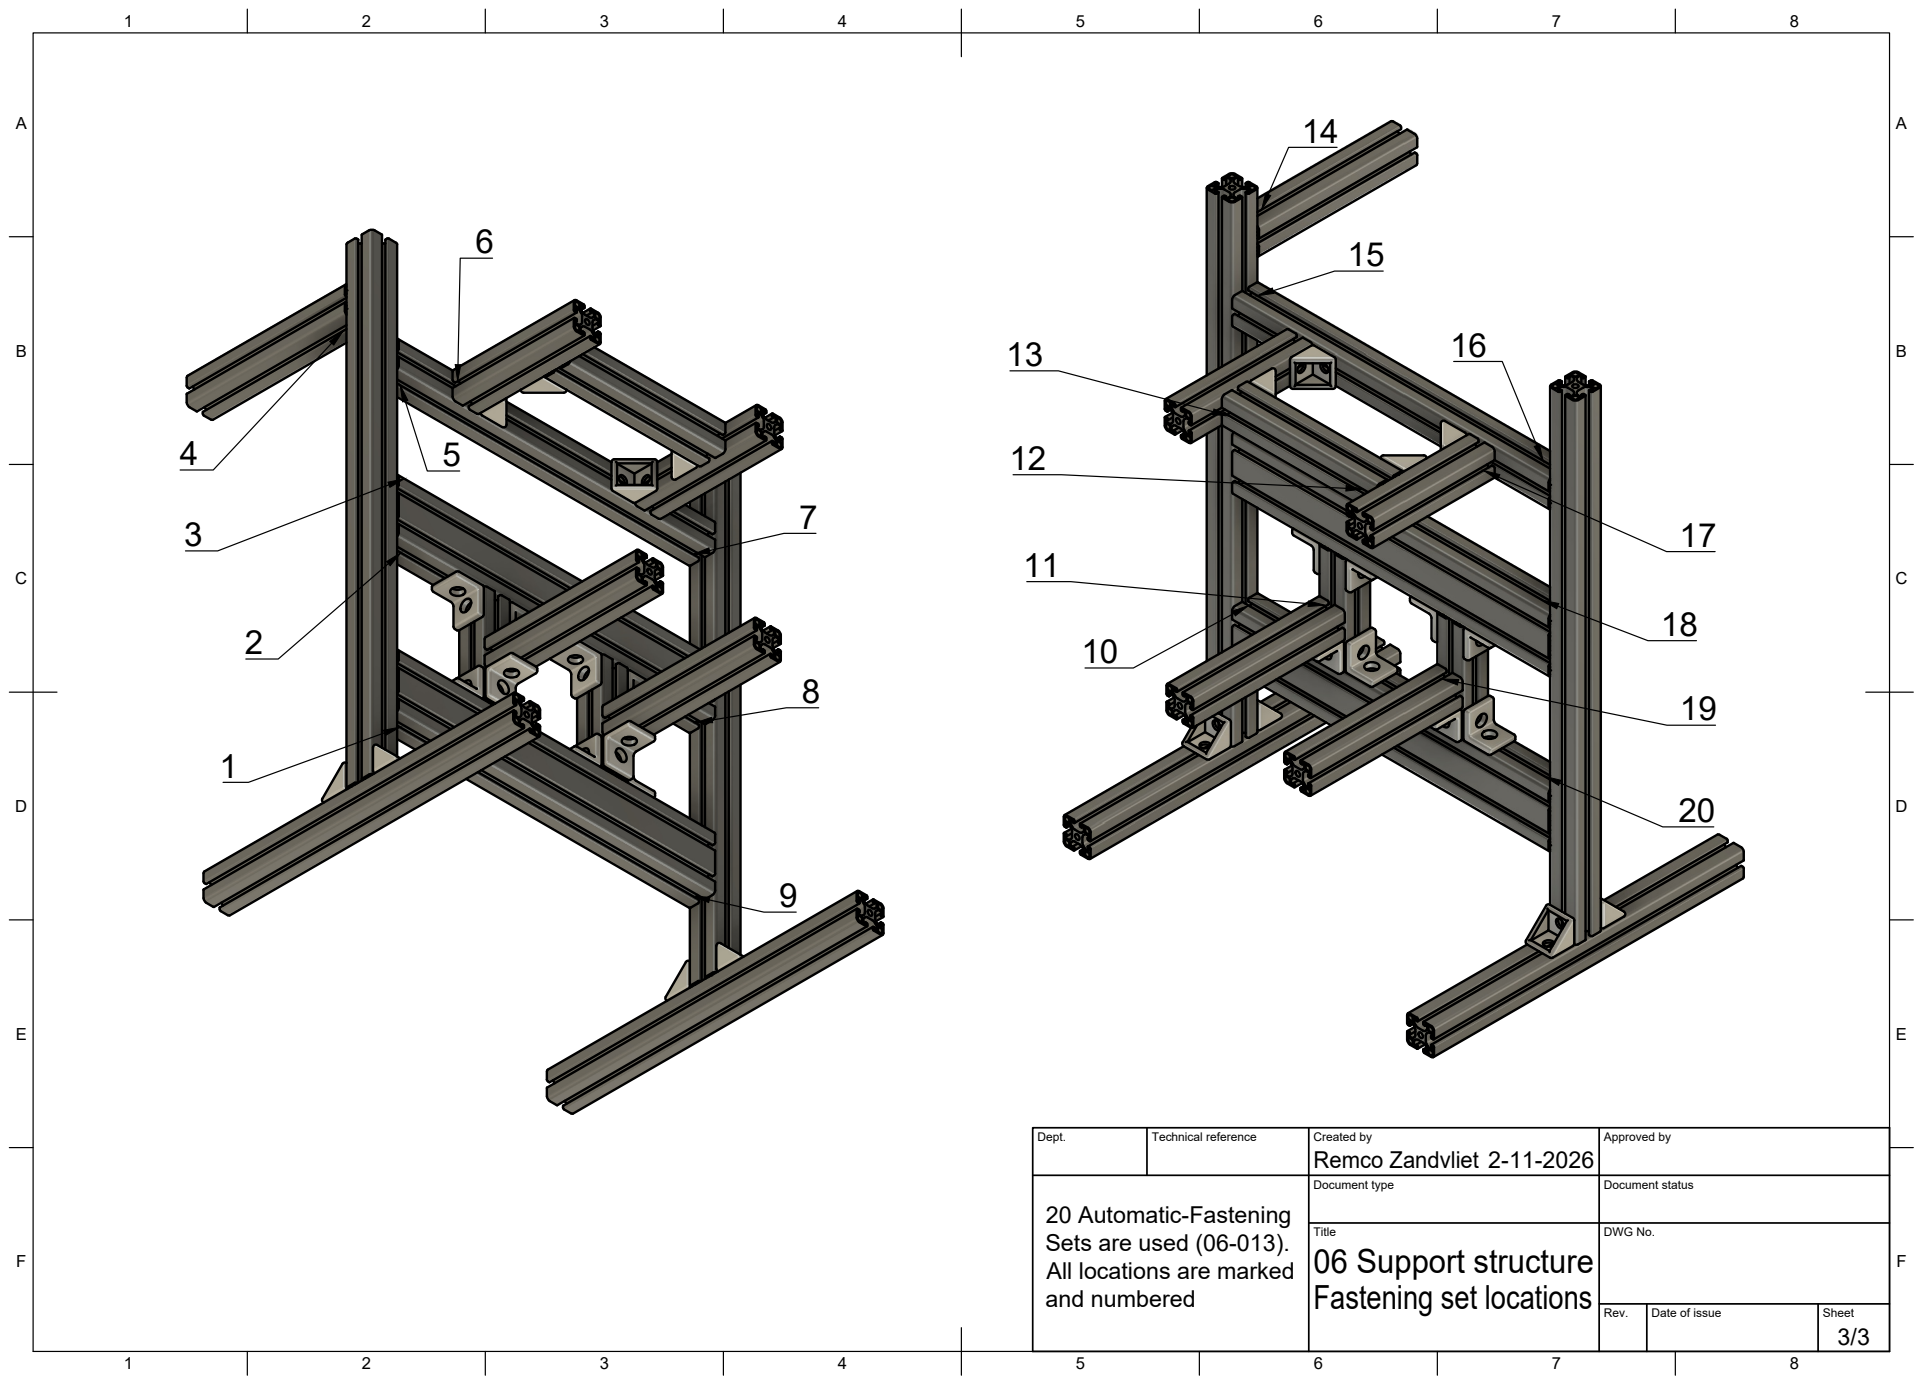
[picture p192: page 3]
Title; DWG No.

Dept. | Technical reference | Created by Remco Zandvliet 2-11-2026 | Approved by

Document type | Document status

20 Automatic-Fastening
Sets are used (06-013).
All locations are marked
and numbered

06 Support structure
Fastening set locations
