cryoTUD/optobot/(commit log)

2026-11-11 Upload of CAD files, Renders & Assembly drawings
2026-11-11 Submit CAD Asssembly files
2026-11-11 Upload wiring diagrams
